wyolum/ClockIOT/Wiki/Images/ClockIOT_Flash_03.png

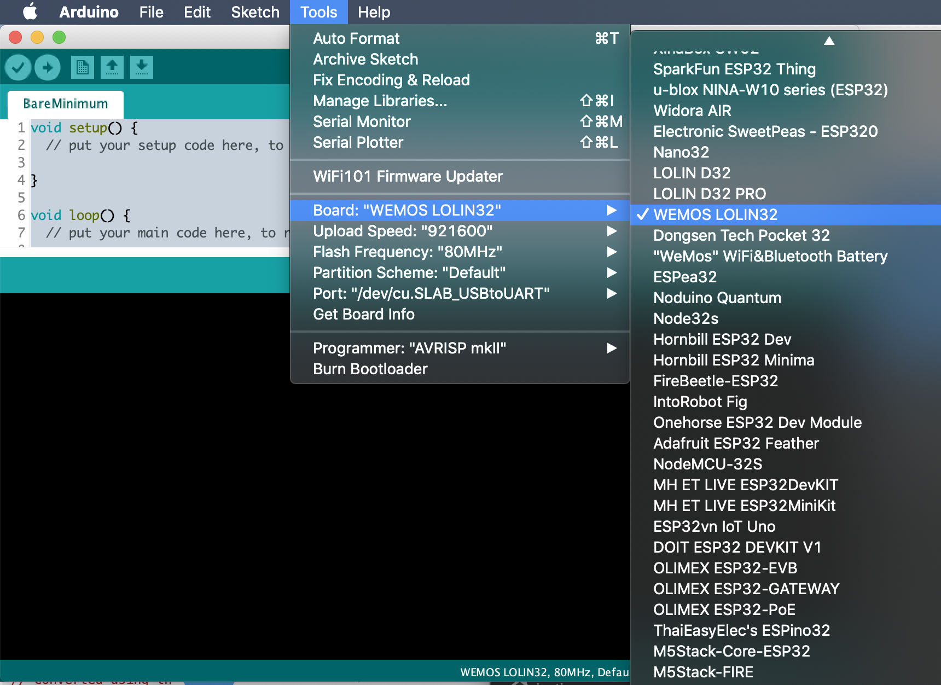
Wiki/Images/ClockIOT_Flash_03.png
