wyolum/ClockIOT/README.md

# ClockIOT
Word Clock

/kicad will be the latest HW version.
Earlier versions get sequentially numbered _v0, _v1 etc.
