wyolum/ClockIOT/arduino/ClockIOT/README.txt

To compile with Arduino:

Select WEMOS LOLIN32 from Tools->Board menu
