wyolum/ClockIOT/kicad/seeed_production_files/ClockIOT_PCB/ClockIOT_PCB_specification.xlsx

Sheet: Template
PCB Name 名称 | ClockIOT rev 5
Board Size 尺寸 | Length*width (Unit:inch) | 6.4 | * | 7.65
Material 板材 | (Rigid) FR－4 | Special Requirement:
Layers 层数 | 2 | Special Requirement:
Thickness 厚度 | 1.6 mm | Special Requirement:
Copper Weight 铜厚 | 1 oz. | Special Requirement:
Soldermask Color 阻焊颜色 | BLACK | Special Requirement:
Silkscreen Color 丝印颜色 | WHITE | Special Requirement:
Surface Finishing 焊盘喷镀 | HASL Lead Free | Special Requirement:
Via soldermask 阻焊覆盖 | Soldermask Cover | Special Requirement:
Mini trace/spacing 最小线宽 | 0.20 mm | Special Requirement:
Mini hole size 最小孔径 | 0.40 mm | Special Requirement:
Special requirements 特殊工艺
 | Other Special requirements：

Sheet: Parameter
PCB Material | Layers | Thickness | Copper Weight | Soldermask Color | Silkscreen Color | Surface Finishing | Via soldermask | Mini trace/spacing | Mini hole size
FR-4 | 1 Layer | 0.6mm | 0.5 oz | Green | White | HASL Lead Free(RoHS) | Soldermask Cover | 4 mil or 0.10 mm | 6 mil or 0.15 mm
Flexible Printed Circuit | 2 Layer | 0.8mm | 1 oz | Red | Black | ENIG | Soldermask Opening | 5 mil or0.13 mm | 8 mil or 0.2 mm
Rogers 4003 | 4 Layer | 1.0mm | 2 oz | Blue | Yellow | OSP |  | 6 mil or 0.15 mm | 10 mil or 0.25 mm
Rogers 4350 | 6 Layer | 1.2mm | 3 oz | Black | Red | Immersion Tin |  | 8 mil or 0.20 mm | 12 mil or 0.30 mm
Taconic Series | 8 Layer | 1.3mm | Other | White | Other | Immersion Sliver
Aluminum-based material | 10 Layer | 1.6mm |  | Green Matte |  | Hard Gold
RF-35 | 12 Layer | 2.0mm |  | Blue Matte |  | Other
Arlon | 14 Layer | 2.5mm |  | Black Matte
Other | 16 Layer | 3.0mm |  | Other
 | Other | Other
