wyolum/ClockIOT/collateral/ClockIoT_QR_code_neg.jpg.pdf

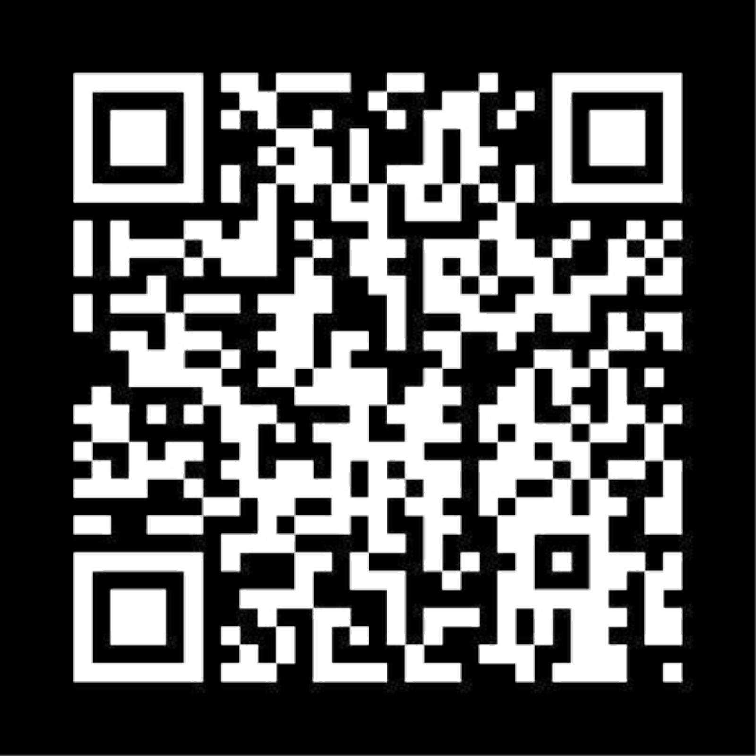
[picture p3: page 1]
