wyolum/ClockIOT/arduino/hardware/espressif/esp32/tools/partitions/default.csv

# Name | Type | SubType | Offset | Size | Flags
nvs | data | nvs | 0x9000 | 0x5000
otadata | data | ota | 0xe000 | 0x2000
app0 | app | ota_0 | 0x10000 | 0x140000
app1 | app | ota_1 | 0x150000 | 0x140000
eeprom | data | 0x99 | 0x290000 | 0x1000
spiffs | data | spiffs | 0x291000 | 0x16F000
