wyolum/ClockIOT/ClockIOT_data/USB-C_breakout/0J9079.1200.jpg

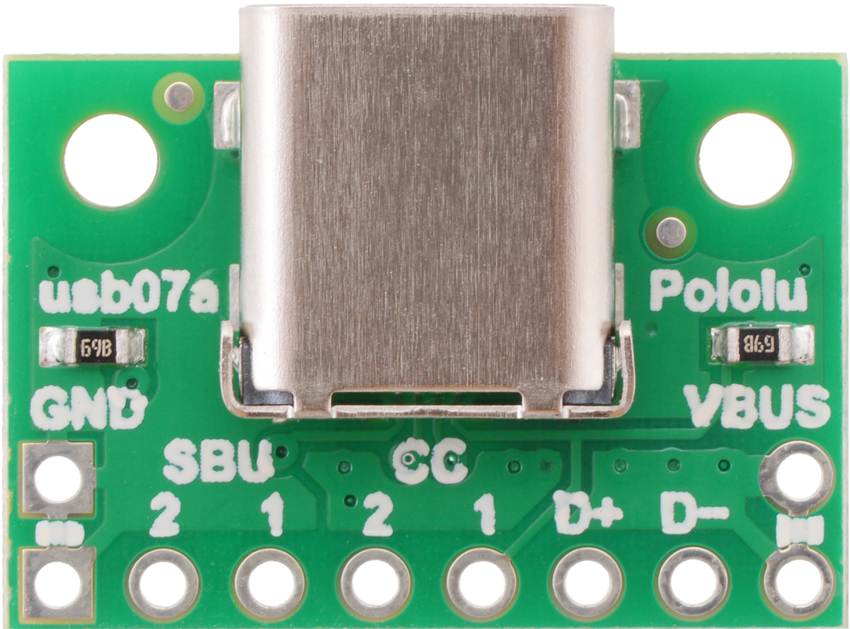
ClockIOT_data/USB-C_breakout/0J9079.1200.jpg
