wyolum/ClockIOT/ClockIOT_data/USB-C_breakout/0J9080.600x480.jpg

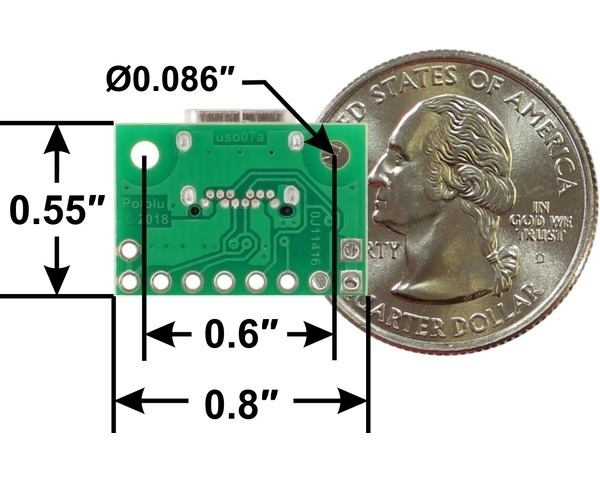
ClockIOT_data/USB-C_breakout/0J9080.600x480.jpg
