wyolum/ClockIOT/kicad/3d_render/ClockIOT01.png

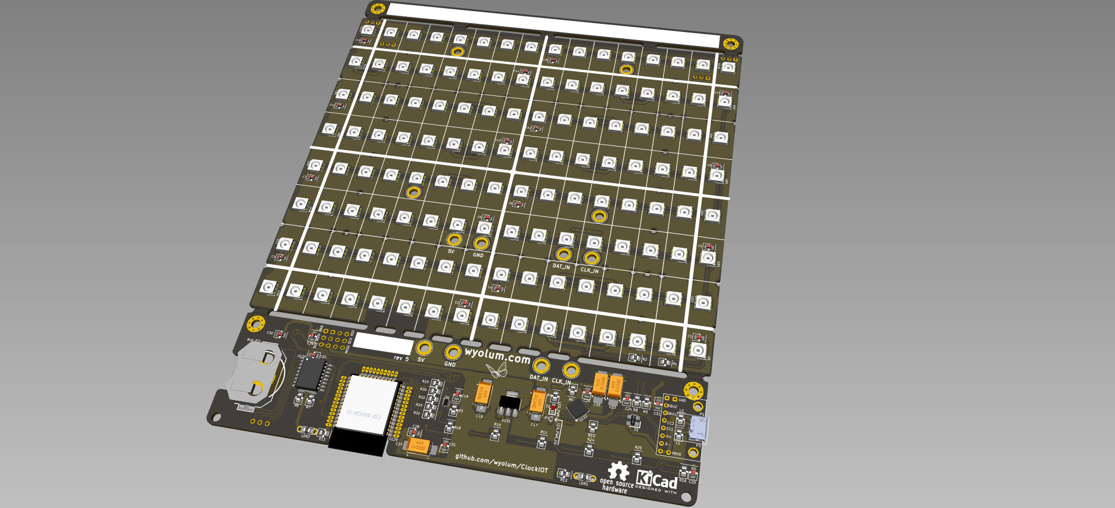
kicad/3d_render/ClockIOT01.png
