wyolum/ClockIOT/kicad/3d_render/ClockIOT02.png

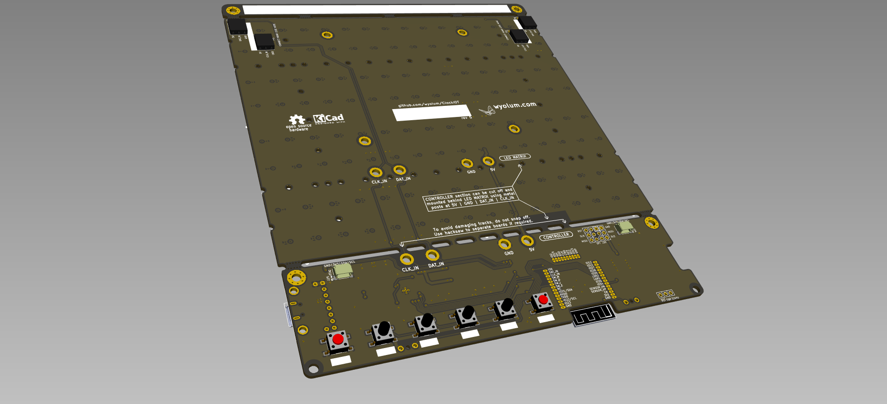
kicad/3d_render/ClockIOT02.png
