wyolum/ClockIOT/kicad/3d_render/ClockIOT03.png

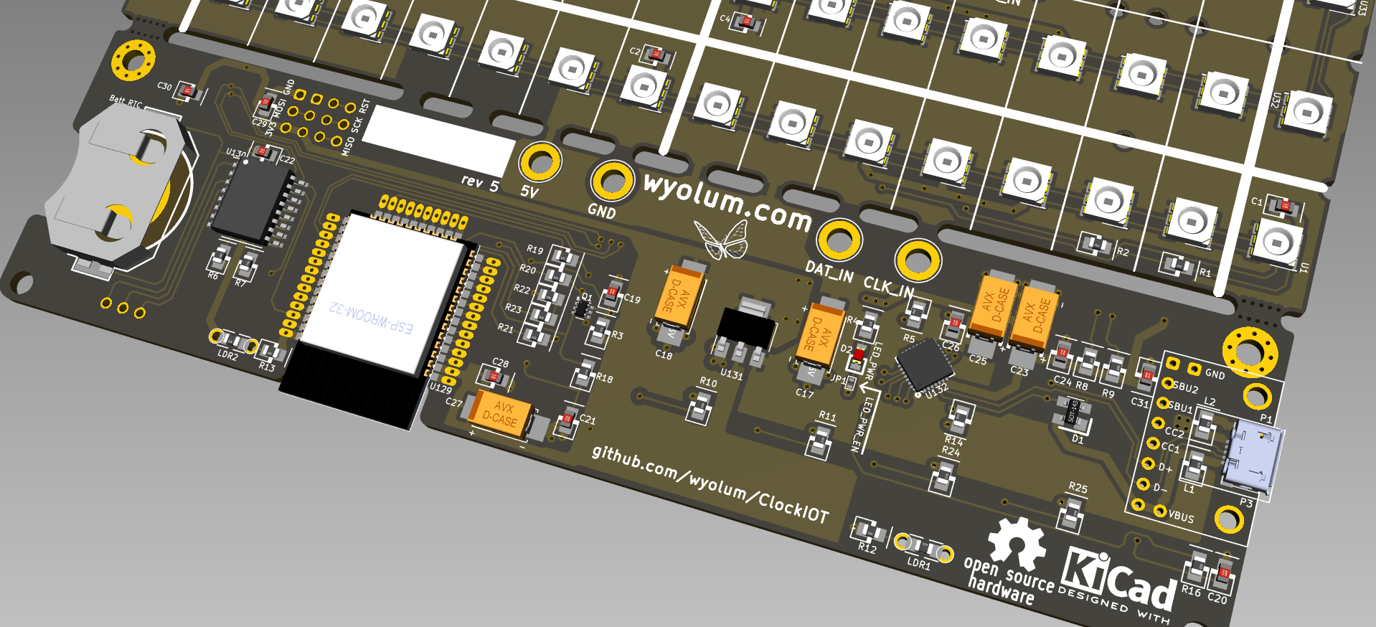
kicad/3d_render/ClockIOT03.png
