wyolum/ClockIOT/kicad/3d_render/ClockIOT04.png

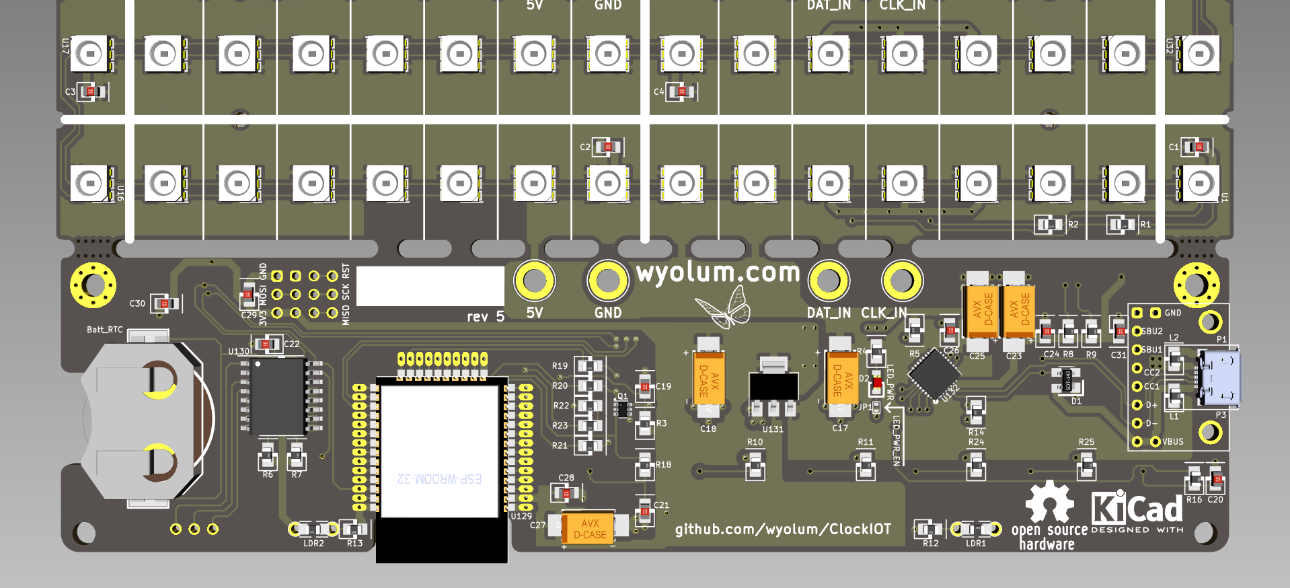
kicad/3d_render/ClockIOT04.png
