wyolum/ClockIOT/kicad/3d_render/ClockIOT05.png

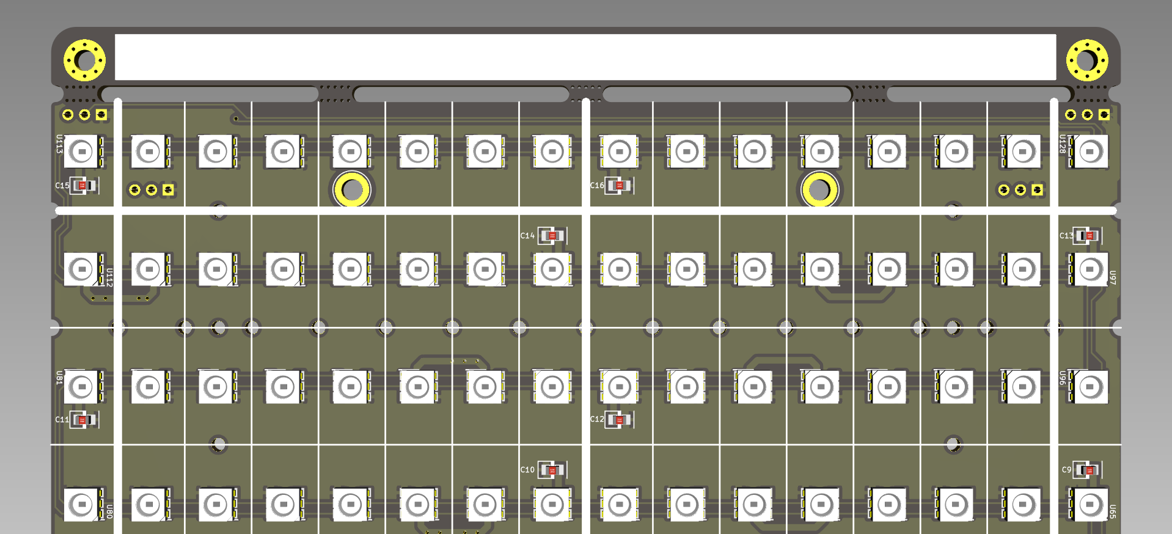
kicad/3d_render/ClockIOT05.png
