wyolum/ClockIOT/kicad/3d_render/ClockIOT06.png

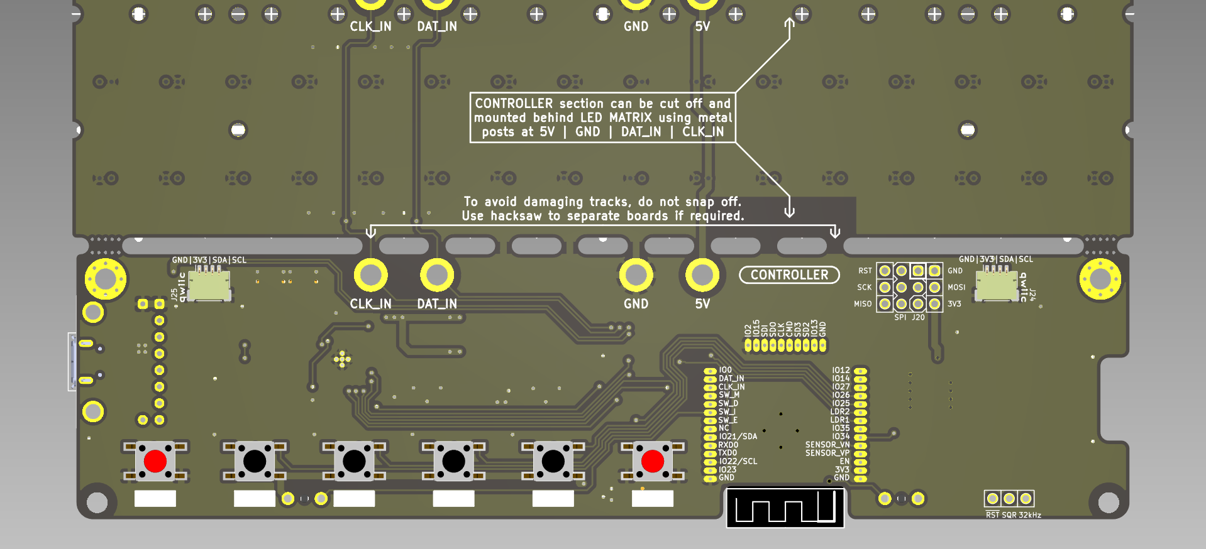
kicad/3d_render/ClockIOT06.png
