wyolum/ClockIOT/kicad/3d_render/ClockIOT07.png

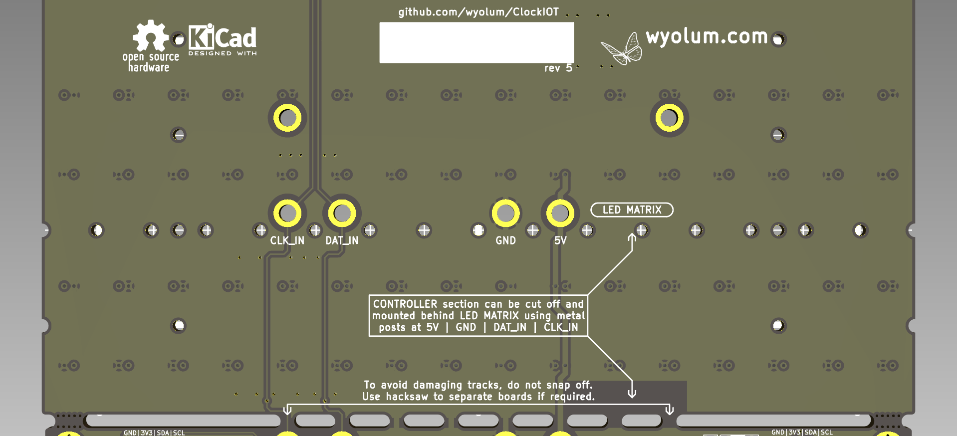
kicad/3d_render/ClockIOT07.png
