wyolum/ClockIOT/kicad/3d_render/ClockIOT08.png

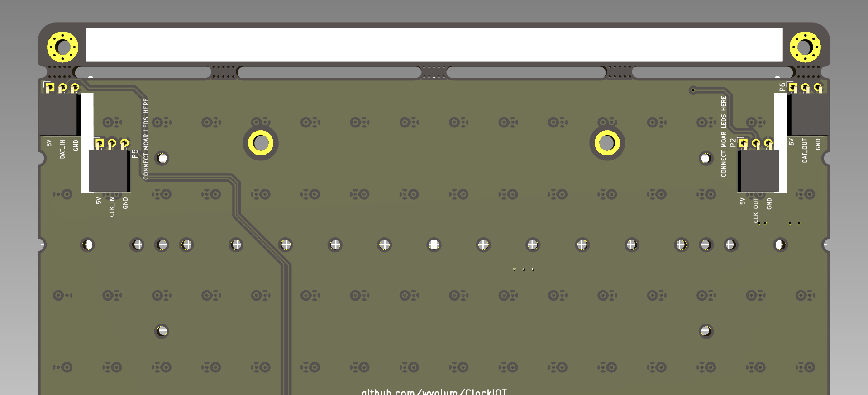
kicad/3d_render/ClockIOT08.png
