wyolum/ClockIOT/kicad/3d_render/ClockIOT09.png

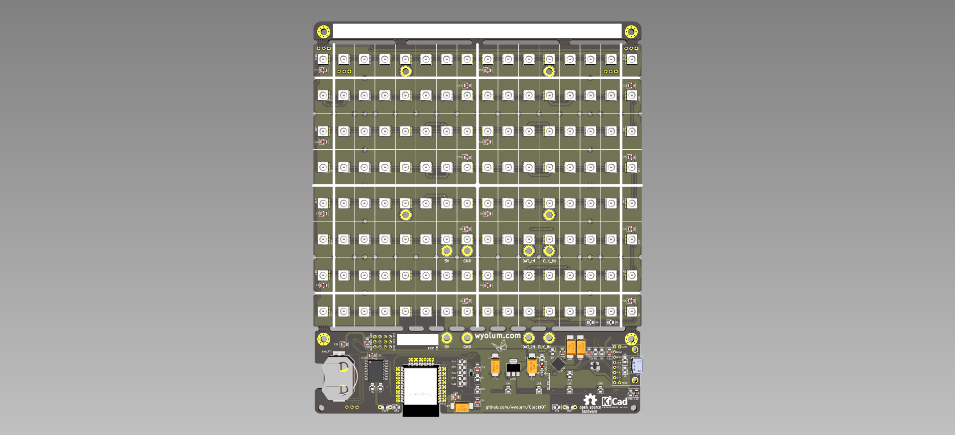
kicad/3d_render/ClockIOT09.png
