wyolum/ClockIOT/kicad/3d_render/ClockIOT10.png

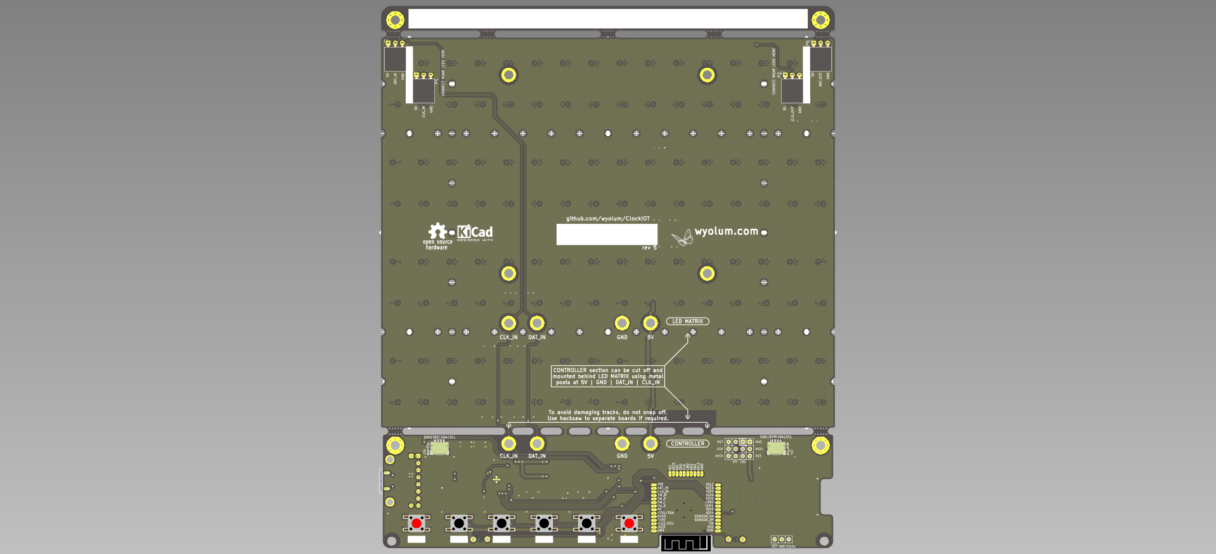
kicad/3d_render/ClockIOT10.png
