wyolum/ClockIOT/kicad/3d_render/ClockIOT11.png

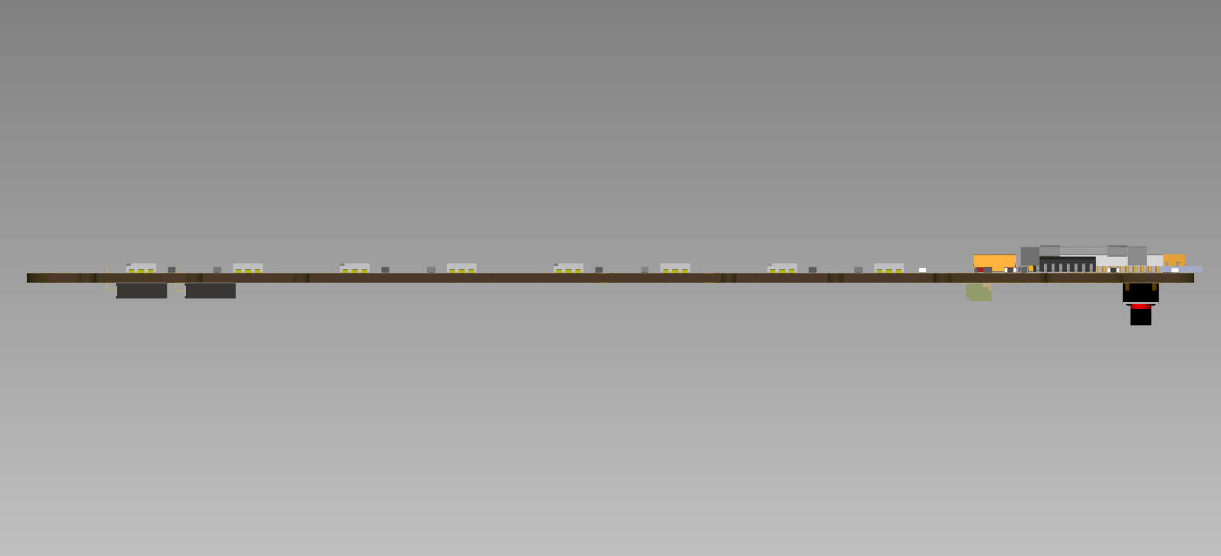
kicad/3d_render/ClockIOT11.png
