wyolum/ClockIOT/kicad/3d_render/ClockIOT12.png

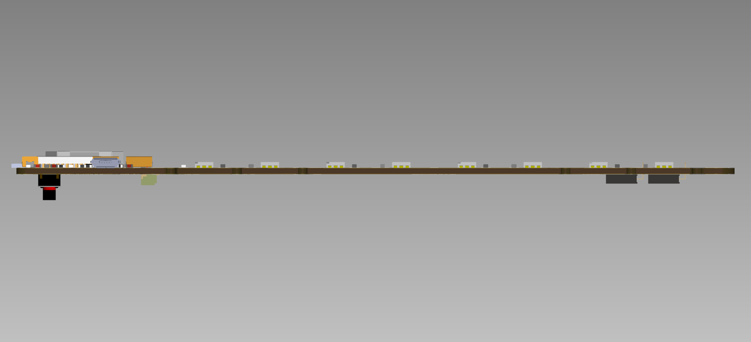
kicad/3d_render/ClockIOT12.png
