wyolum/ClockIOT/kicad/3d_render/ClockIOT13.png

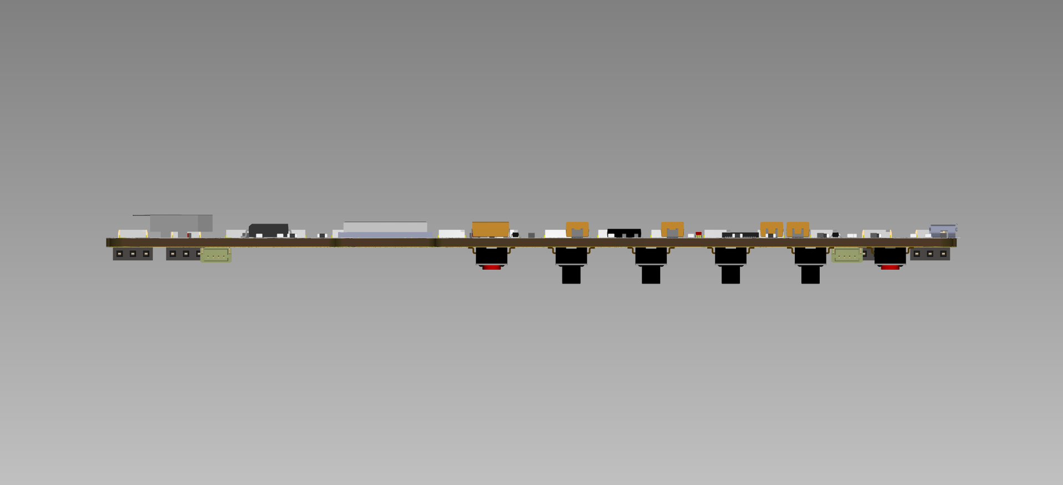
kicad/3d_render/ClockIOT13.png
