wyolum/ClockIOT/kicad/3d_render/ClockIOT15.png

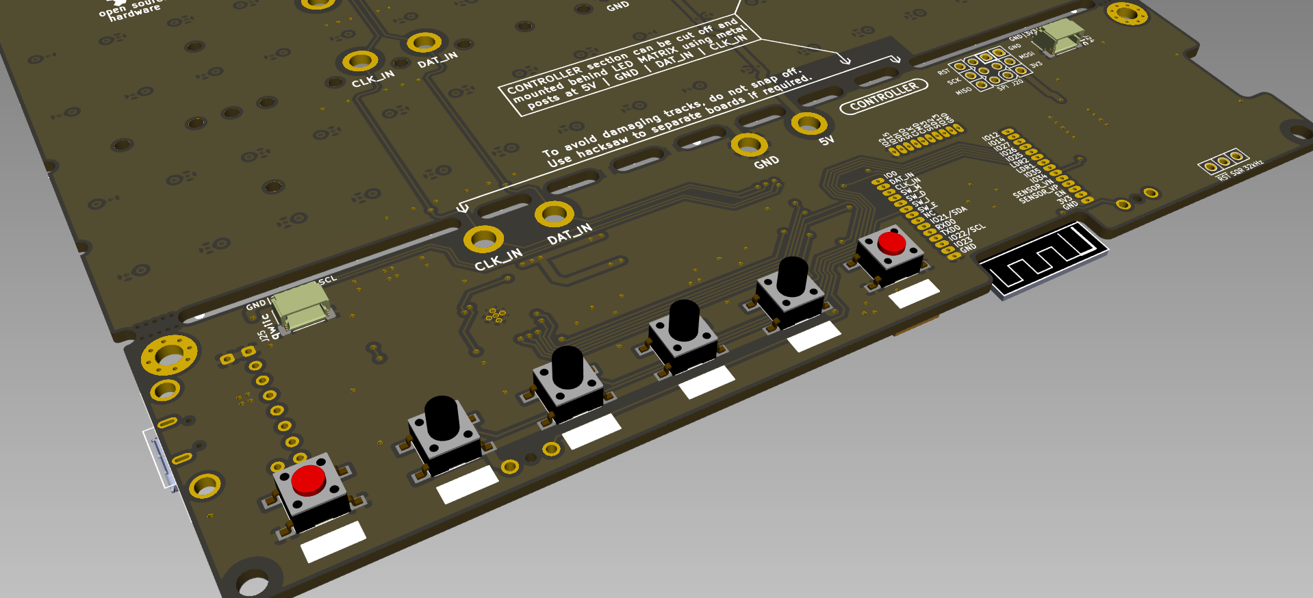
kicad/3d_render/ClockIOT15.png
