wyolum/ClockIOT/kicad/3d_render_with_USB-C/ClockIOT03.png

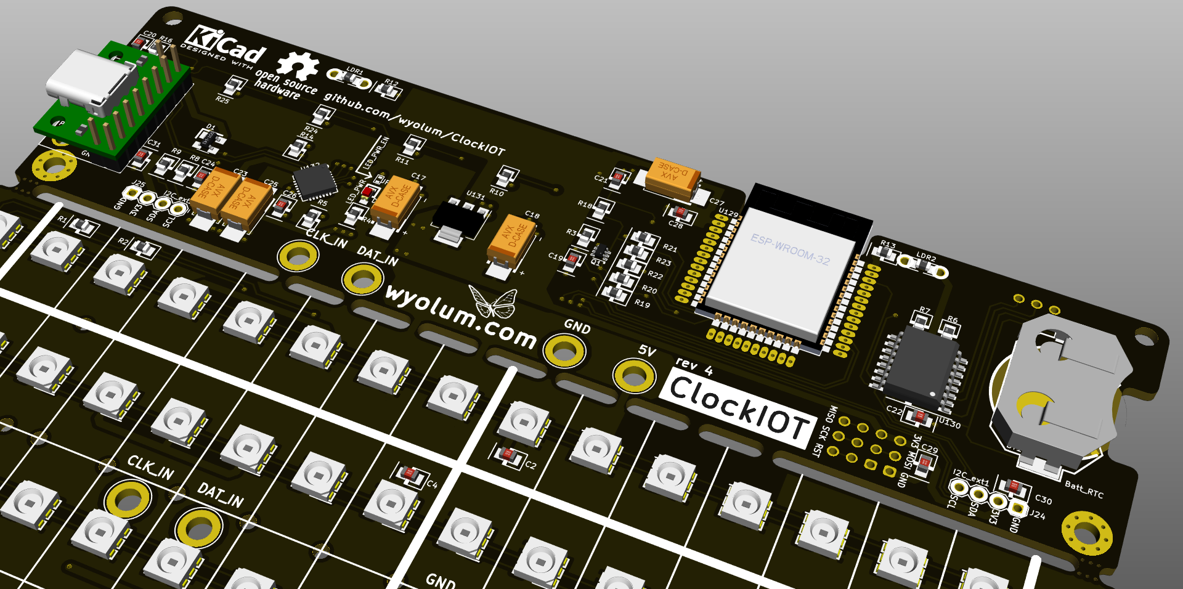
kicad/3d_render_with_USB-C/ClockIOT03.png
