wyolum/ClockIOT/kicad/3d_render_with_USB-C/ClockIOT05.png

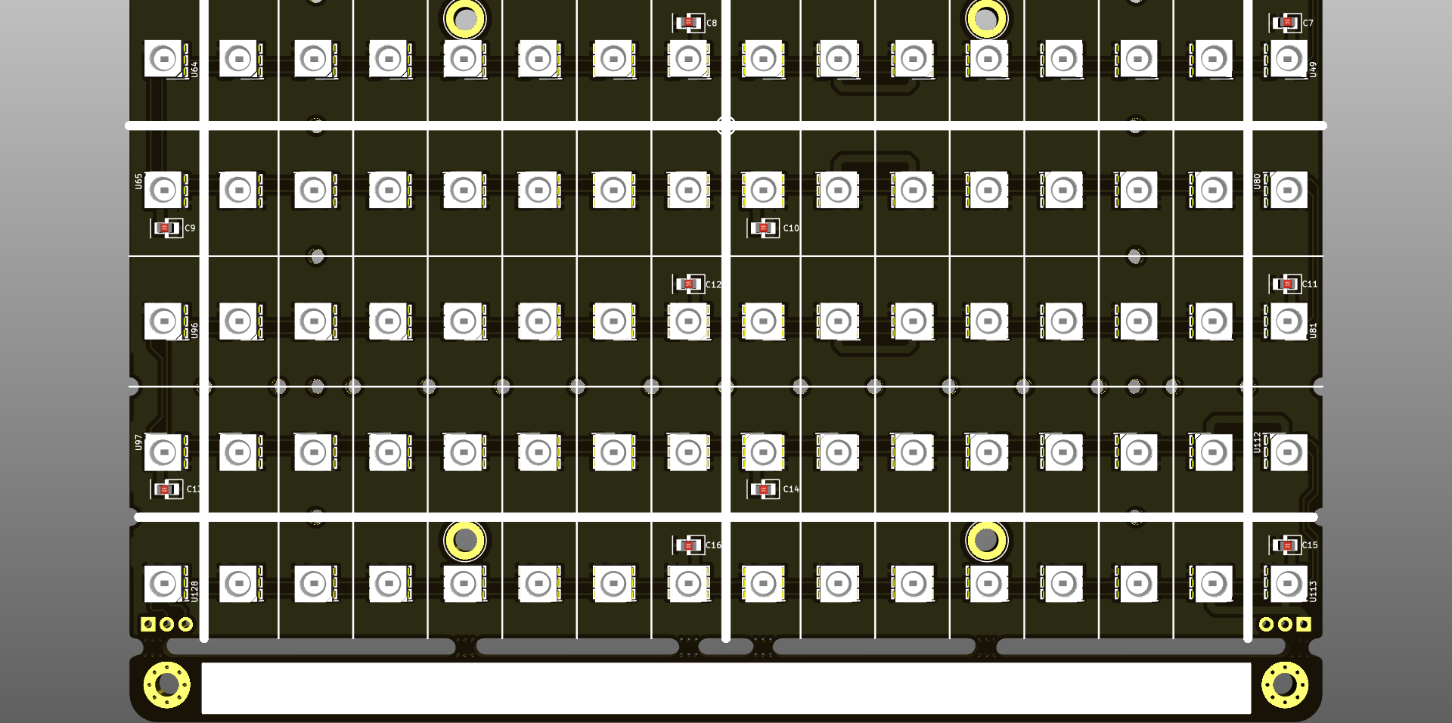
kicad/3d_render_with_USB-C/ClockIOT05.png
