wyolum/ClockIOT/kicad/3d_render_with_USB-C/ClockIOT06.png

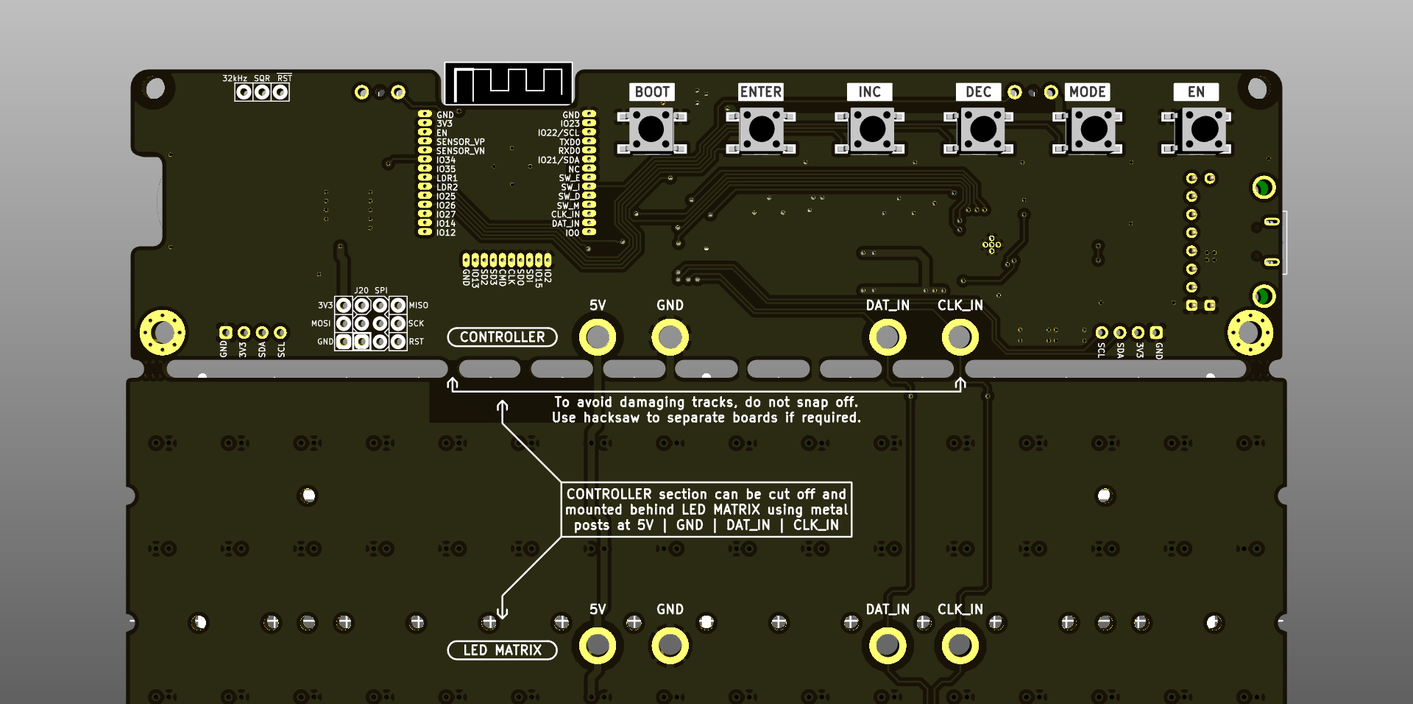
kicad/3d_render_with_USB-C/ClockIOT06.png
