wyolum/ClockIOT/kicad/3d_render_with_USB-C/ClockIOT09.png

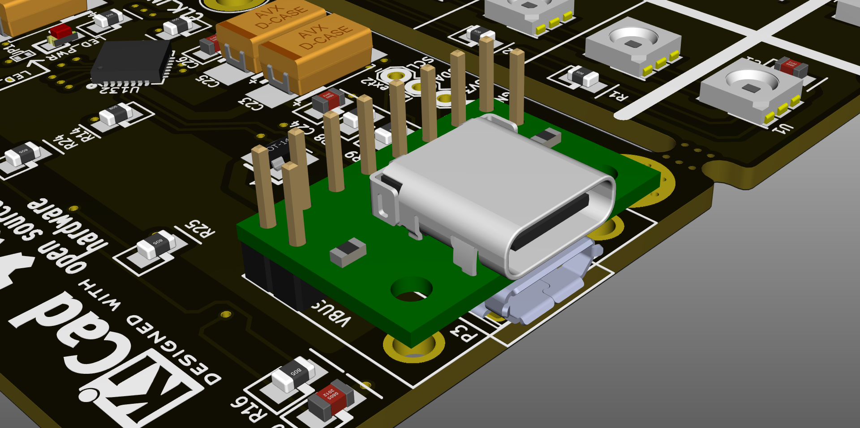
kicad/3d_render_with_USB-C/ClockIOT09.png
