wyolum/ClockIOT/kicad/seeed_production_files/collateral/ClockIOT_sticker.png

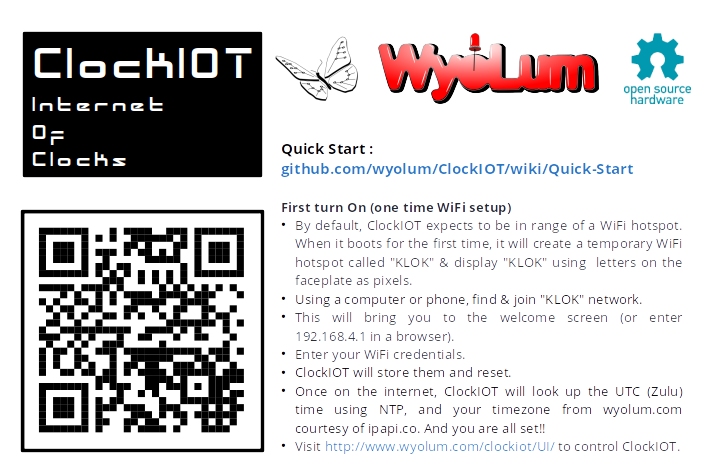
kicad/seeed_production_files/collateral/ClockIOT_sticker.png
