wyolum/ClockIOT/kicad/seeed_production_files/Power_Supply/power supply 1.jpg

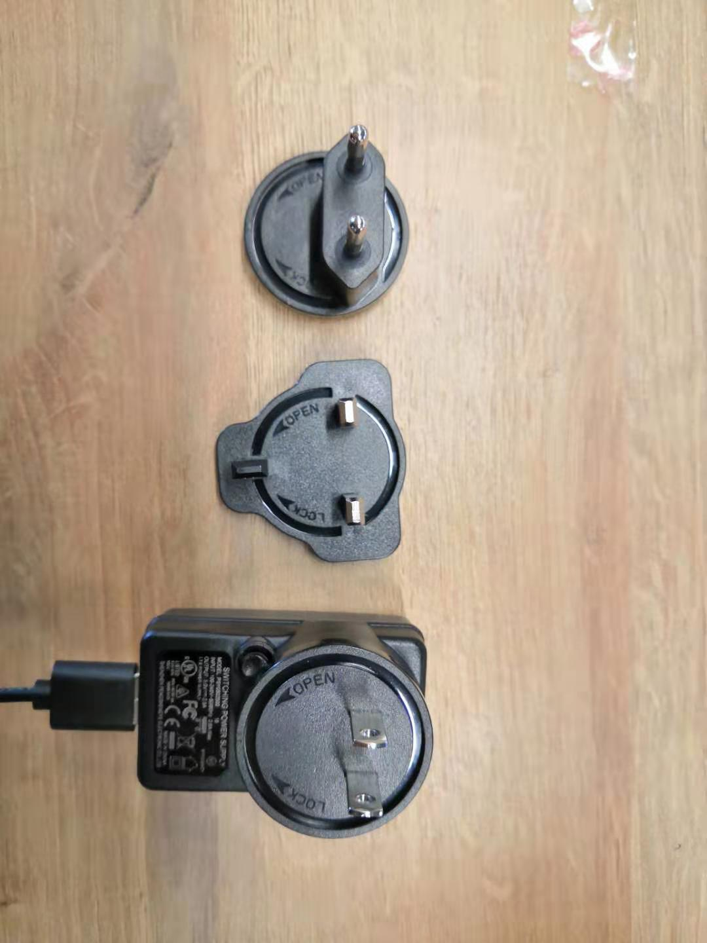
kicad/seeed_production_files/Power_Supply/power supply 1.jpg
