wyolum/ClockIOT/kicad/seeed_production_files/Power_Supply/power supply 2.jpg

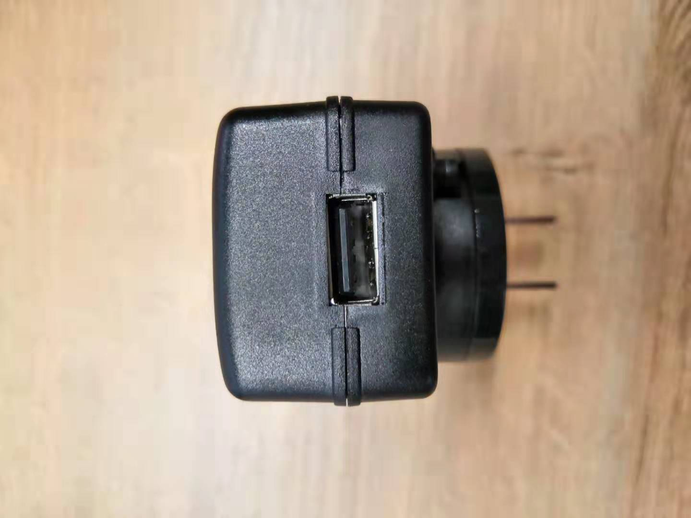
kicad/seeed_production_files/Power_Supply/power supply 2.jpg
