wyolum/ClockIOT/webui/timezonepicker/images/gray-450.png

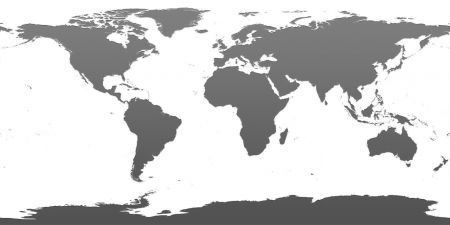
webui/timezonepicker/images/gray-450.png
