wyolum/ClockIOT/Wiki/Images/ClockIOT_Flash_04.1.png

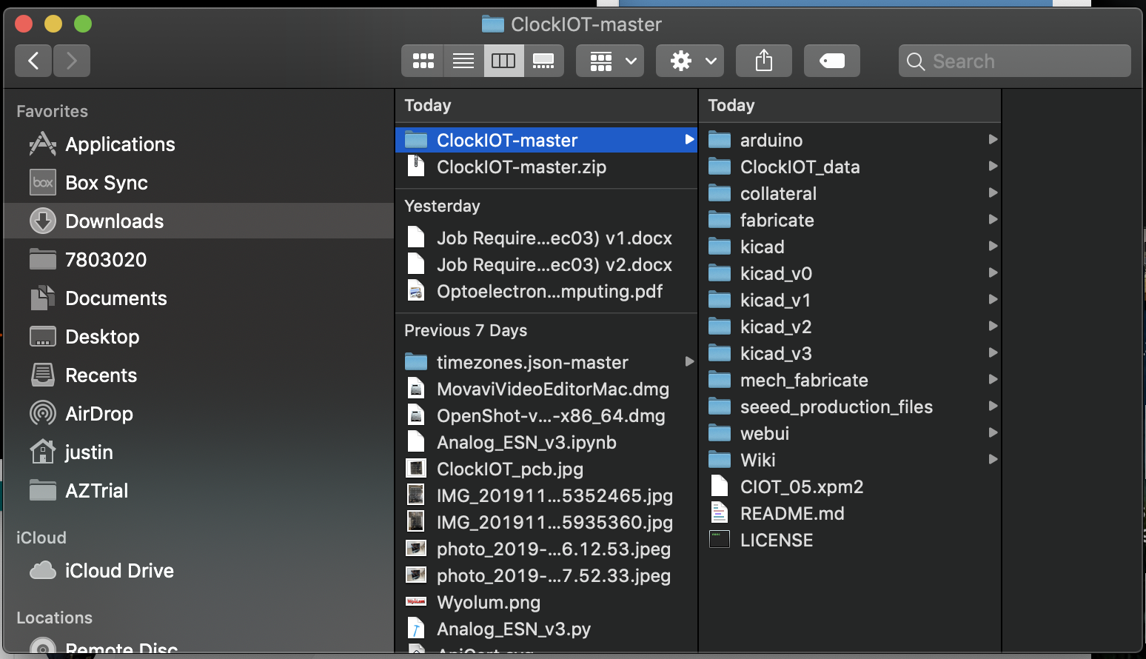
Wiki/Images/ClockIOT_Flash_04.1.png
