wyolum/ClockIOT/Wiki/Images/ClockIOT_Flash_04.png

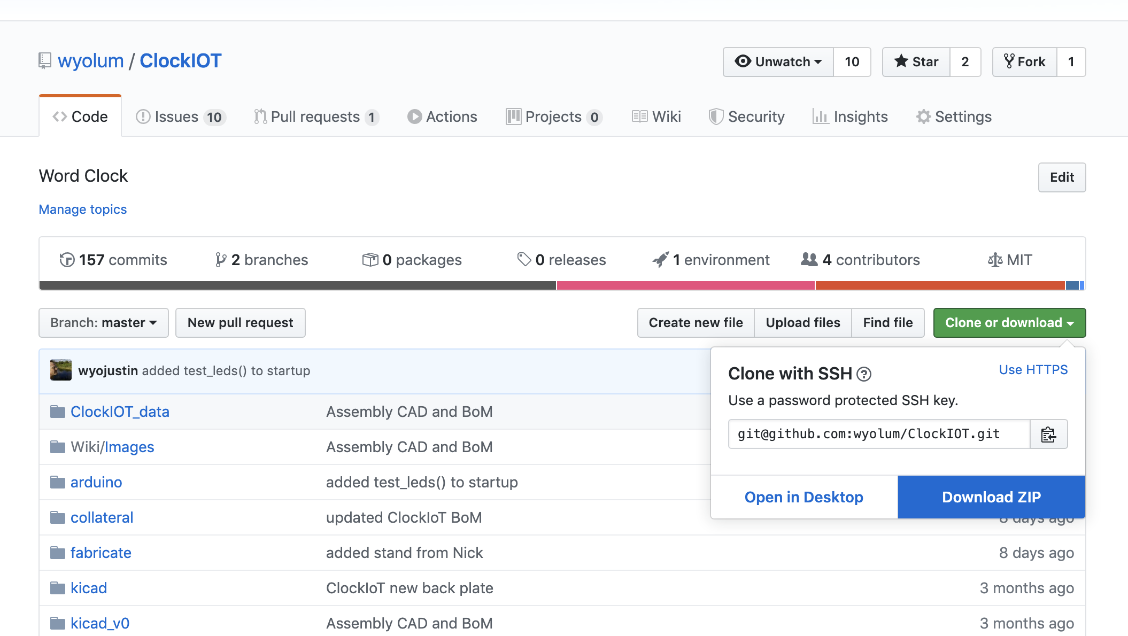
Wiki/Images/ClockIOT_Flash_04.png
