wyolum/ClockIOT/Wiki/Images/ClockIOT_Flash_05.png

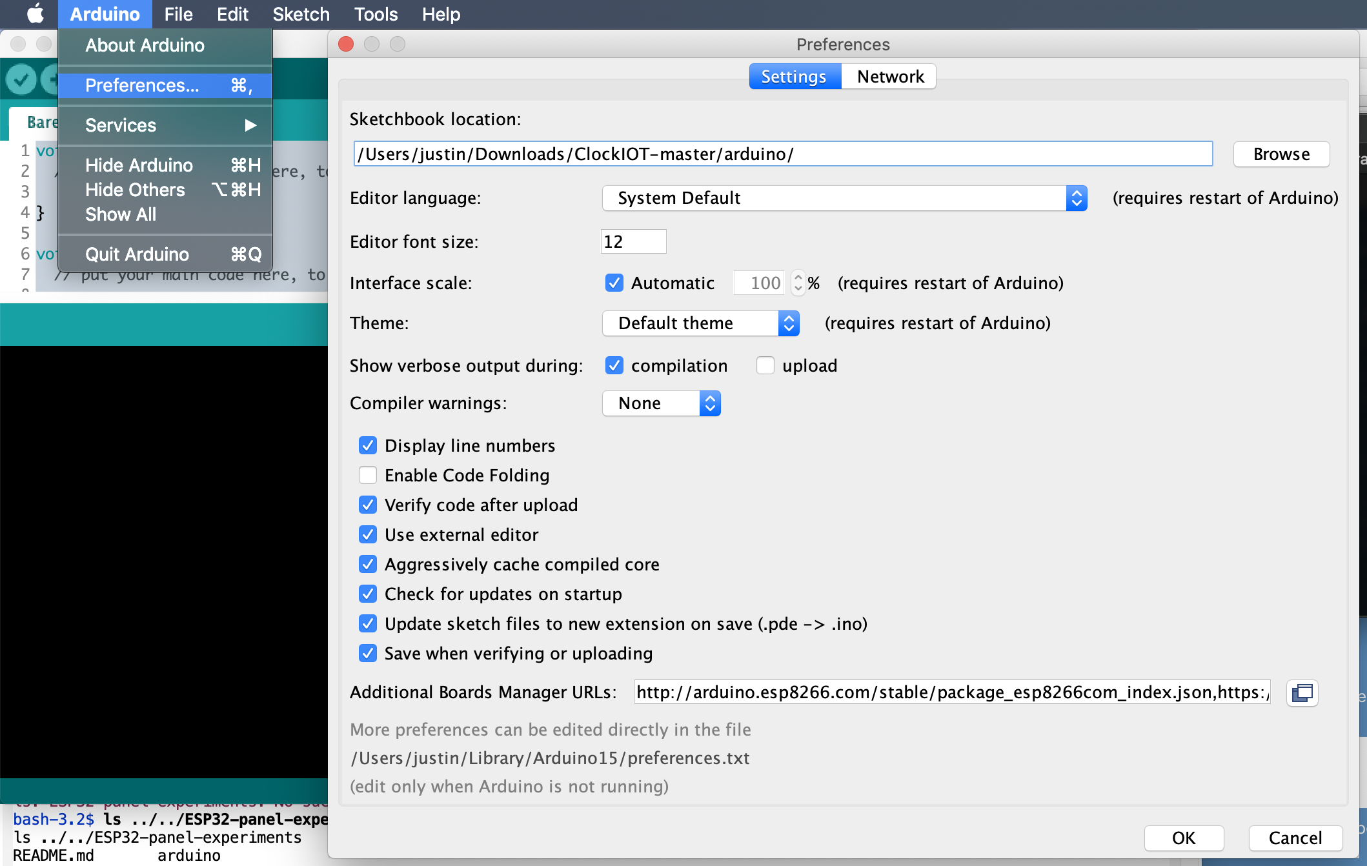
Wiki/Images/ClockIOT_Flash_05.png
