wyolum/ClockIOT/Wiki/Images/ClockIOT_Flash_06.png

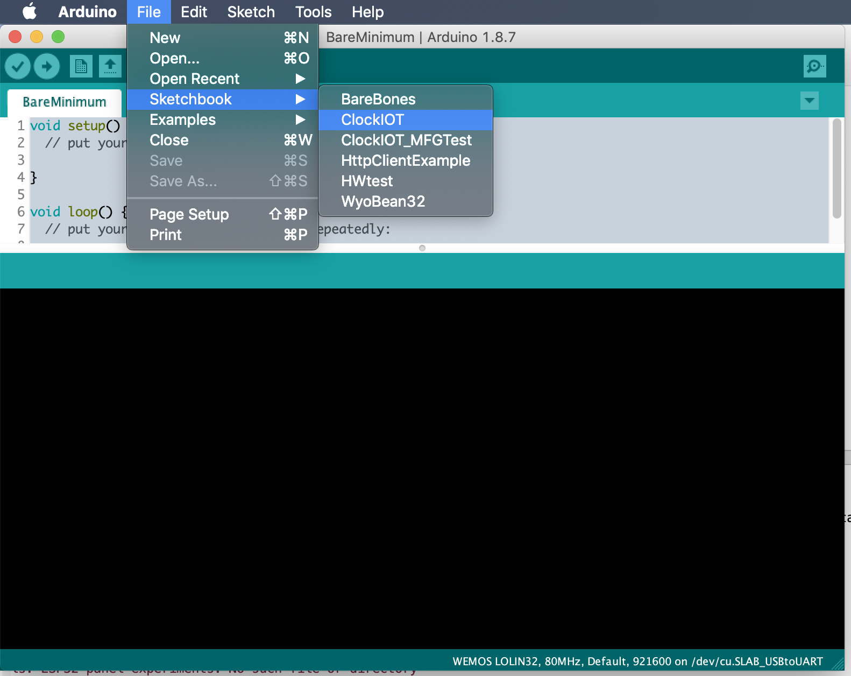
Wiki/Images/ClockIOT_Flash_06.png
