wyolum/ClockIOT/Wiki/Images/ClockIOT_Flash_07.1.png

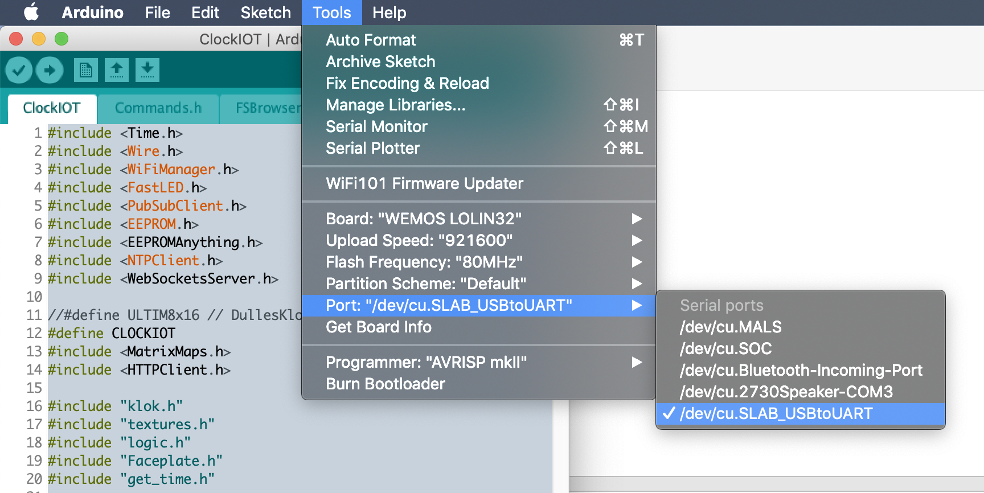
Wiki/Images/ClockIOT_Flash_07.1.png
