wyolum/ClockIOT/Wiki/Images/ClockIOT_Flash_07.png

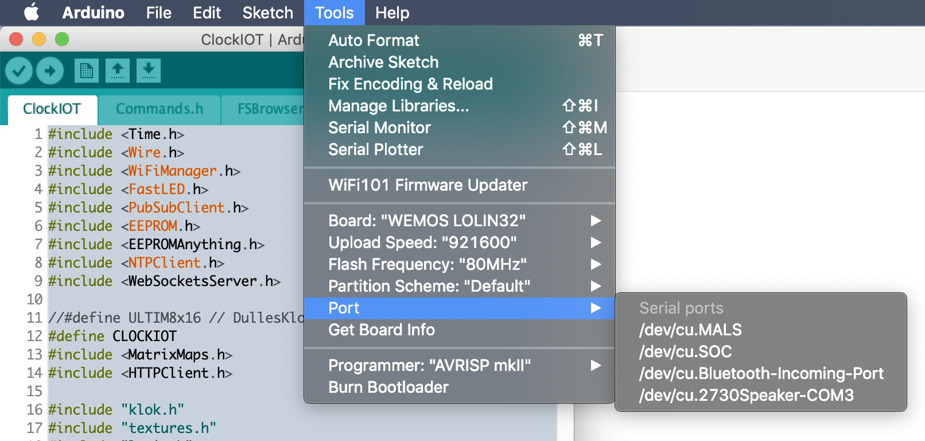
Wiki/Images/ClockIOT_Flash_07.png
