wyolum/ClockIOT/Wiki/Images/ClockIOT_Flash_08.1.png

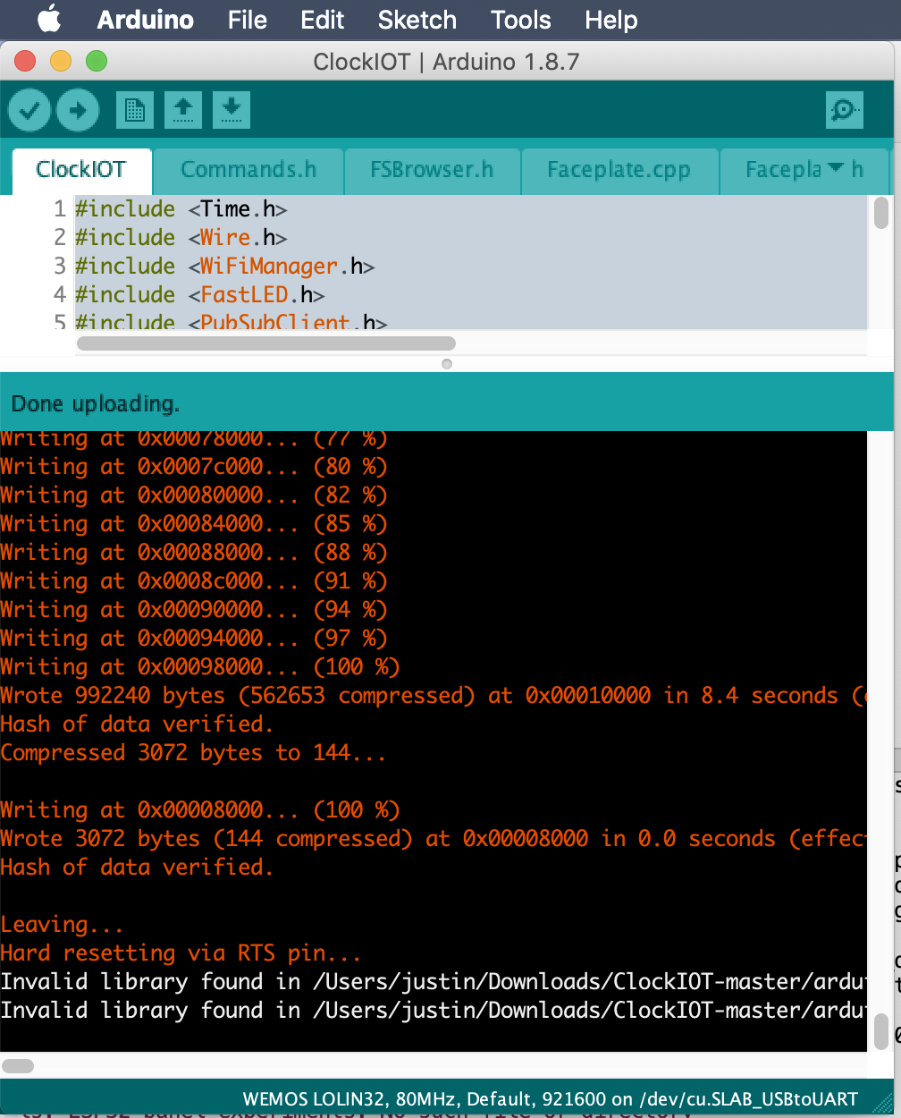
Wiki/Images/ClockIOT_Flash_08.1.png
