wyolum/ClockIOT/Wiki/Images/ClockIOT_Flash_08.png

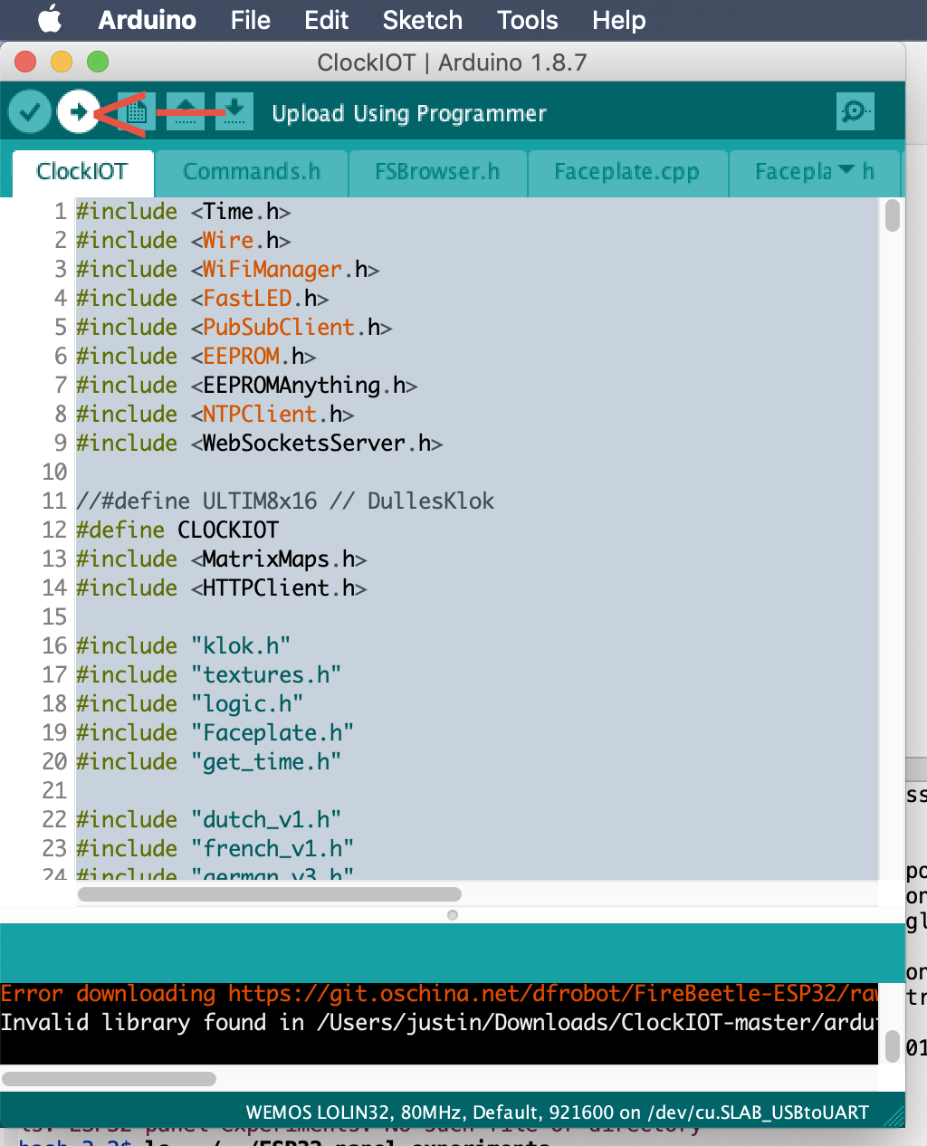
Wiki/Images/ClockIOT_Flash_08.png
