wyolum/ClockIOT/Wiki/Images/klok.png

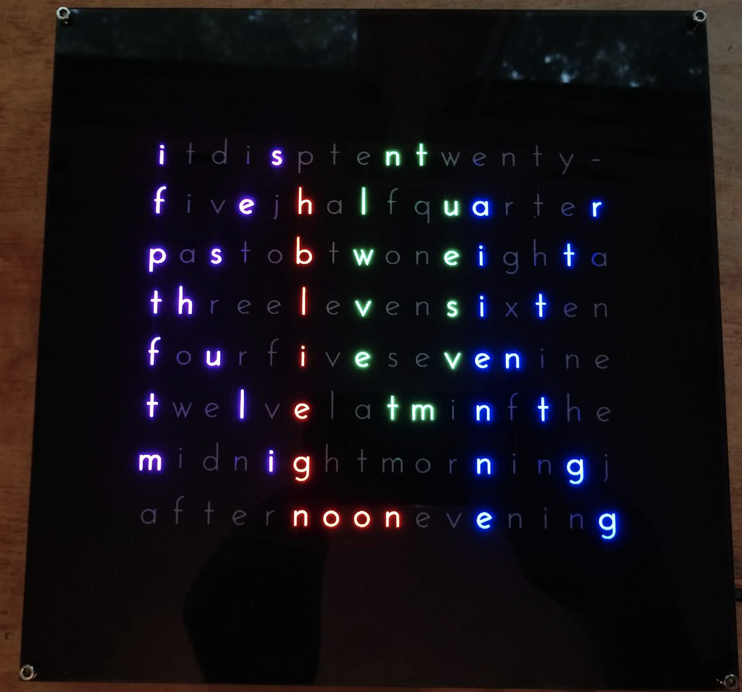
Wiki/Images/klok.png
