wyolum/ClockIOT/Wiki/Images/not_secure.png

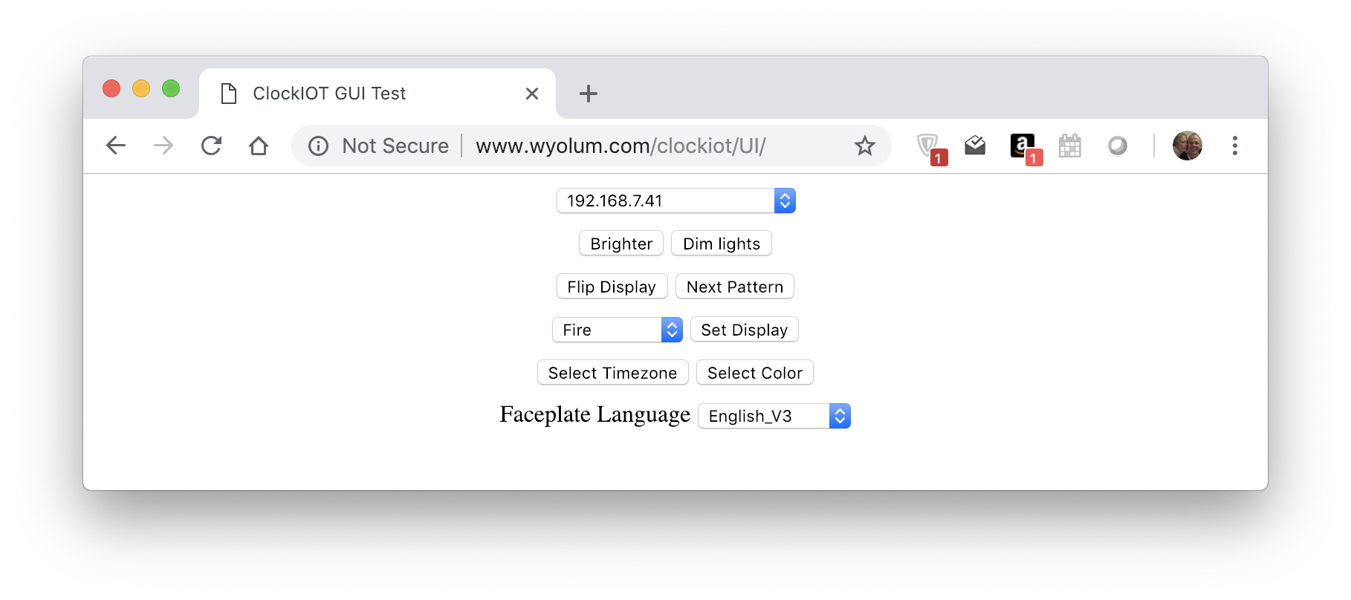
Wiki/Images/not_secure.png
