wyolum/ClockIOT/Wiki/Images/path8313.png

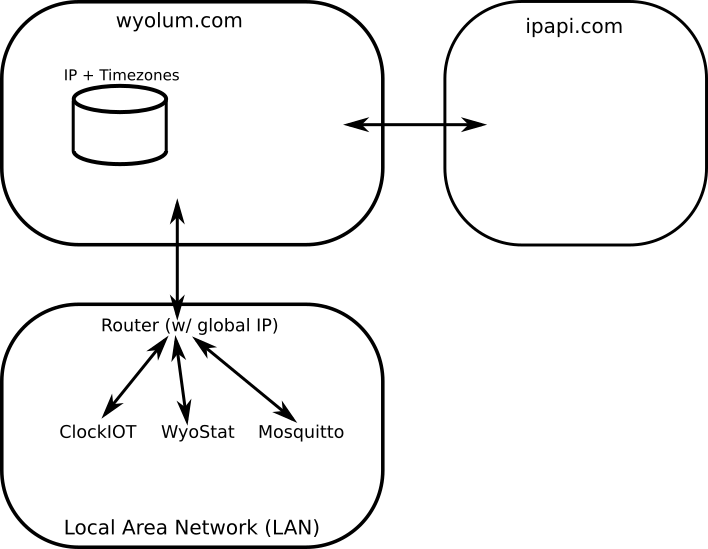
Wiki/Images/path8313.png
