wyolum/ClockIOT/Wiki/Images/saved.png

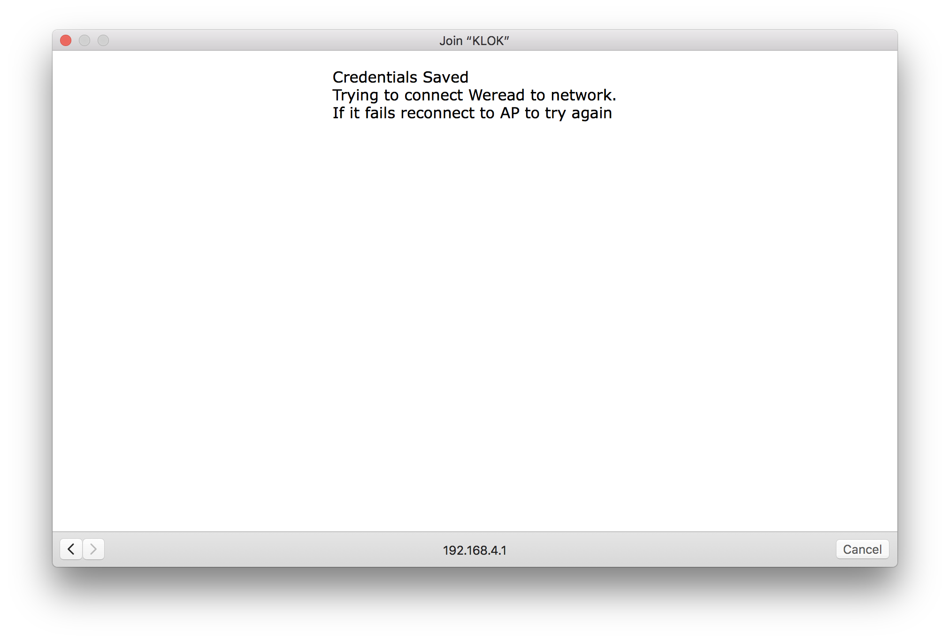
Wiki/Images/saved.png
