wyolum/ClockIOT/Wiki/Images/signin.png

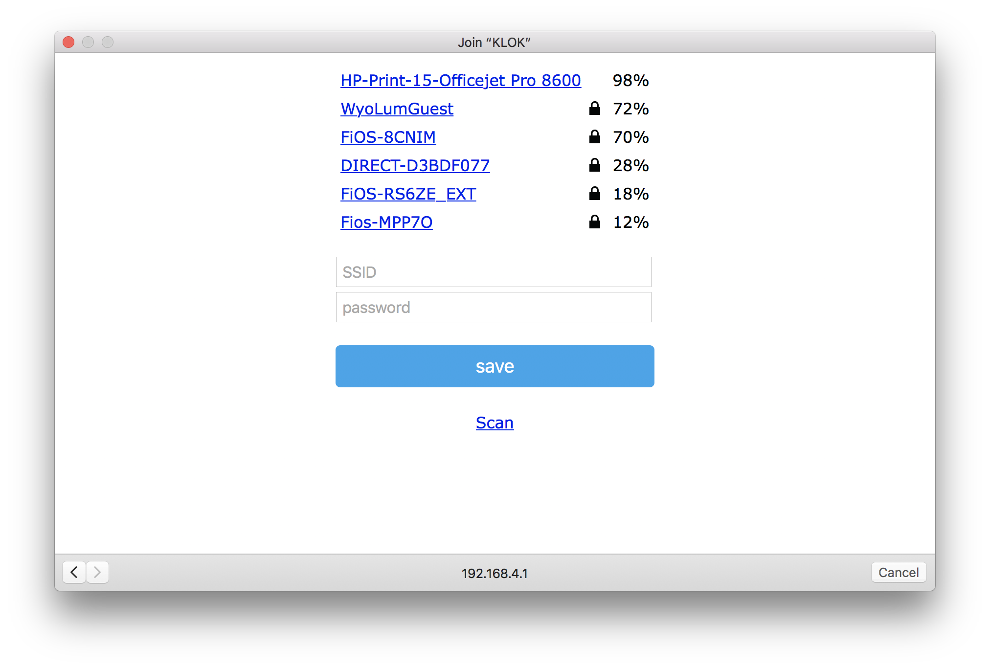
Wiki/Images/signin.png
