wyolum/ClockIOT/Wiki/Images/startup.png

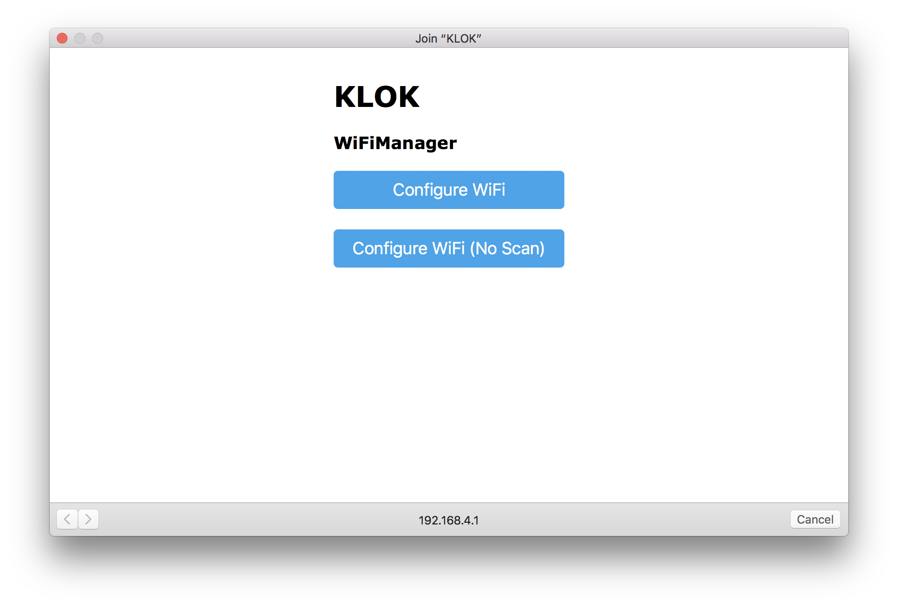
Wiki/Images/startup.png
