wyolum/ClockIOT/kicad/ClockIOT_bom_rev 5.xlsx

Sr No | Quantity Per PCB | References | Value | Footprint | Description | Part | Datasheet | manf# | Digikey | Field10 | Field8 | Field9 | Field4 | Field7 | Field6 | Field5 | Field11
1 | 1 | BT1 | Batt_RTC | CR2032_SMD_SKST-2007D |  | Batt_RTC |  |  | BU2032SM-HD-GCT-ND
2 | 22 | C1,C2,C3,C4,C5,C6,C7,C8,C9,C10,C11,C12,C13,C14,C15,C16,C22,C24,C26,C29,C30,C31 | 100nF | c_0805 |  | C_NP |  | Value
3 | 3 | C17,C23,C25 | 10uF/25V | c_2917 |  | C_POL
4 | 1 | C18 | 22uF/25V | c_2917 |  | C_POL
5 | 3 | C19,C20,C21 | 1nF | c_0805 |  | C_NP |  | Value
6 | 1 | C27 | 100uF/6V3 | c_2917 |  | C_POL
7 | 1 | C28 | 1uF/10V | c_0805 |  | C_NP
8 | 1 | D1 | PRTR5V0U2X | SOT-143 |  | Diode_TVS
9 | 1 | D2 | LED_PWR | LED-0805 |  | LED |  |  |  | 754-1264-ND | WP7113ID | Digikey | LED SS 5MM 625NM RED DIFF | Kingbright Corp | Round with Domed Top, 5mm, T-1 3/4 | 2V, 10mA | http://www.digikey.com/product-detail/en/WP7113ID/754-1264-ND/1747663
10 | 2 | J24,J25 | qwiic | JST_SH_SM04B-SRSS-TB_1x04-1MP_P1.00mm_Horizontal | Generic connectable mounting pin connector, single row, 01x04, script generated (kicad-library-utils/schlib/autogen/connector/) | Conn_01x04_MountingPin | ~
11 | 2 | L1,L2 | 330E | r_0805 |  | IND_FERRITE_BEAD
12 | 2 | LDR1,LDR2 | LDR | r_0805_ldr_2 |  | LDR03
13 | 1 | P1 | USB_micro | USB_Micro-B_seeed-320010561 |  | USB_micro
14 | 4 | P2,P4,P5,P6 | OUT_CLK, IN_DAT, IN_CLK, OUT_DAT | PinSocket_1x03_P2.54mm_Horizontal | Generic connector, single row, 01x03, script generated (kicad-library-utils/schlib/autogen/connector/) | Conn_01x03 | ~
15 | 1 | Q1 | DDC114TU | SOT-363_SC-70-6 | Pre-Biased Bipolar Transistor (BJT) 2 NPN - Pre-Biased (Dual) 50V 100mA 250MHz 200mW Surface Mount SOT-363 | DDC114TU | https://www.diodes.com/assets/Datasheets/ds30345.pdf
16 | 5 | R1,R2,R16,R18,R22 | 470R | r_0805 |  | R |  | Value
17 | 10 | R3,R6,R7,R10,R11,R12,R13,R14,R24,R25 | 10k | r_0805 |  | R |  | Value
18 | 2 | R4,R5 | 1k | r_0805 |  | R |  | Value
19 | 2 | R8,R9 | 4K7 | r_0805 |  | R | ~
20 | 2 | R19,R20 | 0R NC | r_0805 |  | R |  | Value
21 | 2 | R21,R23 | 0R | r_0805 |  | R |  | Value
22 | 1 | S1 | SW-ENTER | SW_SMD_311020004 |  | SW-SPST-M
23 | 1 | S2 | SW-INC | SW_SMD_311020004 |  | SW-SPST-M
24 | 1 | S3 | SW-EN | SW_SMD_311020004 |  | SW-SPST-M |  | Value
25 | 1 | S4 | SW-BOOT | SW_SMD_311020004 |  | SW-SPST-M |  | Value
26 | 1 | S5 | SW-DEC | SW_SMD_311020004 |  | SW-SPST-M
27 | 1 | S6 | SW-MODE | SW_SMD_311020004 |  | SW-SPST-M
28 | 128 | U1,U2,U3,U4,U5,U6,U7,U8,U9,U10,U11,U12,U13,U14,U15,U16,U17,U18,U19,U20,U21,U22,U23,U24,U25,U26,U27,U28,U29,U30,U31,U32,U33,U34,U35,U36,U37,U38,U39,U40,U41,U42,U43,U44,U45,U46,U47,U48,U49,U50,U51,U52,U53,U54,U55,U56,U57,U58,U59,U60,U61,U62,U63,U64,U65,U66,U67,U68,U69,U70,U71,U72,U73,U74,U75,U76,U77,U78,U79,U80,U81,U82,U83,U84,U85,U86,U87,U88,U89,U90,U91,U92,U93,U94,U95,U96,U97,U98,U99,U100,U101,U102,U103,U104,U105,U106,U107,U108,U109,U110,U111,U112,U113,U114,U115,U116,U117,U118,U119,U120,U121,U122,U123,U124,U125,U126,U127,U128 | APA102 | APA102 |  | APA102 |  | mfr_pn
29 | 1 | U129 | ESP-wroom-32 | esp_wroom_32 |  | ESP-wroom-32 |  | mfr_pn
30 | 1 | U130 | DS3231N | DS3231 |  | DS3231N | ~
31 | 1 | U131 | 1117-33 | SOT-223-3_TabPin2 | 1A Low Dropout regulator, positive, 1.5V fixed output, SOT-223 | AP1117-15 | http://www.diodes.com/datasheets/AP1117.pdf | mfr_pn
32 | 1 | U132 | CP2102N-A01-GQFN28 | QFN-28-1EP_5x5mm_Pitch0.5mm |  | CP2102N-A01-GQFN28 | http://www.silabs.com/support%20documents/technicaldocs/cp2102n-datasheet.pdf | Value
DNP
33 | 7 | BITE1 BITE2 BITE3 BITE4 BITE5 BITE6 BITE7 | Mouse_Bite | mouse-bite-0.3in-slot_OSH |  | Mouse_Bite |  | mfr_pn
34 | 2 | G1 G7 | LOGO_WL | Logo-WL3 |  | LOGO_WL |  | Value mfr_pn
35 | 2 | G2 G8 | KiCad | KiCad-Logo2_6mm_SilkScreen |  | KiCad |  | Value mfr_pn
36 | 2 | G3 G9 | OSHW | OSHW_6mm |  | OSHW |  | Value mfr_pn
37 | 44 | HB1 HB2 HB3 HB4 HB5 HB6 HB7 HB8 HB9 HB10 HB11 HB12 HB13 HB14 HB15 HB16 HB17 HB18 HB19 HB20 HB21 HB22 HB23 HB24 HB25 HB26 HB27 HB28 HB29 HB30 HB31 HB32 HB33 HB34 HB35 HB36 HB37 HB38 HB39 HB40 HB41 HB42 HB43 HB44 | hole_baffle | hole_baffle_2mm |  | SCREW |  | Value
38 | 4 | HB51 HB52 HB53 HB54 | mtg_hole_3mm | 1pin |  | SCREW |  | Value
39 | 2 | J1 J9 | CLK_IN | 1pin | Generic connector, single row, 01x01 | Conn_01x01 | ~
40 | 2 | J2 J10 | DAT_IN | 1pin | Generic connector, single row, 01x01 | Conn_01x01 | ~
41 | 2 | J7 J15 | 5V | 1pin | Generic connector, single row, 01x01 | Conn_01x01 | ~
42 | 2 | J8 J16 | GND | 1pin | Generic connector, single row, 01x01 | Conn_01x01 | ~
43 | 1 | J17 | MISO | BreakOutPad | Generic connector, single row, 01x01 | Conn_01x01 | ~
44 | 1 | J18 | 3V3 | BreakOutPad | Generic connector, single row, 01x01 | Conn_01x01 | ~ | mfr_pn
45 | 1 | J19 | SCK | BreakOutPad | Generic connector, single row, 01x01 | Conn_01x01 | ~ | mfr_pn
46 | 1 | J20 | SPI | Header_ISP | Generic connector, double row, 02x03, odd/even pin numbering scheme (row 1 odd numbers, row 2 even numbers), script generated (kicad-library-utils/schlib/autogen/connector/) | Conn_02x03_Odd_Even | ~
47 | 1 | J21 | MOSI | BreakOutPad | Generic connector, single row, 01x01 | Conn_01x01 | ~ | mfr_pn
48 | 1 | J22 | RST | BreakOutPad | Generic connector, single row, 01x01 | Conn_01x01 | ~ | mfr_pn
49 | 1 | J23 | GND | BreakOutPad | Generic connector, single row, 01x01 | Conn_01x01 | ~ | mfr_pn
50 | 1 | JP1 | LED_PWR_EN | R_0402 |  | Jumper_NC_Small
51 | 1 | P3 | USB-C_breakout | USB-C_bout |  | USB-C_breakout
 | Component Groups: | 54
 | Component Count: | 285
 | Fitted Components: | 285
 | Number of PCBs: | 1
 | Total components: | 285
 | Schematic Version: | rev 5
 | Schematic Date: | 2020-01-27
 | BoM Date: | Mon Jan 27 14:50:42 2020
 | Schematic Source: | /home/anool/projects-git/ClockIOT/kicad/ClockIOT.sch
 | KiCad Version: | Eeschema 5.1.5-52549c5~84~ubuntu18.04.1
