wyolum/ClockIOT/kicad/seeed_production_files/ClockIOT_ASSEMBLY/ClockIOT_BoM_seeed_RetailClock_v5.xls

Electronic Engineering BOM List
Product Name： ClockIoT – Retail , complete assembled unit
Version：V5.0
Issue Date：27/JAN/2020
Item No. (序号) | Reference Des (上件位置) | Qty (用量) | Catalog (分类） | Part_Description (规格描述) | Part_Value （元件值） | Part_Package （元件封装） | Manufacturers Name (使用厂牌名称) | Manufacturers Part No. (使用厂牌型号) | Distributors Name （供应商名称） | Distributors Part No. (供貨商型号) | Unit Price （单价） | Price Break To Use （价格分段的购买量） | Notes/Remark （备注）
Example（填写范例）
1 |  | 1 | OTHER | ClockIOT kit from Seeed BOM |  |  | Seeed Studio Parts kit and PCB from supplied BOM
2 |  | 18 | OTHER | Vertical Baffle (0.06" Acrylic Black) |  | 0.06” Thick Acrylic, Black | Laser Cut | ciot_baffle_V_01.pdf
3 |  | 10 | OTHER | Horizontal Baffle (0.06" Acrylic Black) |  | 0.06” Thick Acrylic, Black | Laser Cut | ciot_baffle_H_01.pdf
4 |  | 1 | OTHER | Back Plate (.25" Lightly Smoked Acrylic) |  | 0.25” Thick, Acrylic, Black | Laser Cut + Engrave | ciot_backplate_01.pdf
5 |  | 1 | OTHER | Front Plate (0.25" Acrylic) |  | 0.25” Thick, Acrylic, Mirrored | Laser Cut + Engrave
6 |  | 4 | OTHER | M3 Stand Offs 20mm, - Part No : 94868A176 (we prefer ROUND, not HEX) |  | Standoff, M3x20mm, Round, SS | McMaster | 94868A176 |  |  |  |  | http://www.mcmaster.com/#standard-threaded-standoffs/=jrofov
7 |  | 4 | OTHER | M3 16mm low head hex screws - Part No : 92855A316 |  | Screw, M3x16mm, Low Head Socket, SS | McMaster | 92855A316 |  |  |  |  | http://www.mcmaster.com/#metric-socket-head-cap-screws/=jroaog
8 |  | 8 | OTHER | M3 12mm low head hex screws - Part No : 92855A313 |  | Screw, M3x12mm, Low Head Socket, SS | McMaster | 92855A313 |  |  |  |  | http://www.mcmaster.com/#metric-socket-head-cap-screws/=jroaog
9 |  | 8 | OTHER | M3 hex nut - Part No : 91828A211 |  | Nut, M3, Hex, SS | McMaster | 91828A211 |  |  |  |  | http://www.mcmaster.com/#metric-hex-nuts/=jroctc
10 |  | 1 | OTHER | Power Supply (usb adapter) | 5V / 2.5A | Wall Wart with International plug pins | SHENZHEN PENGSHENGYE ELECTRONIC CO.,LTD | PSY0502500 | Seeed Studio (please TEST)
11 |  | 1 | OTHER | USB Cable, Type B to Micro (Black 6') |  |  |  |  | Seeed Studio
12 |  | 1 | OTHER | Velum Paper, A5 Landscape |  | A5 Landscape
1. Recommended Distributor: Digi-Key, Mouser, Avnet Express, Farnell.
2. Catalog: Capacitor,Resister,Diode,Connector,Transistor,IC,PROTECTOR CATEGORY,OTHER
3. Required Fields: Item No, Reference Des, Qty, Catalog, Part_Value, Part Package
Optional Fields: Part_Description, Manufacturers Name, Manufacturers Part No, Distributors Name, Distributors Part No, Unit Cost, Price break to use, Notes/Remark
