wyolum/ClockIOT/kicad/ClockIOT_BoM.ods

Sheet: ClockIOT_pcb_BoM
No | Designator | Package | Quantity | Designation | Digi PN | Mfr. | Mfg PN | Decription | Link
1 | BT1 | CR2032_SMD | 1 | Batt_RTC | SKST-2007D | Soin Ltd. | KST-2007D | HOLDER COIN CELL 20MM SMD | SEEED : https://soinltd.1688.com
2 | BATT1 | CR2032 | 1 | Battery Coin 2032 | P189-ND | Panasonic – BSG | CR2032 | BATTERY LITHIUM 3V COIN 20MM | https://www.digikey.com/product-detail/en/panasonic-bsg/CR2032/P189-ND/31939
3 | C31,C22,C26,C24,C29,C30,C9,C6,C1,C2,C3,C4,C5,C7,C8,C10,C11,C12,C13,C14,C15,C16 | c_0805 | 22 | 100nF | 399-1169-1-ND | KEMET | C0805C104M5RACTU | CAP CER 0.1UF 50V X7R 0805 | https://www.digikey.com/product-detail/en/kemet/C0805C104M5RACTU/399-1169-1-ND/411444
4 | C17,C23,C25 | c_2917 | 3 | 10uF/25V | P16804-1-ND | Panasonic Electronic Components | EEF-CS1E100R | CAP ALUM POLY 10UF 20% 25V SMD | https://www.digikey.com/product-detail/en/panasonic-electronic-components/EEF-CS1E100R/P16804-1-ND/4755574
5 | C18 | c_2917 | 1 | 22uF/25V | EEF-HX1E220R-ND | Panasonic Electronic Components | EEF-HX1E220R | CAP ALUM POLY 22UF 20% 25V SMD | https://www.digikey.com/product-detail/en/panasonic-electronic-components/EEF-HX1E220R/EEF-HX1E220R-ND/5684241
6 | C19,C20,C21 | c_0805 | 3 | 1nF | 478-1215-1-ND | AVX Corporation | 06035C102KAT2A | CAP CER 1000PF 50V X7R 0603 | https://www.digikey.com/product-detail/en/avx-corporation/06035C102KAT2A/478-1215-1-ND/564247
7 | C27 | c_2917 | 1 | 100uF/6V3 | PCE4278CT-ND | Panasonic Electronic Components | EEF-CX0J101R | CAP ALUM POLY 100UF 20% 6.3V SMD | https://www.digikey.com/product-detail/en/panasonic-electronic-components/EEF-CX0J101R/PCE4278CT-ND/816448
8 | C28 | c_0805 | 1 | 1uF/25V | 1276-6469-1-ND | Samsung Electro-Mechanics | CL21B105KAFNNNG | CAP CER 1UF 25V X7R 0805 | https://www.digikey.com/product-detail/en/samsung-electro-mechanics/CL21B105KAFNNNG/1276-6469-1-ND/5958097
9 | D1 | SOT-143 | 1 | PRTR5V0U2X | 1727-3884-1-ND | Nexperia USA Inc. | PRTR5V0U2X,215 | Ultra low capacitance double rail-to-rail ESD protection diode | https://www.digikey.com/short/jf405p
10 | D2 | LED-0805 | 1 | LED_PWR | 732-4983-1-ND | Wurth Electronics Inc. | 150080GS75000 | LED GREEN CLEAR 0805 SMD | https://www.digikey.com/product-detail/en/wurth-electronics-inc/150080GS75000/732-4983-1-ND/4489913
11 | J24,J25 | JST_SH_SM04B-SRSS-TB_1x04-1MP_P1.00mm_Horizontal | 2 | qwiic | 455-1804-1-ND | JST Sales America Inc. | SM04B-SRSS-TB(LF)(SN) | Connector Header Surface Mount, Right Angle 4 position 0.039" (1.00mm) | https://www.digikey.com/short/ztwjpd
12 | L1,L2 | r_0805 | 2 | 330E | 445-1569-1-ND | TDK Corporation | MPZ2012S331AT000 | FERRITE BEAD 330 OHM 0805 1LN | https://www.digikey.com/product-detail/en/tdk-corporation/MPZ2012S331AT000/445-1569-1-ND/571899
13 | LDR1,LDR2 | r_0805_ldr | 2 | LDR | PDV-P8103-ND | Luna Optoelectronics | PDV-P8103 | PHOTOCELL 16-33KOHM | https://www.digikey.com/product-detail/en/luna-optoelectronics/PDV-P8103/PDV-P8103-ND/480610
14 | P1 | USB_Micro-B_Molex-105017-0001 | 1 | USB_micro | 320010561 | D G Yuliang | YL-001 | CONN RCPT MICRO USB R/A SMD | SEEED
15 | P2,P4,P5,P6 | PinSocket_1x03_P2.54mm_Horizontal | 4 | OUT_CLK, IN_DAT, IN_CLK, OUT_DAT | S5478-ND | Sullins Connector Solutions | PPPC031LGBN-RC | 3 Position Header Connector Through Hole, Right Angle | https://www.digikey.com/short/ztw428
16 | Q1 | SOT-363_SC-70-6 | 1 | DDC114TU | DDC114TU-FDICT-ND | Diodes Incorporated | DDC114TU-7-F | TRANS 2NPN PREBIAS 0.2W SOT363 | https://www.digikey.com/product-detail/en/diodes-incorporated/DDC114TU-7-F/DDC114TU-FDICT-ND/815483
17 | R1,R2,R16,R18,R22 | r_0805 | 5 | 470R | RMCF0805JT470RCT-ND | Stackpole Electronics Inc. | RMCF0805JT470R | RES SMD 470 OHM 5% 1/8W 0805 | https://www.digikey.com/product-detail/en/stackpole-electronics-inc/RMCF0805JT470R/RMCF0805JT470RCT-ND/1942551
18 | R25,R24,R11,R10,R3,R7,R6,R12,R13,R14 | r_0805 | 10 | 10k | RMCF0805FT10K0CT-ND | Stackpole Electronics Inc. | RMCF0805FT10K0 | RES SMD 10K OHM 1% 1/8W 0805 | https://www.digikey.com/product-detail/en/stackpole-electronics-inc/RMCF0805FT10K0/RMCF0805FT10K0CT-ND/1942435
19 | R4,R5 | r_0805 | 2 | 1k | RMCF0805FT1K00CT-ND | Stackpole Electronics Inc. | RMCF0805FT1K00 | RES SMD 1K OHM 1% 1/8W 0805 | https://www.digikey.com/product-detail/en/stackpole-electronics-inc/RMCF0805FT1K00/RMCF0805FT1K00CT-ND/1942370
20 | R8,R9 | r_0805 | 2 | 4K7 | RMCF0805FT4K70CT-ND | Stackpole Electronics Inc. | RMCF0805FT4K70 | RES SMD 4.7K OHM 1% 1/8W 0805 | https://www.digikey.com/product-detail/en/stackpole-electronics-inc/RMCF0805FT4K70/RMCF0805FT4K70CT-ND/1942412
21 | R21,R23 | r_0805 | 2 | 0R | RMCF0805ZT0R00CT-ND | Stackpole Electronics Inc. | RMCF0805ZT0R00 | RES SMD 0 OHM JUMPER 1/8W 0805 | https://www.digikey.com/product-detail/en/stackpole-electronics-inc/RMCF0805ZT0R00/RMCF0805ZT0R00CT-ND/1942606
22 | S1 | SW_SMD BLACK | 1 | SW-ENTER | 679-2384-1-ND | APEM Inc. | ADTSM63NVTR | Tactile Switch SPST-NO Top Actuated Surface Mount, BLACK | https://www.digikey.com/short/ztwz3d
23 | S2 | SW_SMD BLACK | 1 | SW-INC | 679-2384-1-ND | APEM Inc. | ADTSM63NVTR | Tactile Switch SPST-NO Top Actuated Surface Mount, BLACK | https://www.digikey.com/short/ztwz3d
24 | S3 | SW_SMD RED | 1 | EN | 679-2381-1-ND | APEM Inc. | ADTSM61RVTR | Tactile Switch SPST-NO Top Actuated Surface Mount, RED | https://www.digikey.com/short/ztwz8q
25 | S4 | SW_SMD RED | 1 | BOOT | 679-2381-1-ND | APEM Inc. | ADTSM61RVTR | Tactile Switch SPST-NO Top Actuated Surface Mount, RED | https://www.digikey.com/short/ztwz8q
26 | S5 | SW_SMD BLACK | 1 | SW-DEC | 679-2384-1-ND | APEM Inc. | ADTSM63NVTR | Tactile Switch SPST-NO Top Actuated Surface Mount, BLACK | https://www.digikey.com/short/ztwz3d
27 | S6 | SW_SMD BLACK | 1 | SW-MODE | 679-2384-1-ND | APEM Inc. | ADTSM63NVTR | Tactile Switch SPST-NO Top Actuated Surface Mount, BLACK | https://www.digikey.com/short/ztwz3d
28 | U1,U2,U3,U4,U5,U6,U7,U8,U9,U10,U11,U12,U13,U14,U15,U16, U17,U18,U19,U20,U21,U22,U23,U24,U25,U26,U27,U28,U29,U30,U31,U32, U33,U34,U35,U36,U37,U38,U39,U40,U41,U42,U43,U44,U45,U46,U47,U48, U49,U50,U51,U52,U53,U54,U55,U56,U57,U58,U59,U60,U61,U62,U63,U64, U65,U66,U67,U68,U69,U70,U71,U72,U73,U74,U75,U76,U77,U78,U79,U80, U81,U82,U83,U84,U85,U86,U87,U88,U89,U90,U91,U92,U93,U94,U95,U96, U97,U98,U99,U100,U101,U102,U103,U104,U105,U106,U107,U108,U109,U110,U111,U112, U113,U114,U115,U116,U117,U118,U119,U120,U121,U122,U123,U124,U125,U126,U127,U128 | 5050 | 128 | APA102 | Aliexpress | Shiji Lighting | APA102C | 5050 SMD RGB LED with built-in controller | SEEED
29 | U129 | esp_wroom_32 | 1 | ESP-wroom-32 | 1904-1010-1-ND | Espressif Systems | ESP-WROOM-32 | SMD MODULE, ESP32-D0WDQ6, 32MBIT | https://www.digikey.com/product-detail/en/espressif-systems/ESP-WROOM-32/1904-1010-1-ND/8544305
30 | U130 | DS3231 | 1 | DS3231N | DS3231M+-ND | Maxim Integrated | DS3231M+ | IC RTC CLK/CALENDAR I2C 16-SOIC | https://www.digikey.com/product-detail/en/maxim-integrated/DS3231M/DS3231M-ND/2402420
31 | U131 | SOT-223-3_TabPin2 | 1 | AP1117-33 | 296-21112-1-ND | Texas Instruments | TLV1117-33CDCYR | IC REG LIN 3.3V 800MA SOT223-4 | https://www.digikey.com/product-detail/en/texas-instruments/TLV1117-33CDCYR/296-21112-1-ND/1217055
32 | U132 | QFN-28-1EP_5x5mm_Pitch0.5mm | 1 | CP2102N-A01-GQFN28 | 336-3694-ND | Silicon Labs | CP2102N-A01-GQFN28 | IC BRIDGE USB TO UART 28QFN | https://www.digikey.com/product-detail/en/silicon-labs/CP2102N-A01-GQFN28/336-3694-ND/6012519
 | DNP
33 | R19,R20 | r_0805 | 2 | 0R NC
34 | J20 | Header_3x2 | 1 | Header_ISP
35 | JP1 | R_0402 | 1 | LED_PWR_EN

Sheet: BoM_PCB
Id | Designator | Package | Quantity | Designation | Supplier and ref
1 | BT1 | CR2032_SMD_SKST-2007D | 1 | Batt_RTC
2 | C1,C2,C3,C4,C5,C6,C7,C8,C9,C10,C11,C12,C13,C14,C15,C16,C22,C24,C26,C29,C30,C31 | c_0805 | 22 | 100nF
3 | C17,C23,C25 | c_2917 | 3 | 10uF/25V
4 | C18 | c_2917 | 1 | 22uF/25V
5 | C19,C20,C21 | c_0805 | 3 | 1nF
6 | C27 | c_2917 | 1 | 100uF/6V3
7 | C28 | c_0805 | 1 | 1uF/10V
8 | D1 | SOT-143 | 1 | RClamp0854P.TCT
9 | D2 | LED-0805 | 1 | LED_PWR
10 | J24,J25 | JST_SH_SM04B-SRSS-TB_1x04-1MP_P1.00mm_Horizontal | 2 | qwiic
11 | L1,L2 | r_0805 | 2 | 330E
12 | LDR1,LDR2 | r_0805_ldr_2 | 2 | LDR
13 | P1 | USB_Micro-B_seeed-320010561 | 1 | USB_micro
14 | P2,P4,P5,P6 | PinSocket_1x03_P2.54mm_Horizontal | 4 | OUT_CLK, IN_DAT, IN_CLK, OUT_DAT
15 | Q1 | SOT-363_SC-70-6 | 1 | DDC114TU
16 | R1,R2,R16,R18,R22 | r_0805 | 5 | 470R
17 | R3,R6,R7,R10,R11,R12,R13,R14,R24,R25 | r_0805 | 10 | 10k
18 | R4,R5 | r_0805 | 2 | 1k
19 | R8,R9 | r_0805 | 2 | 4K7
20 | R19,R20 | r_0805 | 2 | 0R NC
21 | R21,R23 | r_0805 | 2 | 0R
22 | S1 | SW_SMD_311020004 | 1 | SW-ENTER
23 | S2 | SW_SMD_311020004 | 1 | SW-INC
24 | S3 | SW_SMD_311020004 | 1 | SW-EN
25 | S4 | SW_SMD_311020004 | 1 | SW-BOOT
26 | S5 | SW_SMD_311020004 | 1 | SW-DEC
27 | S6 | SW_SMD_311020004 | 1 | SW-MODE
28 | U1,U2,U3,U4,U5,U6,U7,U8,U9,U10,U11,U12,U13,U14,U15,U16,U17,U18,U19,U20,U21,U22,U23,U24,U25,U26,U27,U28,U29,U30,U31,U32,U33,U34,U35,U36,U37,U38,U39,U40,U41,U42,U43,U44,U45,U46,U47,U48,U49,U50,U51,U52,U53,U54,U55,U56,U57,U58,U59,U60,U61,U62,U63,U64,U65,U66,U67,U68,U69,U70,U71,U72,U73,U74,U75,U76,U77,U78,U79,U80,U81,U82,U83,U84,U85,U86,U87,U88,U89,U90,U91,U92,U93,U94,U95,U96,U97,U98,U99,U100,U101,U102,U103,U104,U105,U106,U107,U108,U109,U110,U111,U112,U113,U114,U115,U116,U117,U118,U119,U120,U121,U122,U123,U124,U125,U126,U127,U128, | APA102 | 128 | APA102
29 | U129 | esp_wroom_32 | 1 | ESP-wroom-32
30 | U130 | DS3231 | 1 | DS3231N
31 | U131 | SOT-223-3_TabPin2 | 1 | 1117-33
32 | U132 | QFN-28-1EP_5x5mm_Pitch0.5mm | 1 | CP2102N-A01-GQFN28
33 | BITE1,BITE2,BITE3,BITE4,BITE5,BITE6,BITE7 | mouse-bite-2.54mm-slot_OSH | 8 | Mouse_Bite
34 | G1,G7 | Logo-WL3 | 2 | LOGO_WL
35 | G2,G8 | KiCad-Logo2_6mm_SilkScreen | 2 | KiCad
36 | G3,G9 | OSHW_6mm | 2 | OSHW
37 | HB44,HB43,HB42,HB41,HB40,HB39,HB38,HB37,HB36,HB35,HB34,HB33,HB32,HB31,HB30,HB29,HB28,HB27,HB26,HB25,HB24,HB23,HB22,HB21,HB20,HB19,HB18,HB17,HB16,HB15,HB14,HB13,HB12,HB11,HB10,HB9,HB8,HB7,HB6,HB5,HB4,HB3,HB2,HB1 | hole_baffle_2mm | 44 | hole_baffle
38 | HB45,HB46 | MountingHole_3.2mm_M3 | 2 | mtg_hole_3mm_small
39 | HB47,HB48,HB49,HB50 | MountingHole_3.2mm_M3_Pad_Via | 4 | mtg_hole_3mm
40 | HB54,HB53,HB52,HB51 | 1pin | 4 | mtg_hole_3mm
41 | J1,J9 | 1pin | 2 | CLK_IN
42 | J2,J10 | 1pin | 2 | DAT_IN
43 | J7,J15 | 1pin | 2 | 5V
44 | J8,J16 | 1pin | 2 | GND
45 | J17 | BreakOutPad | 1 | MISO
46 | J18 | BreakOutPad | 1 | 3V3
47 | J19 | BreakOutPad | 1 | SCK
48 | J20 | Header_ISP | 1 | SPI
49 | J21 | BreakOutPad | 1 | MOSI
50 | J22 | BreakOutPad | 1 | RST
51 | J23 | BreakOutPad | 1 | GND
52 | JP1 | R_0402 | 1 | LED_PWR_EN
53 | P2 | Pin_Header_Straight_1x02 | 1 | OUT_CLK_DAT
54 | P3 | USB-C_bout | 1 | USB-C_breakout
55 | TP1 | BreakOutPad | 1 | ~RST
56 | TP2 | BreakOutPad | 1 | SQR
57 | TP3 | BreakOutPad | 1 | 32kHz

Sheet: BoM_SCH
Sr No | Quantity | Reference | Value | Footprint
1 | 1 | BT1, | Batt_RTC | ClockIOT_libs:CR2032_SMD_SKST-2007D
2 | 22 | C1,C2,C3,C4,C5,C6,C7,C8,C9,C10,C11,C12,C13,C14,C15,C16,C22,C24,C26,C29,C30,C31, | 100nF | ClockIOT_libs:c_0805
3 | 3 | C17,C23,C25, | 10uF/25V | ClockIOT_libs:c_2917
4 | 1 | C18, | 22uF/25V | ClockIOT_libs:c_2917
5 | 3 | C19,C20,C21, | 1nF | ClockIOT_libs:c_0805
6 | 1 | C27, | 100uF/6V3 | ClockIOT_libs:c_2917
7 | 1 | C28, | 1uF/10V | ClockIOT_libs:c_0805
8 | 1 | D1, | RClamp0854P.TCT | ClockIOT_libs:SOT-143
9 | 1 | D2, | LED_PWR | ClockIOT_libs:LED-0805
10 | 2 | J24,J25 | qwiic | JST_SH_SM04B-SRSS-TB_1x04-1MP_P1.00mm_Horizontal
11 | 2 | L1,L2, | 330E | ClockIOT_libs:r_0805
12 | 2 | LDR1,LDR2, | LDR | ClockIOT_libs:r_0805_ldr_2
13 | 1 | P1, | USB_micro | ClockIOT_libs:USB_Micro-B_seeed-320010561
14 | 4 | P2,P4,P5,P6 | OUT_CLK, IN_DAT, IN_CLK, OUT_DAT | PinSocket_1x03_P2.54mm_Horizontal
15 | 1 | Q1, | DDC114TU | ClockIOT_libs:SOT-363_SC-70-6
16 | 5 | R1,R2,R16,R18,R22, | 470R | ClockIOT_libs:r_0805
17 | 10 | R3,R6,R7,R10,R11,R12,R13,R14,R24,R25, | 10k | ClockIOT_libs:r_0805
18 | 2 | R4,R5 | 1k | ClockIOT_libs:r_0805
19 | 2 | R8,R9, | 4K7 | ClockIOT_libs:r_0805
20 | 2 | R19,R20, | 0R NC | ClockIOT_libs:r_0805
21 | 2 | R21,R23, | 0R | ClockIOT_libs:r_0805
22 | 1 | S1, | SW-ENTER | ClockIOT_libs:SW_SMD_311020004
23 | 1 | S2, | SW-INC | ClockIOT_libs:SW_SMD_311020004
24 | 1 | S3, | SW-EN | ClockIOT_libs:SW_SMD_311020004
25 | 1 | S4, | SW-BOOT | ClockIOT_libs:SW_SMD_311020004
26 | 1 | S5, | SW-DEC | ClockIOT_libs:SW_SMD_311020004
27 | 1 | S6, | SW-MODE | ClockIOT_libs:SW_SMD_311020004
28 | 128 | U1,U2,U3,U4,U5,U6,U7,U8,U9,U10,U11,U12,U13,U14,U15,U16,U17,U18,U19,U20,U21,U22,U23,U24,U25,U26,U27,U28,U29,U30,U31,U32,U33,U34,U35,U36,U37,U38,U39,U40,U41,U42,U43,U44,U45,U46,U47,U48,U49,U50,U51,U52,U53,U54,U55,U56,U57,U58,U59,U60,U61,U62,U63,U64,U65,U66,U67,U68,U69,U70,U71,U72,U73,U74,U75,U76,U77,U78,U79,U80,U81,U82,U83,U84,U85,U86,U87,U88,U89,U90,U91,U92,U93,U94,U95,U96,U97,U98,U99,U100,U101,U102,U103,U104,U105,U106,U107,U108,U109,U110,U111,U112,U113,U114,U115,U116,U117,U118,U119,U120,U121,U122,U123,U124,U125,U126,U127,U128, | APA102 | ClockIOT_libs:APA102
29 | 1 | U129, | ESP-wroom-32 | ClockIOT_libs:esp_wroom_32
30 | 1 | U130, | DS3231N | ClockIOT_libs:DS3231
31 | 1 | U131, | 1117-33 | ClockIOT_libs:SOT-223-3_TabPin2
32 | 1 | U132, | CP2102N-A01-GQFN28 | ClockIOT_libs:QFN-28-1EP_5x5mm_Pitch0.5mm
DNP
33 | 7 | BITE1,BITE2,BITE3,BITE4,BITE5,BITE6,BITE7 | Mouse_Bite | ClockIOT_libs:mouse-bite-2.54mm-slot_OSH
34 | 2 | G1,G7, | LOGO_WL | ClockIOT_libs:Logo-WL3
35 | 2 | G2,G8, | KiCad | ClockIOT_libs:KiCad-Logo2_6mm_SilkScreen
36 | 2 | G3,G9, | OSHW | ClockIOT_libs:OSHW_6mm
37 | 44 | HB1,HB2,HB3,HB4,HB5,HB6,HB7,HB8,HB9,HB10,HB11,HB12,HB13,HB14,HB15,HB16,HB17,HB18,HB19,HB20,HB21,HB22,HB23,HB24,HB25,HB26,HB27,HB28,HB29,HB30,HB31,HB32,HB33,HB34,HB35,HB36,HB37,HB38,HB39,HB40,HB41,HB42,HB43,HB44, | hole_baffle | ClockIOT_libs:hole_baffle_2mm
38 | 2 | HB45,HB46, | mtg_hole_3mm_small | ClockIOT_libs:MountingHole_3.2mm_M3
39 | 4 | HB47,HB48,HB49,HB50 | mtg_hole_3mm | ClockIOT_libs:MountingHole_3.2mm_M3_Pad_Via
40 | 4 | HB54,HB53,HB52,HB51 | mtg_hole_3mm | ClockIOT_libs:1pin
41 | 2 | J1,J9, | CLK_IN | ClockIOT_libs:1pin
42 | 2 | J2,J10, | DAT_IN | ClockIOT_libs:1pin
43 | 2 | J7,J15, | 5V | ClockIOT_libs:1pin
44 | 3 | J8,J16,J23, | GND | ClockIOT_libs:BreakOutPad
45 | 1 | J17, | MISO | ClockIOT_libs:BreakOutPad
46 | 1 | J18, | 3V3 | ClockIOT_libs:BreakOutPad
47 | 1 | J19, | SCK | ClockIOT_libs:BreakOutPad
48 | 1 | J20, | SPI | ClockIOT_libs:Header_ISP
49 | 1 | J21, | MOSI | ClockIOT_libs:BreakOutPad
50 | 1 | J22, | RST | ClockIOT_libs:BreakOutPad
51 | 1 | J23, | GND | ClockIOT_libs:BreakOutPad
52 | 1 | JP1, | LED_PWR_EN | ClockIOT_libs:R_0402
53 | 1 | TP1, | ~RST | ClockIOT_libs:BreakOutPad
54 | 1 | TP2, | SQR | ClockIOT_libs:BreakOutPad
55 | 1 | TP3, | 32kHz | ClockIOT_libs:BreakOutPad
