wyolum/ClockIOT/kicad/ClockIOT_BoM_seeed.xls

Electronic Engineering BOM List
Product Name： ClockIOT
Version：rev 5
Issue Date：27/Jan/2020
Item No. (序号) | Reference Des (上件位置) | Qty (用量) | Catalog (分类） | Part_Description (规格描述) | Part_Value （元件值） | Part_Package （元件封装） | Manufacturers Name (使用厂牌名称) | Manufacturers Part No. (使用厂牌型号) | Distributors Name （供应商名称） | Distributors Part No. (供貨商型号) | Unit Price （单价） | Price Break To Use （价格分段的购买量） | Notes/Remark （备注）
Example（填写范例）
1 | BT1 | 1 | OTHER | HOLDER COIN CELL 20MM SMD | Batt_RTC | CR2032_SMD | Soin Ltd. | KST-2007D | Seeed | SKST-2007D |  |  | SEEED : https://soinltd.1688.com
2 | BATT1 | 1 | OTHER | BATTERY LITHIUM 3V COIN 20MM | Battery Coin 2032 | CR2032 | Panasonic – BSG | CR2032 | Digikey | P189-ND |  |  | https://www.digikey.com/product-detail/en/panasonic-bsg/CR2032/P189-ND/31939
3 | C1,C2,C3,C4,C5,C6,C7,C8,C9,C10,C11,C12,C13,C14,C15,C16,C22,C24,C26,C29,C30,C31 | 22 | Capacitor | CAP CER 0.1UF 50V X7R 0805 | 100nF | c_0805 | KEMET | C0805C104M5RACTU | Digikey | 399-1169-1-ND |  |  | https://www.digikey.com/product-detail/en/kemet/C0805C104M5RACTU/399-1169-1-ND/411444
4 | C17,C23,C25 | 3 | Capacitor | CAP ALUM POLY 10UF 20% 25V SMD | 10uF/25V | c_2917 | Panasonic Electronic Components | EEF-CS1E100R | Digikey | P16804-1-ND |  |  | https://www.digikey.com/product-detail/en/panasonic-electronic-components/EEF-CS1E100R/P16804-1-ND/4755574
5 | C18 | 1 | Capacitor | CAP ALUM POLY 22UF 20% 25V SMD | 22uF/25V | c_2917 | Panasonic Electronic Components | EEF-HX1E220R | Digikey | EEF-HX1E220R-ND |  |  | https://www.digikey.com/product-detail/en/panasonic-electronic-components/EEF-HX1E220R/EEF-HX1E220R-ND/5684241
6 | C19,C20,C21 | 3 | Capacitor | CAP CER 1000PF 50V X7R 0603 | 1nF | c_0805 | AVX Corporation | 06035C102KAT2A | Digikey | 478-1215-1-ND |  |  | https://www.digikey.com/product-detail/en/avx-corporation/06035C102KAT2A/478-1215-1-ND/564247
7 | C27 | 1 | Capacitor | CAP ALUM POLY 100UF 20% 6.3V SMD | 100uF/6V3 | c_2917 | Panasonic Electronic Components | EEF-CX0J101R | Digikey | PCE4278CT-ND |  |  | https://www.digikey.com/product-detail/en/panasonic-electronic-components/EEF-CX0J101R/PCE4278CT-ND/816448
8 | C28 | 1 | Capacitor | CAP CER 1UF 25V X7R 0805 | 1uF/25V | c_0805 | Samsung Electro-Mechanics | CL21B105KAFNNNG | Digikey | 1276-6469-1-ND |  |  | https://www.digikey.com/product-detail/en/samsung-electro-mechanics/CL21B105KAFNNNG/1276-6469-1-ND/5958097
9 | D1 | 1 | Diode | Ultra low capacitance double rail-to-rail ESD protection diode | PRTR5V0U2X | SOT-143 | Nexperia USA Inc. | PRTR5V0U2X,215 | Digikey | 1727-3884-1-ND |  |  | https://www.digikey.com/short/jf405p
10 | D2 | 1 | Diode | LED GREEN CLEAR 0805 SMD | LED_PWR | LED-0805 | Wurth Electronics Inc. | 150080GS75000 | Digikey | 732-4983-1-ND |  |  | https://www.digikey.com/product-detail/en/wurth-electronics-inc/150080GS75000/732-4983-1-ND/4489913
11 | J24,J25 | 2 | Connector | Connector Header Surface Mount, Right Angle 4 position 0.039" (1.00mm) | qwiic | SH_SM04B-SRSS, 1x04, P1.00mm | JST Sales America Inc. | SM04B-SRSS-TB(LF)(SN) | Digikey | 455-1804-1-ND |  |  | https://www.digikey.com/short/ztwjpd
12 | L1,L2 | 2 | PROTECTOR CATEGORY | FERRITE BEAD 330 OHM 0805 1LN | 330E | r_0805 | TDK Corporation | MPZ2012S331AT000 | Digikey | 445-1569-1-ND |  |  | https://www.digikey.com/product-detail/en/tdk-corporation/MPZ2012S331AT000/445-1569-1-ND/571899
13 | P1 | 1 | Connector | CONN RCPT MICRO USB R/A SMD | USB_micro | USB_Micro-B_seeed-320010561 | D G Yuliang | YL-001 | Seeed | 320010561 |  |  | SEEED
14 | P2,P4,P5,P6 | 4 | Connector | 3 Position Header Connector Through Hole, Right Angle | OUT_CLK, IN_DAT, IN_CLK, OUT_DAT | PinSocket_1x03_P2.54mm_Horizontal | Sullins Connector Solutions | PPPC031LGBN-RC | Digikey | S5478-ND |  |  | https://www.digikey.com/short/ztw428
15 | Q1 | 1 | Transistor | TRANS 2NPN PREBIAS 0.2W SOT363 | DDC114TU | SOT-363_SC-70-6 | Diodes Incorporated | DDC114TU-7-F | Digikey | DDC114TU-FDICT-ND |  |  | https://www.digikey.com/product-detail/en/diodes-incorporated/DDC114TU-7-F/DDC114TU-FDICT-ND/815483
16 | R1,R2,R16,R18,R22 | 5 | Resister | RES SMD 470 OHM 5% 1/8W 0805 | 470R | r_0805 | Stackpole Electronics Inc. | RMCF0805JT470R | Digikey | RMCF0805JT470RCT-ND |  |  | https://www.digikey.com/product-detail/en/stackpole-electronics-inc/RMCF0805JT470R/RMCF0805JT470RCT-ND/1942551
17 | R3,R6,R7,R10,R11,R12,R13,R14,R24,R25 | 10 | Resister | RES SMD 10K OHM 1% 1/8W 0805 | 10k | r_0805 | Stackpole Electronics Inc. | RMCF0805FT10K0 | Digikey | RMCF0805FT10K0CT-ND |  |  | https://www.digikey.com/product-detail/en/stackpole-electronics-inc/RMCF0805FT10K0/RMCF0805FT10K0CT-ND/1942435
18 | R4,R5 | 2 | Resister | RES SMD 1K OHM 1% 1/8W 0805 | 1k | r_0805 | Stackpole Electronics Inc. | RMCF0805FT1K00 | Digikey | RMCF0805FT1K00CT-ND |  |  | https://www.digikey.com/product-detail/en/stackpole-electronics-inc/RMCF0805FT1K00/RMCF0805FT1K00CT-ND/1942370
19 | R8,R9 | 2 | Resister | RES SMD 4.7K OHM 1% 1/8W 0805 | 4K7 | r_0805 | Stackpole Electronics Inc. | RMCF0805FT4K70 | Digikey | RMCF0805FT4K70CT-ND |  |  | https://www.digikey.com/product-detail/en/stackpole-electronics-inc/RMCF0805FT4K70/RMCF0805FT4K70CT-ND/1942412
20 | R21,R23 | 2 | Resister | RES SMD 0 OHM JUMPER 1/8W 0805 | 0R | r_0805 | Stackpole Electronics Inc. | RMCF0805ZT0R00 | Digikey | RMCF0805ZT0R00CT-ND |  |  | https://www.digikey.com/product-detail/en/stackpole-electronics-inc/RMCF0805ZT0R00/RMCF0805ZT0R00CT-ND/1942606
21 | S1 | 1 | OTHER | Tactile Switch SPST-NO Top Actuated Surface Mount, BLACK | SW-ENTER | SW_SMD BLACK | APEM Inc. | ADTSM63NVTR BLACK | Digikey | 679-2384-1-ND |  |  | https://www.digikey.com/short/ztwz3d
22 | S2 | 1 | OTHER | Tactile Switch SPST-NO Top Actuated Surface Mount, BLACK | SW-INC | SW_SMD BLACK | APEM Inc. | ADTSM63NVTR BLACK | Digikey | 679-2384-1-ND |  |  | https://www.digikey.com/short/ztwz3d
23 | S3 | 1 | OTHER | Tactile Switch SPST-NO Top Actuated Surface Mount, RED | EN | SW_SMD RED | APEM Inc. | ADTSM61RVTR RED | Digikey | 679-2381-1-ND |  |  | https://www.digikey.com/short/ztwz8q
24 | S4 | 1 | OTHER | Tactile Switch SPST-NO Top Actuated Surface Mount, RED | BOOT | SW_SMD RED | APEM Inc. | ADTSM61RVTR RED | Digikey | 679-2381-1-ND |  |  | https://www.digikey.com/short/ztwz8q
25 | S5 | 1 | OTHER | Tactile Switch SPST-NO Top Actuated Surface Mount, BLACK | SW-DEC | SW_SMD BLACK | APEM Inc. | ADTSM63NVTR BLACK | Digikey | 679-2384-1-ND |  |  | https://www.digikey.com/short/ztwz3d
26 | S6 | 1 | OTHER | Tactile Switch SPST-NO Top Actuated Surface Mount, BLACK | SW-MODE | SW_SMD BLACK | APEM Inc. | ADTSM63NVTR BLACK | Digikey | 679-2384-1-ND |  |  | https://www.digikey.com/short/ztwz3d
27 | U129 | 1 | IC | SMD MODULE, ESP32-D0WDQ6, 32MBIT | ESP-wroom-32 | esp_wroom_32 | Espressif Systems | ESP-WROOM-32 | Digikey | 1904-1010-1-ND |  |  | https://www.digikey.com/product-detail/en/espressif-systems/ESP-WROOM-32/1904-1010-1-ND/8544305
28 | U130 | 1 | IC | IC RTC CLK/CALENDAR I2C 16-SOIC | DS3231N | DS3231 | Maxim Integrated | DS3231M+ | Digikey | DS3231M+-ND |  |  | https://www.digikey.com/product-detail/en/maxim-integrated/DS3231M/DS3231M-ND/2402420
29 | U131 | 1 | IC | IC REG LIN 3.3V 800MA SOT223-4 | AP1117-33 | SOT-223-3_TabPin2 | Texas Instruments | TLV1117-33CDCYR | Digikey | 296-21112-1-ND |  |  | https://www.digikey.com/product-detail/en/texas-instruments/TLV1117-33CDCYR/296-21112-1-ND/1217055
30 | U132 | 1 | IC | IC BRIDGE USB TO UART 28QFN | CP2102N-A01-GQFN28 | QFN-28-1EP_5x5mm_Pitch0.5mm | Silicon Labs | CP2102N-A01-GQFN28 | Digikey | 336-3694-ND |  |  | https://www.digikey.com/product-detail/en/silicon-labs/CP2102N-A01-GQFN28/336-3694-ND/6012519
31 | U1,U2,U3,U4,U5,U6,U7,U8,U9,U10,U11,U12,U13,U14,U15,U16, U17,U18,U19,U20,U21,U22,U23,U24,U25,U26,U27,U28,U29,U30,U31,U32, U33,U34,U35,U36,U37,U38,U39,U40,U41,U42,U43,U44,U45,U46,U47,U48, U49,U50,U51,U52,U53,U54,U55,U56,U57,U58,U59,U60,U61,U62,U63,U64, U65,U66,U67,U68,U69,U70,U71,U72,U73,U74,U75,U76,U77,U78,U79,U80, U81,U82,U83,U84,U85,U86,U87,U88,U89,U90,U91,U92,U93,U94,U95,U96, U97,U98,U99,U100,U101,U102,U103,U104,U105,U106,U107,U108,U109,U110,U111,U112, U113,U114,U115,U116,U117,U118,U119,U120,U121,U122,U123,U124,U125,U126,U127,U128 | 128 | IC | 5050 SMD RGB LED with built-in controller | APA102 | 5050 | Shiji Lighting | APA102C |  | Aliexpress
PARTS KIT (DO NOT POPULATE)
32 | LDR1,LDR2 | 2 | Resister | PHOTOCELL 16-33KOHM | LDR | r_0805_ldr | Luna Optoelectronics | PDV-P8103 | Digikey | PDV-P8103-ND |  |  | https://www.digikey.com/product-detail/en/luna-optoelectronics/PDV-P8103/PDV-P8103-ND/480610
1. Recommended Distributor: Digi-Key, Mouser, Avnet Express, Farnell.
2. Catalog: Capacitor,Resister,Diode,Connector,Transistor,IC,PROTECTOR CATEGORY,OTHER
3. Required Fields: Item No, Reference Des, Qty, Catalog, Part_Value, Part Package
Optional Fields: Part_Description, Manufacturers Name, Manufacturers Part No, Distributors Name, Distributors Part No, Unit Cost, Price break to use, Notes/Remark
