wyolum/ClockIOT/arduino/WyoBean32/calendar_baffles_8x24.stl

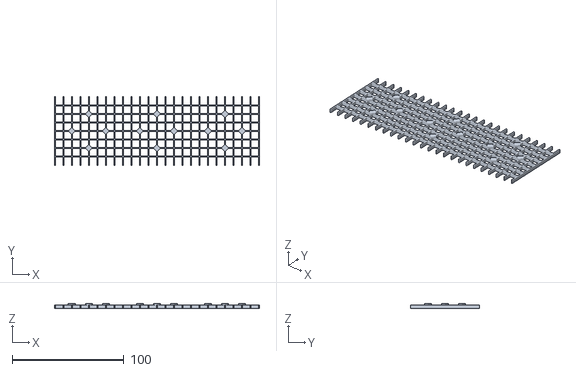
[picture p59: CAD file, 2019-08-28]
arduino/WyoBean32/calendar_baffles_8x24.stl
183.7 x 61.8 x 4.40
