wyolum/ClockIOT/ClockIOT_data/USB-C_breakout/USB-C_pololu/3d_modules/USB-C-1054500101.step

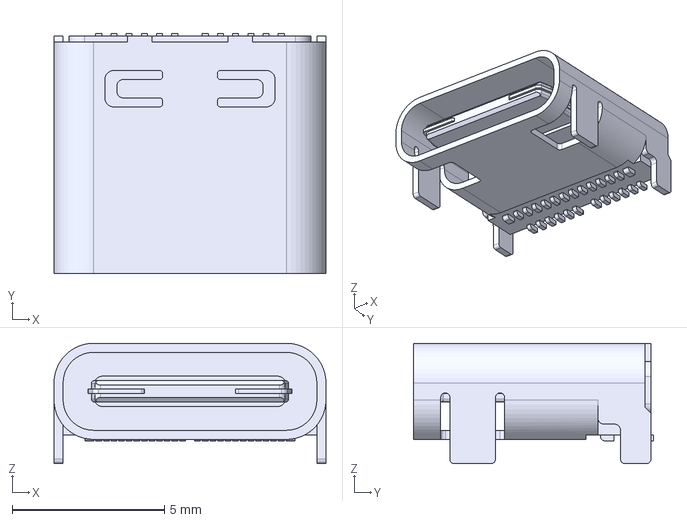
[picture p60: CAD file, 2018-10-19]
ClockIOT_data/USB-C_breakout/USB-C_pololu/3d_modules/USB-C-1054500101.step
8.94 x 7.90 x 3.96 mm
