wyolum/ClockIOT/ClockIOT_data/USB-C_breakout/USB-C_pololu/USB-C_pololu.step

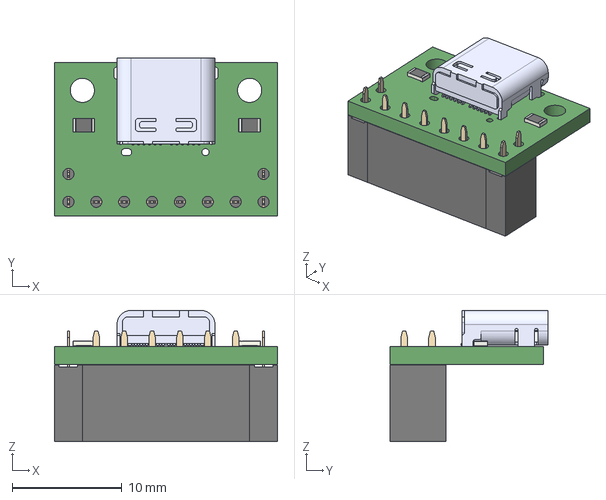
[picture p61: CAD file, 2018-10-19]
ClockIOT_data/USB-C_breakout/USB-C_pololu/USB-C_pololu.step
20.3 x 14.4 x 12.0 mm
