wyolum/ClockIOT/fabricate/Chomogram/Chromogramv1_stand.stl

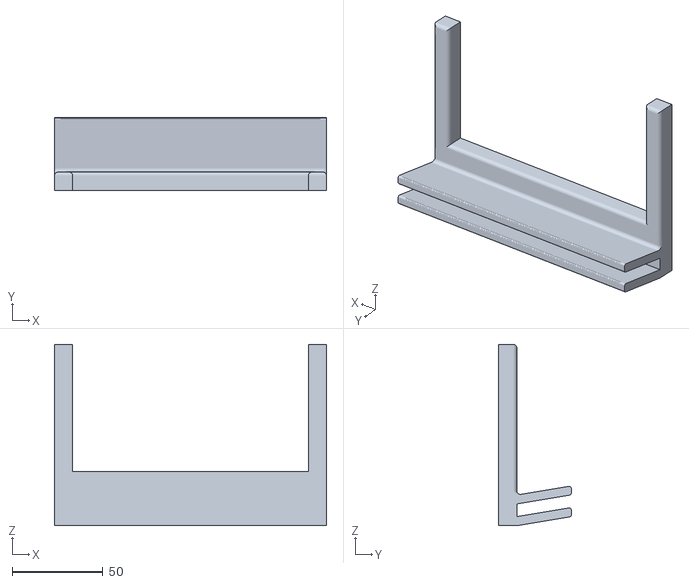
[picture p62: CAD file, 2020-01-02]
fabricate/Chomogram/Chromogramv1_stand.stl
150.0 x 40.0 x 100.0
