wyolum/ClockIOT/fabricate/ClockIOT.stl

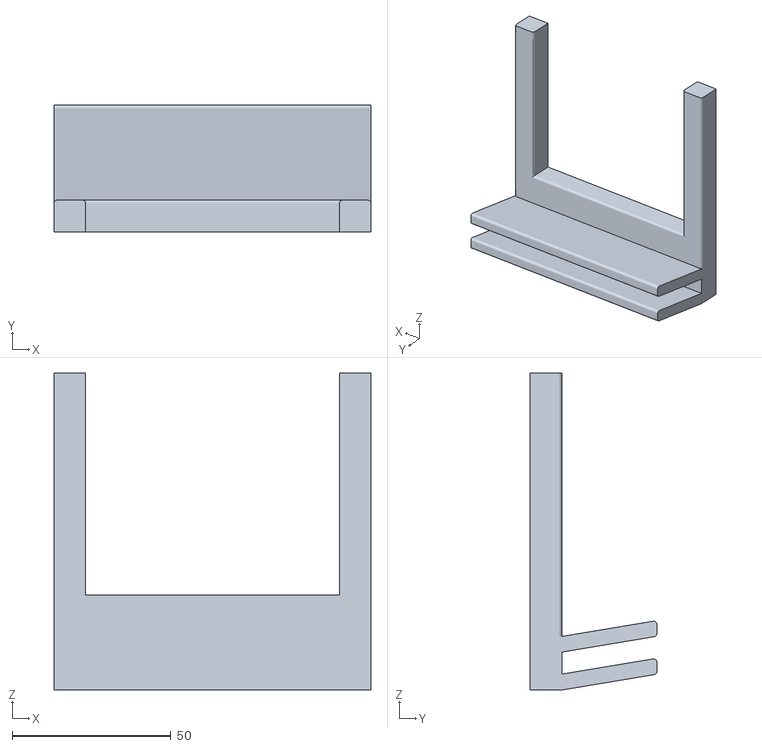
[picture p63: CAD file, 2019-12-16]
fabricate/ClockIOT.stl
100.0 x 40.0 x 100.0
