wyolum/ClockIOT/kicad/3d_modules/JST_GH_SM04B_SRSS_TB_LF_SN.step

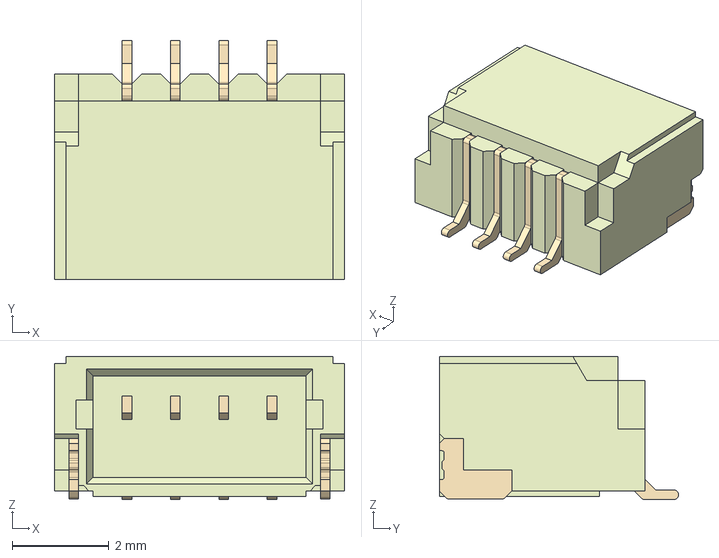
[picture p64: CAD file, 2020-02-01]
kicad/3d_modules/JST_GH_SM04B_SRSS_TB_LF_SN.step
6.00 x 4.95 x 2.96 mm
