wyolum/ClockIOT/kicad/3d_modules/PTS645SL43SMTR92-LFS/PTS645SL43SMTR92-LFS.step

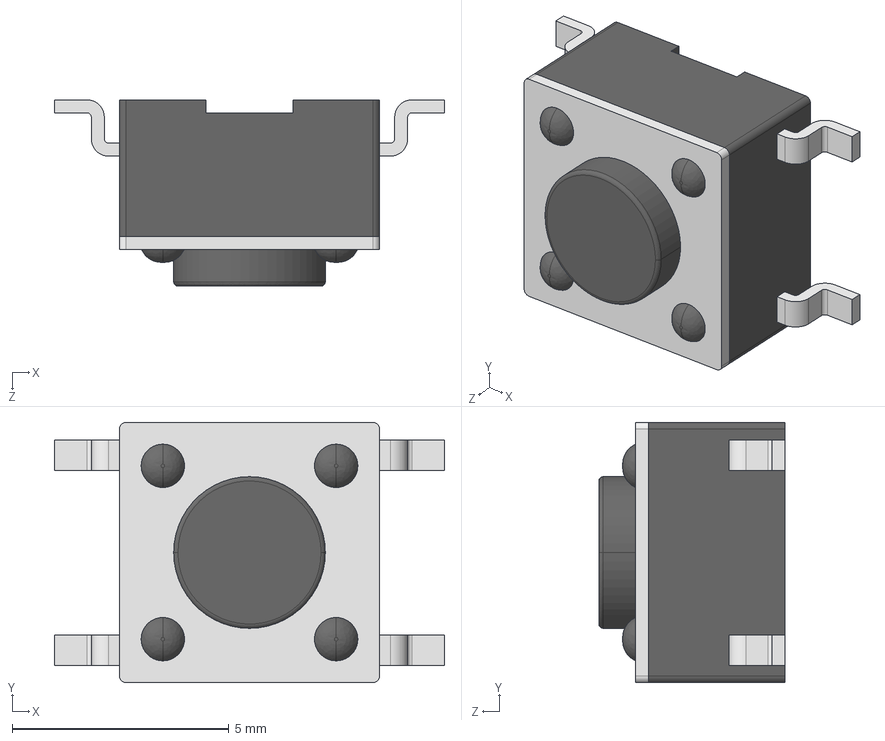
[picture p65: CAD file, 2020-02-01]
kicad/3d_modules/PTS645SL43SMTR92-LFS/PTS645SL43SMTR92-LFS.step
9.00 x 6.00 x 4.30 mm
