wyolum/ClockIOT/kicad/ClockIOT_data/USB-C_breakout/USB-C_pololu/3d_modules/PinSocket_1x06_P254mm_Vertical.step

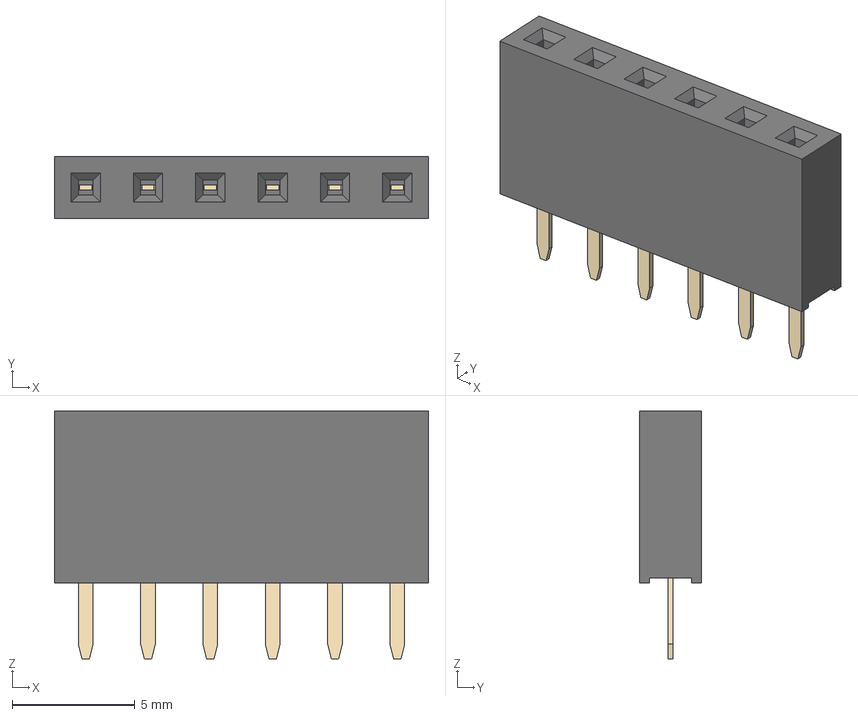
[picture p67: CAD file, 2018-10-19]
kicad/ClockIOT_data/USB-C_breakout/USB-C_pololu/3d_modules/PinSocket_1x06_P254mm_Vertical.step
15.2 x 2.54 x 10.1 mm
