wyolum/ClockIOT/ClockIOT_data/USB-C_breakout/USB-C_pololu/3d_modules/usb-2_0-type-c-connector-breakout-board.step

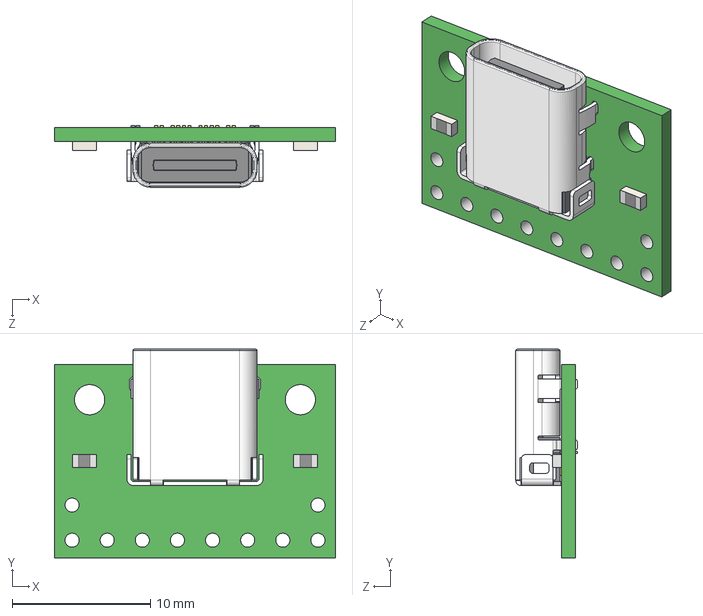
[picture p68: CAD file, 2018-10-19]
ClockIOT_data/USB-C_breakout/USB-C_pololu/3d_modules/usb-2_0-type-c-connector-breakout-board.step
20.3 x 15.1 x 4.45 mm
