wyolum/ClockIOT/fabricate/C3Jr Stand - V4.stl

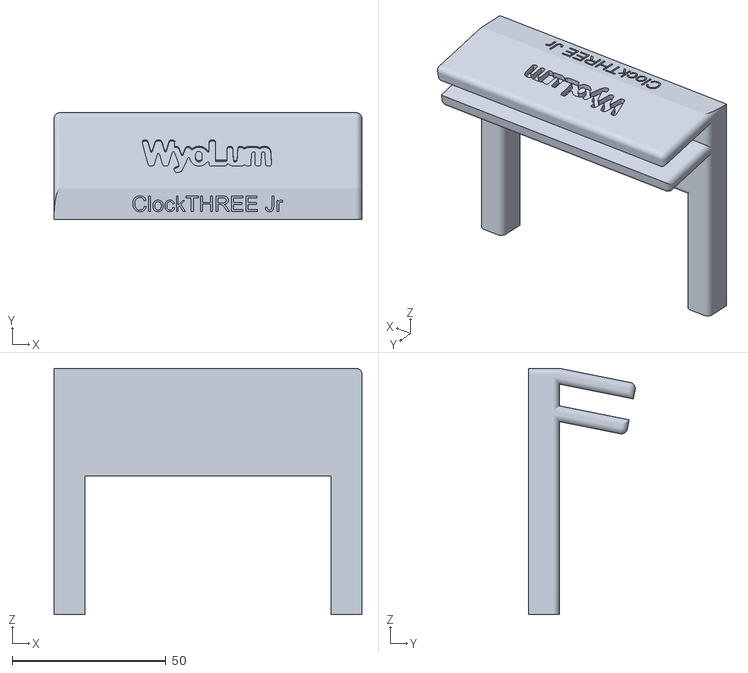
[picture p69: CAD file, 2019-11-30]
fabricate/C3Jr Stand - V4.stl
100.0 x 34.6 x 80.0
