wyolum/ClockIOT/arduino/WyoBean32/calendar_baffles.stl

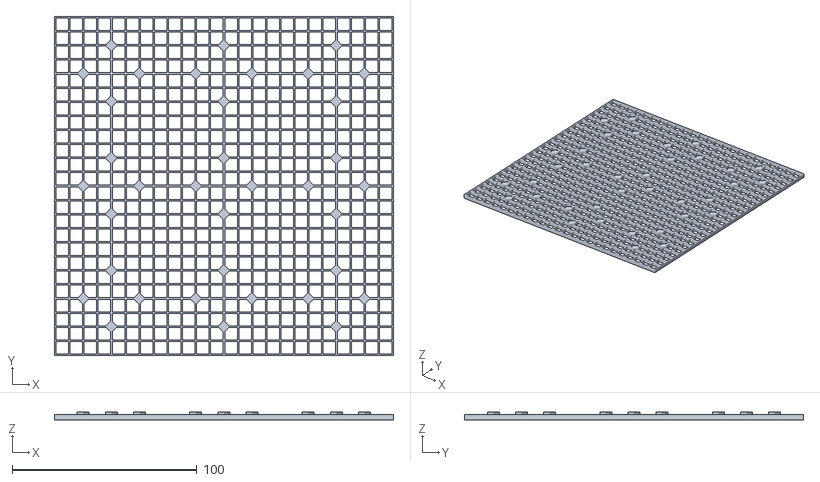
[picture p70: CAD file, 2019-08-28]
arduino/WyoBean32/calendar_baffles.stl
183.7 x 183.7 x 4.40
