wyolum/ClockIOT/ClockIOT_data/USB-C_breakout/USB-C_pololu/3d_modules/PinSocket_1x02_P254mm_Vertical.step

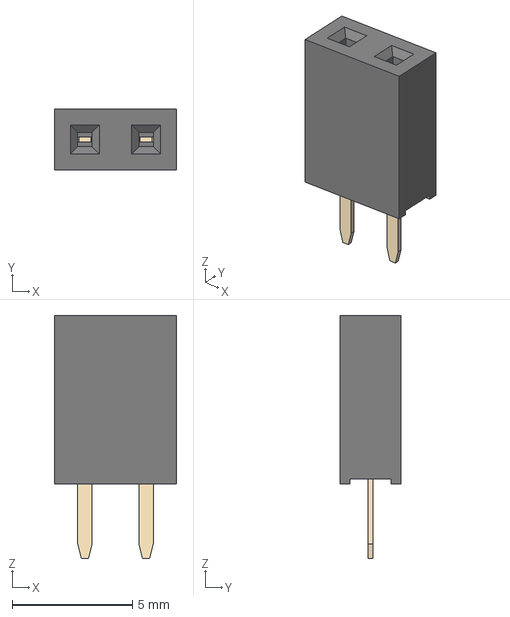
[picture p71: CAD file, 2018-10-19]
ClockIOT_data/USB-C_breakout/USB-C_pololu/3d_modules/PinSocket_1x02_P254mm_Vertical.step
5.08 x 2.54 x 10.1 mm
