wyolum/ClockIOT/kicad/ClockIOT_data/USB-C_breakout/USB-C_pololu/3d_modules/R_0805_2012Metric.step

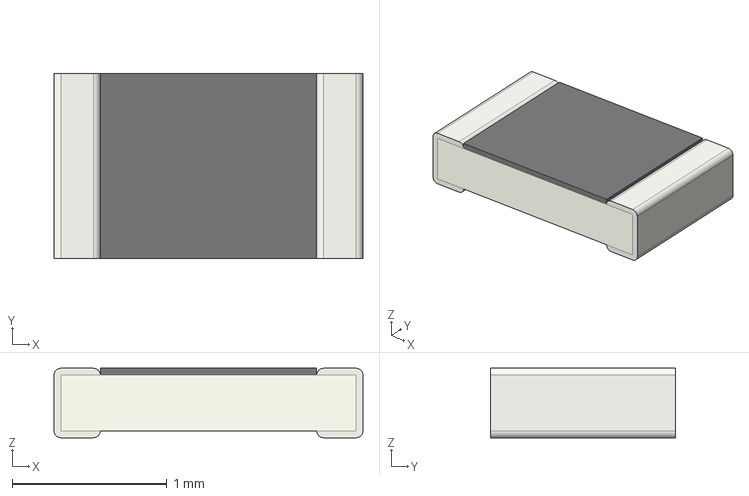
[picture p72: CAD file, 2018-10-19]
kicad/ClockIOT_data/USB-C_breakout/USB-C_pololu/3d_modules/R_0805_2012Metric.step
2.00 x 1.20 x 0.45 mm
