wyolum/ClockIOT/kicad/3d_modules/PinSocket_1x03_P254mm_Horizontal.step

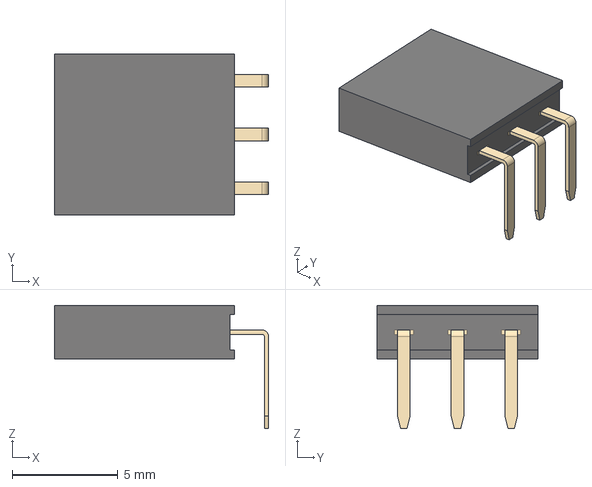
[picture p73: CAD file, 2020-01-26]
kicad/3d_modules/PinSocket_1x03_P254mm_Horizontal.step
10.1 x 7.62 x 5.84 mm
