wyolum/ClockIOT/kicad/3d_modules/SM04B-SRSS-TB.step

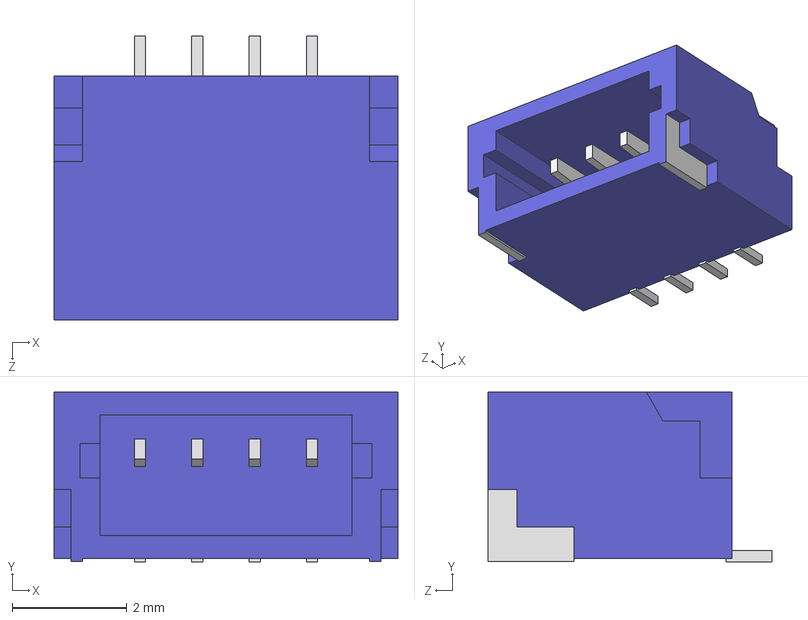
[picture p74: CAD file, 2020-01-26]
kicad/3d_modules/SM04B-SRSS-TB.step
6.00 x 2.96 x 4.95 mm
