wyolum/ClockIOT/kicad/3d_modules/PinHeader_1x03_P2_54mm_Horizontal.step

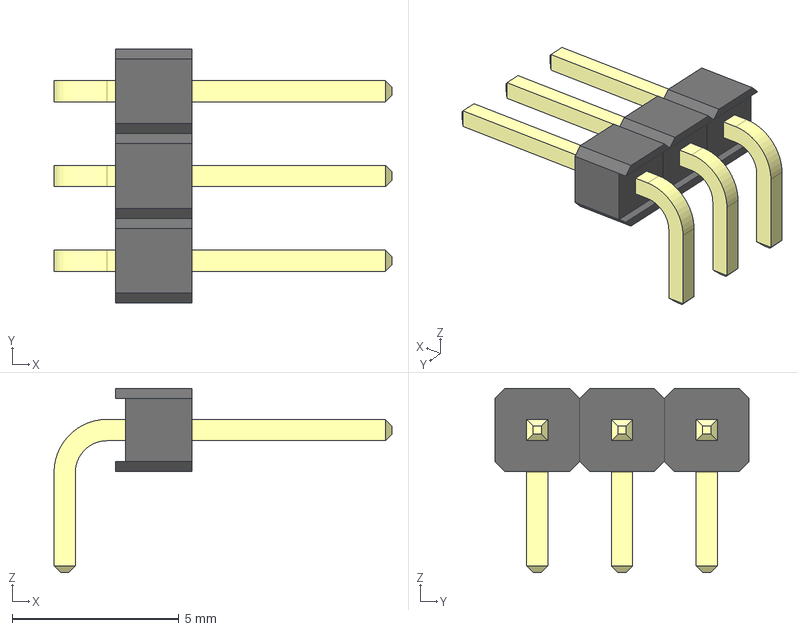
[picture p75: CAD file, 2020-01-26]
kicad/3d_modules/PinHeader_1x03_P2_54mm_Horizontal.step
10.1 x 7.62 x 5.52 mm
