wyolum/ClockIOT/kicad/3d_modules/PinHeader_1x02_P2.54mm_Vertical.step

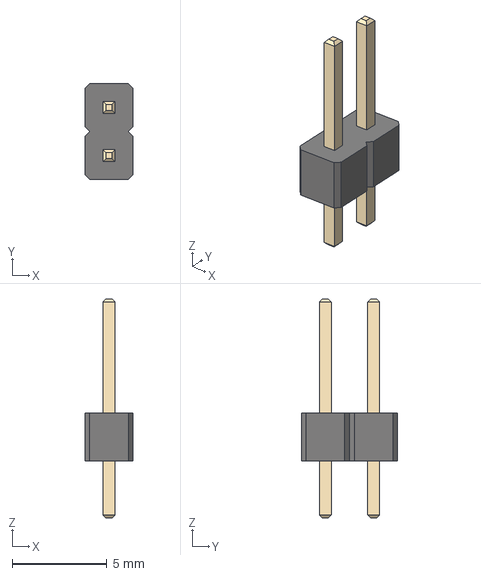
[picture p76: CAD file, 2018-10-19]
kicad/3d_modules/PinHeader_1x02_P2.54mm_Vertical.step
2.54 x 5.08 x 11.5 mm
