wyolum/ClockIOT/kicad/3d_modules/MicroUSB-B_seeed.step

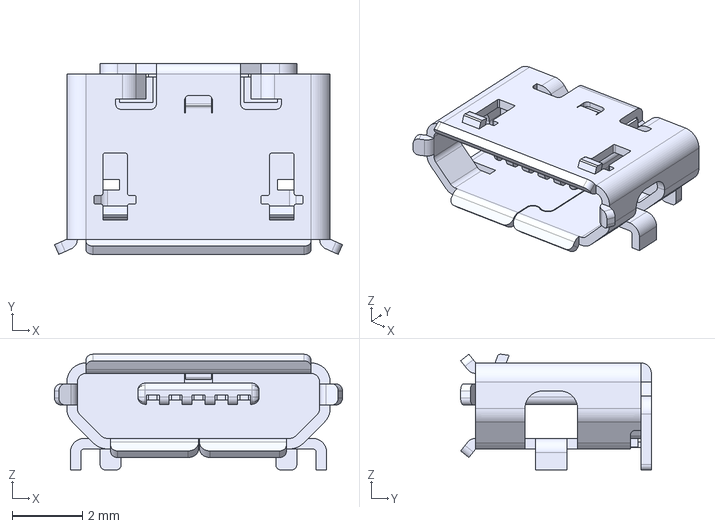
[picture p78: CAD file, 2018-08-18]
kicad/3d_modules/MicroUSB-B_seeed.step
8.20 x 5.43 x 3.30 mm
