wyolum/ClockIOT/(list of files, cad)

Other CAD files:
kicad/3d_modules/SW_SMD_70_BLK.step
kicad/3d_modules/SW_SMD_43_RED.step
kicad/ClockIOT_data/USB-C_breakout/USB-C_pololu/3d_modules/User Library-1054500101.step
ClockIOT_data/USB-C_breakout/USB-C_pololu/3d_modules/User Library-1054500101.step
kicad/3d_modules/JST_SM04B-SRSS.step
kicad/3d_modules/header_Male_RA_Low_3Pin.step
kicad/3d_modules/USB-C_bout.step
kicad/3d_modules/usb-c-breakout.step
kicad/kicad_old_versions/kicad_v4/3d_modules/D_1006-LLP1006-2L.step
kicad/kicad_old_versions/kicad_v4/3d_modules/D_LLP1006-2L.step
kicad/kicad_old_versions/kicad_v4/3d_modules/D_SOD_123.step
kicad/kicad_old_versions/kicad_v4/3d_modules/LED_SMD_APA102.step
kicad/kicad_old_versions/kicad_v4/3d_modules/LED_SMD_APA102_01.step
kicad/kicad_old_versions/kicad_v4/3d_modules/LED_SMD_APA102_02.step
kicad/kicad_old_versions/kicad_v4/3d_modules/MappyDot.step
kicad/kicad_old_versions/kicad_v4/3d_modules/MicroUSB-B_Molex_105017-0001.step
kicad/kicad_old_versions/kicad_v4/3d_modules/QFN-28.step
kicad/kicad_old_versions/kicad_v4/3d_modules/QFN28-0_5.step
kicad/kicad_old_versions/kicad_v4/3d_modules/QFN_28_1EP_5x5mm.step
kicad/kicad_old_versions/kicad_v4/3d_modules/SOD-123.step
kicad/kicad_old_versions/kicad_v4/3d_modules/SOIC16_Wide.step
kicad/kicad_old_versions/kicad_v4/3d_modules/SOT-143.step
kicad/kicad_old_versions/kicad_v4/3d_modules/SOT-223.step
kicad/kicad_old_versions/kicad_v4/3d_modules/SOT-363.step
kicad/kicad_old_versions/kicad_v4/3d_modules/SOT_223_3.step
kicad/kicad_old_versions/kicad_v4/3d_modules/SOT_363.step
kicad/kicad_old_versions/kicad_v4/3d_modules/USB-C_bout.step
kicad/kicad_old_versions/kicad_v4/3d_modules/bat_2032_2.step
kicad/kicad_old_versions/kicad_v4/3d_modules/bat_2032_BK-912_V1I3.step
kicad/kicad_old_versions/kicad_v4/3d_modules/bat_cr2032.step
kicad/kicad_old_versions/kicad_v4/3d_modules/cap_0805_2012M.step
kicad/kicad_old_versions/kicad_v4/3d_modules/cap_1210_3225M.step
kicad/kicad_old_versions/kicad_v4/3d_modules/cap_2917_7343M.step
kicad/kicad_old_versions/kicad_v4/3d_modules/do214aa.step
kicad/kicad_old_versions/kicad_v4/3d_modules/esp-wroom-32.step
kicad/kicad_old_versions/kicad_v4/3d_modules/fuse_1812_4532M.step
kicad/kicad_old_versions/kicad_v4/3d_modules/header_1x3_TH_2_54mm.step
kicad/kicad_old_versions/kicad_v4/3d_modules/header_Male_RA_Low_3Pin.step
kicad/kicad_old_versions/kicad_v4/3d_modules/led_0805.step
kicad/kicad_old_versions/kicad_v4/3d_modules/mappydot1.step
kicad/kicad_old_versions/kicad_v4/3d_modules/r_0805.step
kicad/kicad_old_versions/kicad_v4/3d_modules/socket_ra_2pin.step
kicad/kicad_old_versions/kicad_v4/3d_modules/socket_ra_4pin.step
kicad/kicad_old_versions/kicad_v4/3d_modules/sw_pb_smd.step
kicad/kicad_old_versions/kicad_v4/3d_modules/usb-c-breakout.step
kicad/kicad_old_versions/kicad_v4/ClockIOT_data/USB-C_breakout/USB-C_pololu/3d_modules/User Library-1054500101.step
kicad_v0/3d_modules/D_1006-LLP1006-2L.step
kicad_v0/3d_modules/D_LLP1006-2L.step
kicad_v0/3d_modules/D_SOD_123.step
kicad_v0/3d_modules/LED_SMD_APA102.step
kicad_v0/3d_modules/LED_SMD_APA102_01.step
kicad_v0/3d_modules/LED_SMD_APA102_02.step
kicad_v0/3d_modules/MappyDot.step
kicad_v0/3d_modules/MicroUSB-B_Molex_105017-0001.step
kicad_v0/3d_modules/QFN-28.step
kicad_v0/3d_modules/QFN28-0_5.step
kicad_v0/3d_modules/QFN_28_1EP_5x5mm.step
kicad_v0/3d_modules/SOD-123.step
kicad_v0/3d_modules/SOIC16_Wide.step
kicad_v0/3d_modules/SOT-143.step
kicad_v0/3d_modules/SOT-223.step
kicad_v0/3d_modules/SOT-363.step
kicad_v0/3d_modules/SOT_223_3.step
kicad_v0/3d_modules/SOT_363.step
kicad_v0/3d_modules/bat_2032_2.step
kicad_v0/3d_modules/bat_2032_BK-912_V1I3.step
kicad_v0/3d_modules/bat_cr2032.step
kicad_v0/3d_modules/cap_0805_2012M.step
kicad_v0/3d_modules/cap_1210_3225M.step
kicad_v0/3d_modules/cap_2917_7343M.step
kicad_v0/3d_modules/do214aa.step
kicad_v0/3d_modules/esp-wroom-32.step
kicad_v0/3d_modules/fuse_1812_4532M.step
kicad_v0/3d_modules/header_1x3_TH_2_54mm.step
kicad_v0/3d_modules/header_Male_RA_Low_3Pin.step
kicad_v0/3d_modules/led_0805.step
kicad_v0/3d_modules/mappydot1.step
kicad_v0/3d_modules/r_0805.step
kicad_v0/3d_modules/socket_ra_2pin.step
kicad_v0/3d_modules/socket_ra_4pin.step
kicad_v0/3d_modules/sw_pb_smd.step
kicad_v1/3d_modules/D_1006-LLP1006-2L.step
kicad_v1/3d_modules/D_LLP1006-2L.step
kicad_v1/3d_modules/D_SOD_123.step
kicad_v1/3d_modules/LED_SMD_APA102.step
kicad_v1/3d_modules/LED_SMD_APA102_01.step
kicad_v1/3d_modules/LED_SMD_APA102_02.step
kicad_v1/3d_modules/MappyDot.step
kicad_v1/3d_modules/MicroUSB-B_Molex_105017-0001.step
kicad_v1/3d_modules/QFN-28.step
kicad_v1/3d_modules/QFN28-0_5.step
kicad_v1/3d_modules/QFN_28_1EP_5x5mm.step
kicad_v1/3d_modules/SOD-123.step
kicad_v1/3d_modules/SOIC16_Wide.step
kicad_v1/3d_modules/SOT-143.step
kicad_v1/3d_modules/SOT-223.step
kicad_v1/3d_modules/SOT-363.step
kicad_v1/3d_modules/SOT_223_3.step
kicad_v1/3d_modules/SOT_363.step
kicad_v1/3d_modules/bat_2032_2.step
kicad_v1/3d_modules/bat_2032_BK-912_V1I3.step
kicad_v1/3d_modules/bat_cr2032.step
kicad_v1/3d_modules/cap_0805_2012M.step
kicad_v1/3d_modules/cap_1210_3225M.step
kicad_v1/3d_modules/cap_2917_7343M.step
kicad_v1/3d_modules/do214aa.step
kicad_v1/3d_modules/esp-wroom-32.step
kicad_v1/3d_modules/fuse_1812_4532M.step
kicad_v1/3d_modules/header_1x3_TH_2_54mm.step
kicad_v1/3d_modules/header_Male_RA_Low_3Pin.step
kicad_v1/3d_modules/led_0805.step
kicad_v1/3d_modules/mappydot1.step
kicad_v1/3d_modules/r_0805.step
kicad_v1/3d_modules/socket_ra_2pin.step
kicad_v1/3d_modules/socket_ra_4pin.step
kicad_v1/3d_modules/sw_pb_smd.step
kicad_v3/3d_modules/D_1006-LLP1006-2L.step
kicad_v3/3d_modules/D_LLP1006-2L.step
kicad_v3/3d_modules/D_SOD_123.step
kicad_v3/3d_modules/LED_SMD_APA102.step
kicad_v3/3d_modules/LED_SMD_APA102_01.step
kicad_v3/3d_modules/LED_SMD_APA102_02.step
kicad_v3/3d_modules/MappyDot.step
kicad_v3/3d_modules/MicroUSB-B_Molex_105017-0001.step
kicad_v3/3d_modules/QFN-28.step
kicad_v3/3d_modules/QFN28-0_5.step
kicad_v3/3d_modules/QFN_28_1EP_5x5mm.step
kicad_v3/3d_modules/SOD-123.step
kicad_v3/3d_modules/SOIC16_Wide.step
kicad_v3/3d_modules/SOT-143.step
kicad_v3/3d_modules/SOT-223.step
kicad_v3/3d_modules/SOT-363.step
kicad_v3/3d_modules/SOT_223_3.step
kicad_v3/3d_modules/SOT_363.step
kicad_v3/3d_modules/USB-C_bout.step
kicad_v3/3d_modules/bat_2032_2.step
kicad_v3/3d_modules/bat_2032_BK-912_V1I3.step
kicad_v3/3d_modules/bat_cr2032.step
kicad_v3/3d_modules/cap_0805_2012M.step
kicad_v3/3d_modules/cap_1210_3225M.step
kicad_v3/3d_modules/cap_2917_7343M.step
kicad_v3/3d_modules/do214aa.step
kicad_v3/3d_modules/esp-wroom-32.step
kicad_v3/3d_modules/fuse_1812_4532M.step
kicad_v3/3d_modules/header_1x3_TH_2_54mm.step
kicad_v3/3d_modules/header_Male_RA_Low_3Pin.step
kicad_v3/3d_modules/led_0805.step
kicad_v3/3d_modules/mappydot1.step
kicad_v3/3d_modules/r_0805.step
kicad_v3/3d_modules/socket_ra_2pin.step
kicad_v3/3d_modules/socket_ra_4pin.step
kicad_v3/3d_modules/sw_pb_smd.step
kicad_v3/3d_modules/usb-c-breakout.step
