wyolum/ClockIOT/arduino/hardware/espressif/esp32/docs/make.md

To use make
============

 [makeEspArduino](https://github.com/plerup/makeEspArduino) is a generic makefile for any ESP8266/ESP32 Arduino project.Using make instead of the Arduino IDE makes it easier to do automated and production builds.
