wyolum/ClockIOT/kicad/seeed_production_files/ClockIOT_ASSEMBLY/ciot_baffle_H_01.pdf

Horizontal Baffle : 10 per clock Thickness : 0.06"
Material : Acrylic, Black

6.8inch
