wyolum/ClockIOT/kicad/seeed_production_files/ClockIOT_ASSEMBLY/ciot_baffle_V_01.pdf

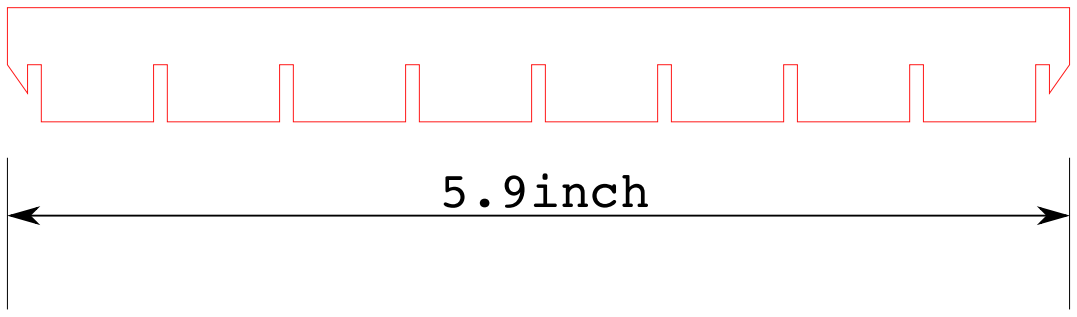
[picture p79: figure]
5.9inch

Vertical Baffle : 18 per clock Thickness : 0.06"
Material : Acrylic, Black
