wyolum/ClockIOT/fabricate/Chomogram/chromogram_baffle_H_01.pdf

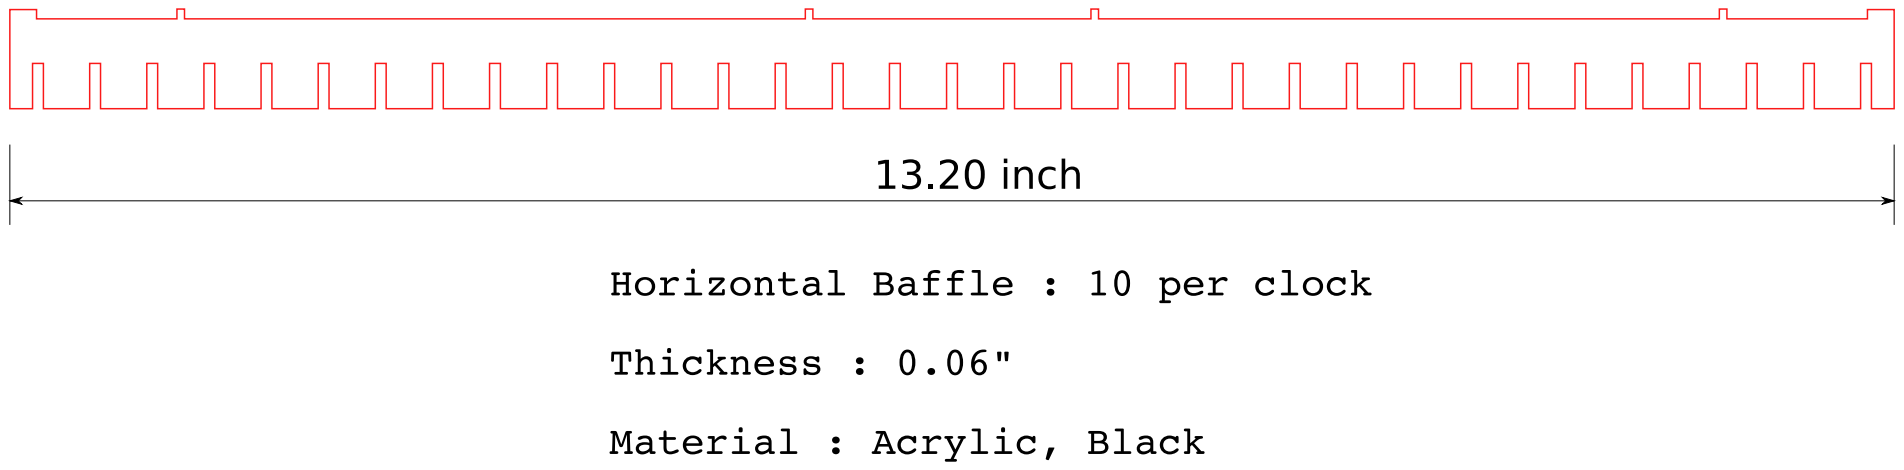
[picture p80: page 1]
