wyolum/ClockIOT/fabricate/Faceplates/english_v3_StardosStencil-Regular_lower_v2jr_std1.0.pdf

english_v3_StardosStencil-Regular_lower_v2 std1.0

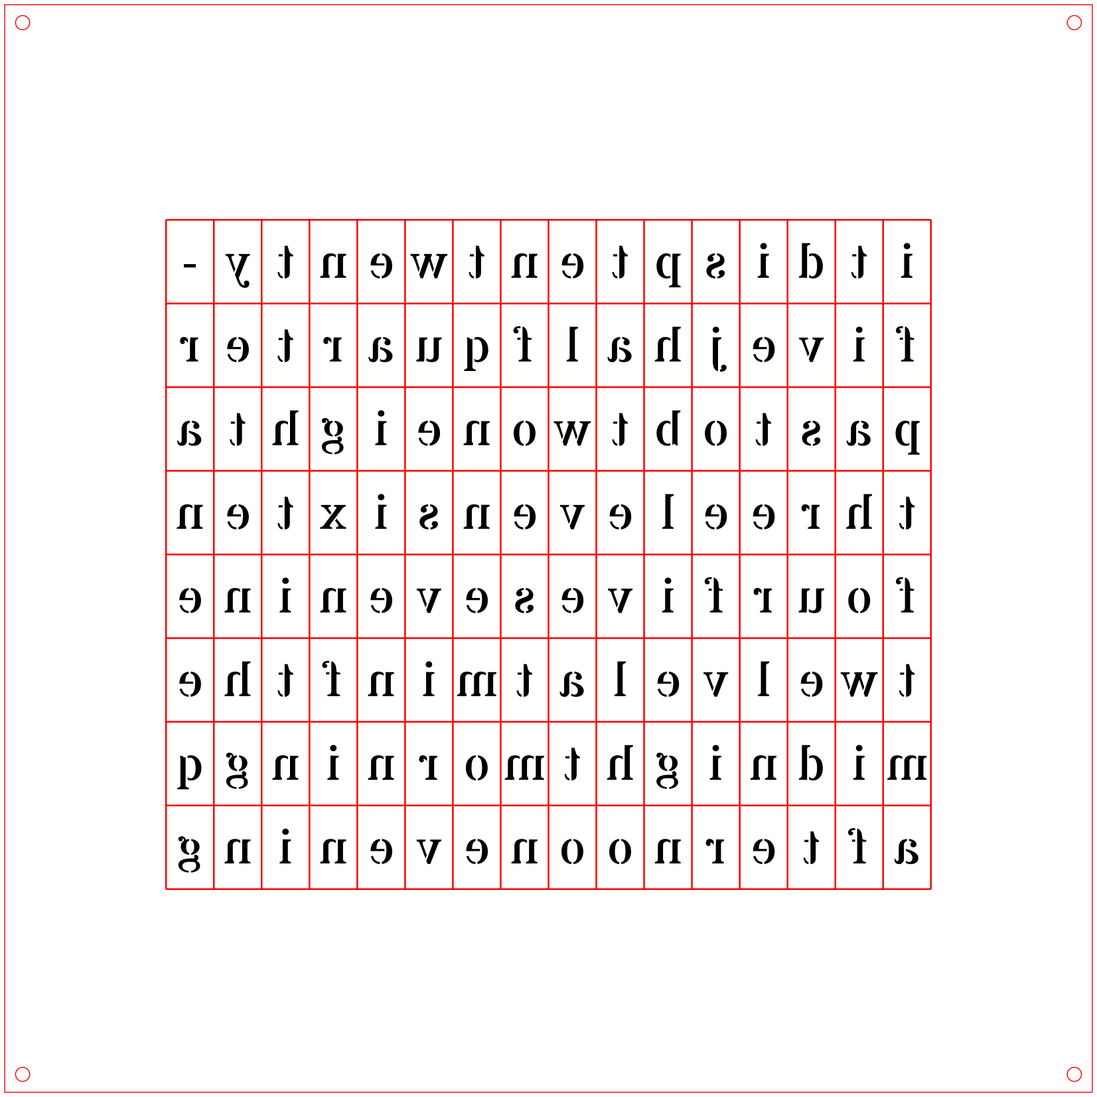
[picture p81: figure]
