wyolum/ClockIOT/fabricate/Faceplates/itialian_v1_StardosStencil-Regular_lower_v2jr_std1.0.pdf

itialian_v1_StardosStencil-Regular_lower_v2 std1.0

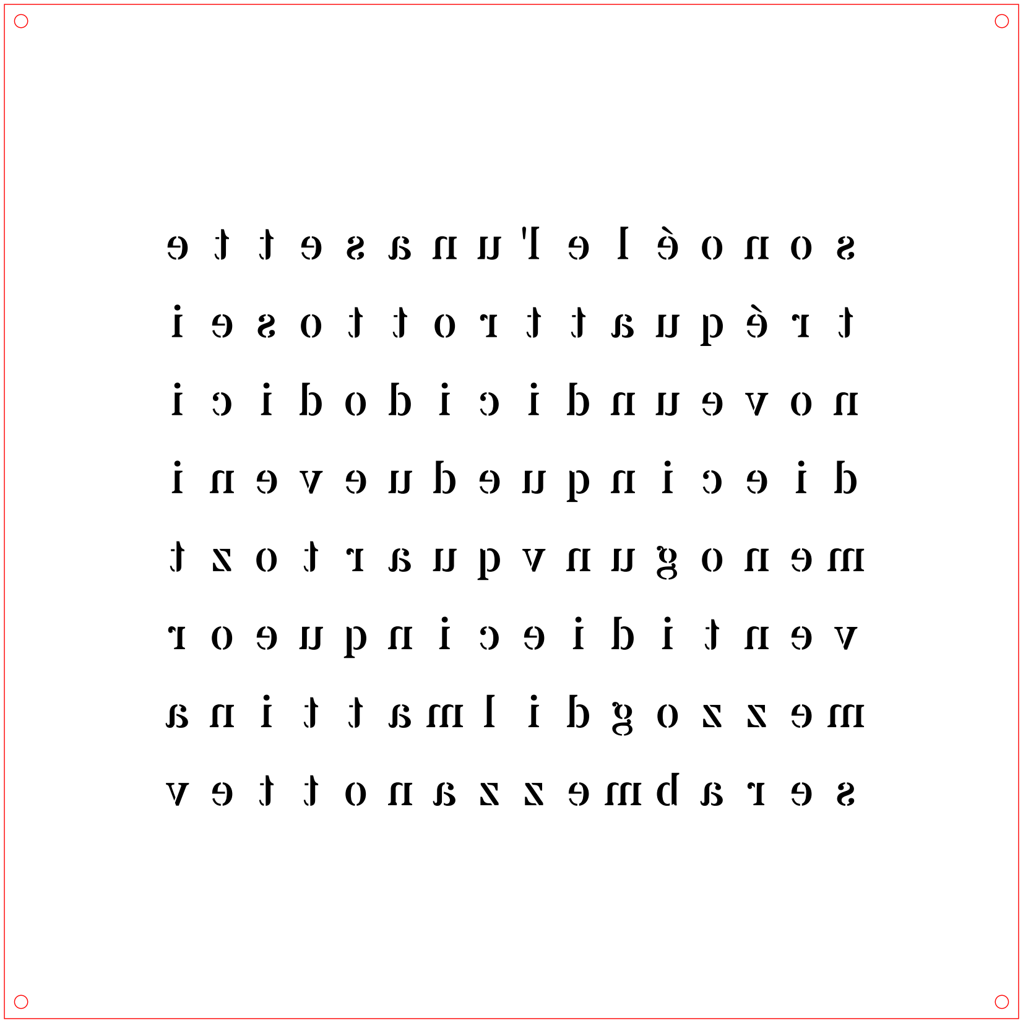
[picture p84: figure]
