wyolum/ClockIOT/fabricate/Faceplates/spanish_v1_DroidSans_lower_v2jr_std1.0.pdf

spanish_v1_DroidSans_lower_v2 std1.0

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
