wyolum/ClockIOT/kicad/kicad_old_versions/kicad_v4/seeed_production_files/ClockIOT_ASSEMBLY/ciot_localizer_01.pdf

Localizers : 4 per clock
Thickness : 0.06"
Material : Acrylic, Black

0.36inch
