wyolum/ClockIOT/fabricate/Faceplates/hungarian_v1_StardosStencil-Regular_lower_v2jr_std1.0.pdf

hungarian_v1_StardosStencil-Regular_lower_v2 std1.0

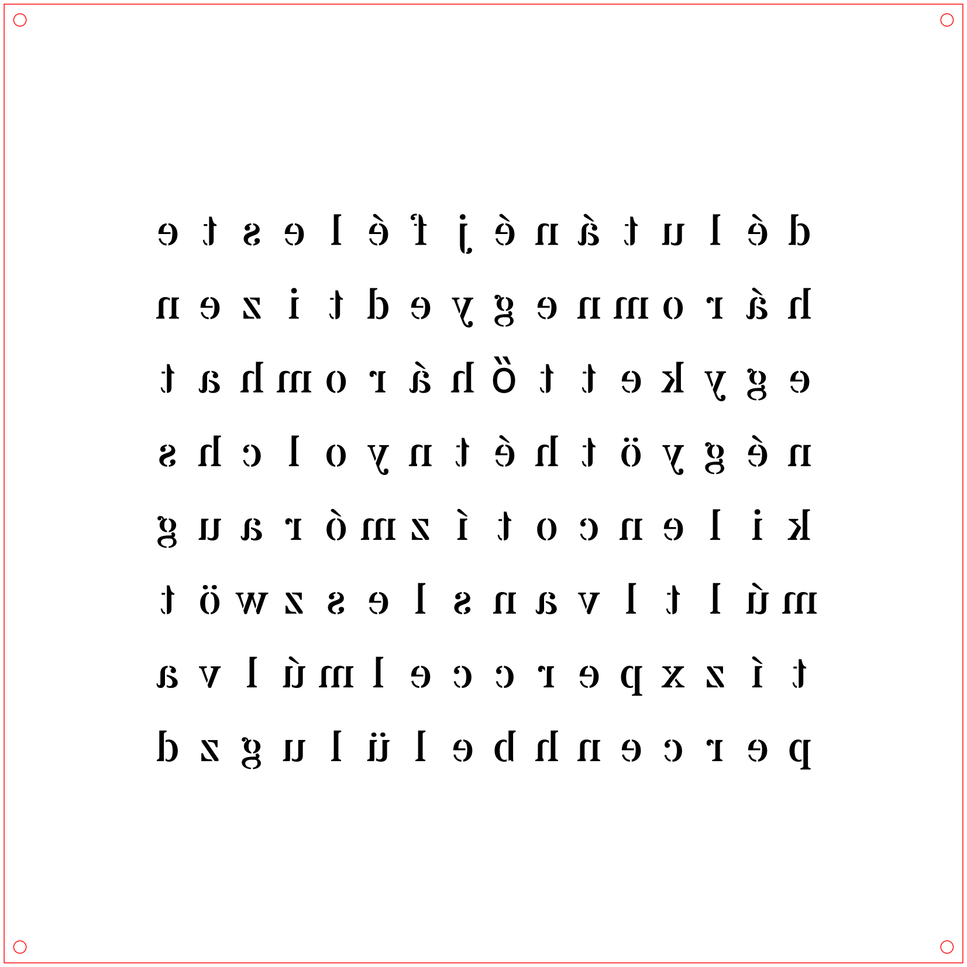
[picture p85: figure]
