wyolum/ClockIOT/fabricate/Faceplates/hungarian_v1_TC_LaserSans_lower_v2jr_std1.0.pdf

hungarian_v1_TC_LaserSans_lower_v2 std1.0

e t s e l é f j é n á t u l é d

n e z i t d e y g e n mo r á h

t a h mo r á h t t e k y g e

s h c l o y n t é h t ö y g é n

g u a r ó mz í t o c n e l i k

t ö wz s e l s n a v l t l ú m

a v l ú ml e c c r e p x z í t

d z g u l ü l e b h n e c r e p
