wyolum/ClockIOT/kicad/seeed_production_files/ClockIOT_ASSEMBLY/ClockIOT_assembly_images_CAD/clockiot_assy_04.png

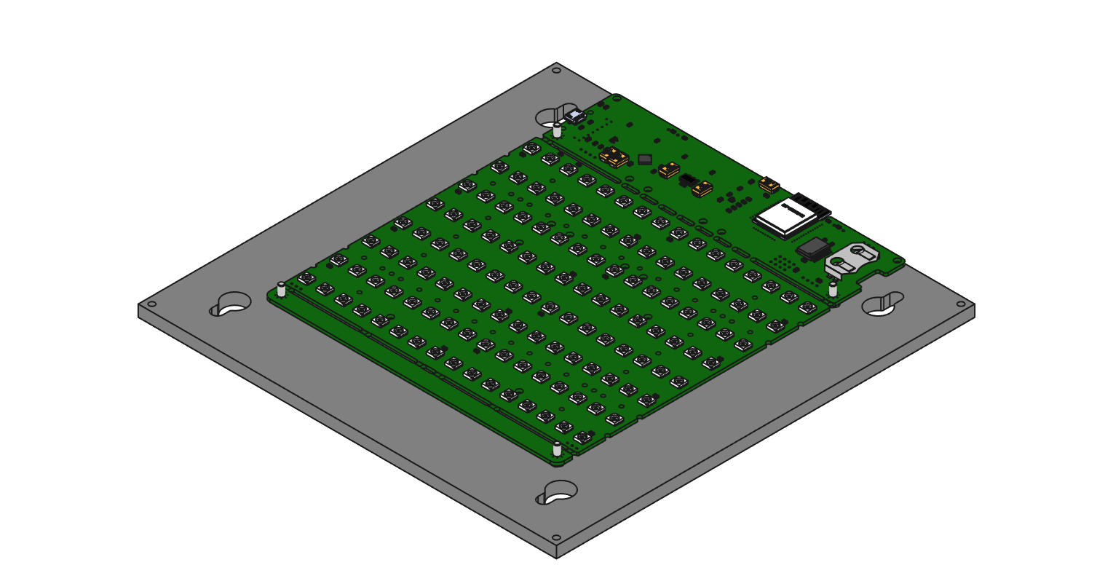
kicad/seeed_production_files/ClockIOT_ASSEMBLY/ClockIOT_assembly_images_CAD/clockiot_assy_04.png
