wyolum/ClockIOT/Wiki/Images/setup 1.png

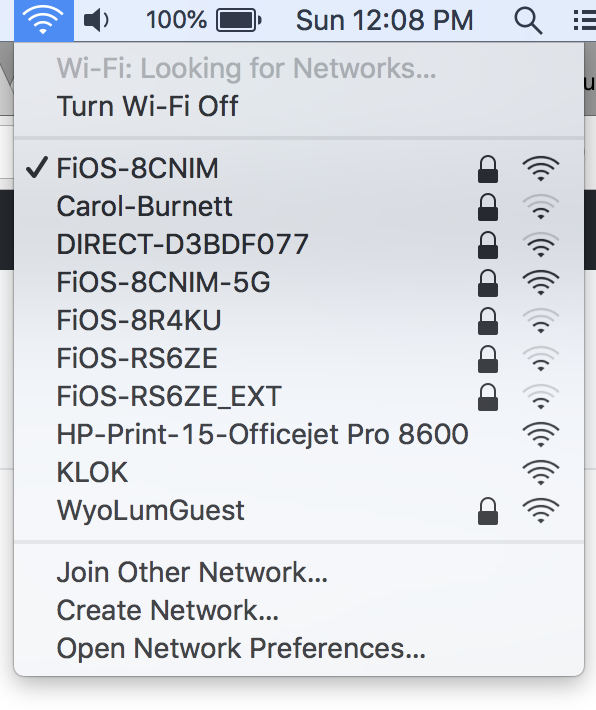
Wiki/Images/setup 1.png
