wyolum/ClockIOT/(threads)

Thread 1 (2018-09-26):

DS3231 reads are not consistant

wyojustin, 2018-09-26:
HW: ClockIOT First 5 complete protos (and no LED protos)
SW: ClockIOT (9/26/2018)

Problem:
When DS3231 is set, and subsequently read, the values can be very different.

OUTPUT: CASE 1, the absolute difference between ntp and ds3231 is greater than 5 seconds, so update ds3231. After update the incorrect value is read.  A second later, the ds3231 is off my a large value, so reset it again with same result

abs diff: 111011100111111110110110000
master: 1011011101010110001110000000001
backup: 1010100001101110001111001010001
backout wrong: 1010100001101110001111001010001
SET THE BACKUP to master: 1011011101010110001110000000001
got: 1010100001101110001111001010001

abs diff: 111011100111111110110110001
master: 1011011101010110001110000000010
backup: 1010100001101110001111001010001
backout wrong: 1010100001101110001111001010001
SET THE BACKUP to master: 1011011101010110001110000000010
got: 1010100001101110001111001010001

Thread 2 (2018-09-26):

Uploaded code does not work consistently

Anool, 2018-09-26:
Issue affects Anool's CIOT.
[MFG_CODE](https://github.com/wyolum/ClockIOT/tree/master/arduino/ClockIOT_MFGTest) works fine.
Justin's pared down [BAREBONES CODE](https://github.com/wyolum/ClockIOT/tree/master/arduino/BareBones) works.

[ClockIoT CODE](https://github.com/wyolum/ClockIOT/tree/master/arduino/ClockIOT) does not work. Results are not consistent and non-reproducible.
ClockIoT code loads without error - always.
AP mode works - most times.
It picks up a local IP - some times.
But there is no display on the LEDs - never (worked once for a few minutes).

wyojustin, 2018-09-26:
I added ntp service to the bare bones code.  Can you pull and test again?

Barebones now uses wifi manager, so you may need to setup from the Klok hotspot as before.

Anool, 2018-10-03:
WORKS.

Closed 2018-10-03.

Thread 3 (2018-09-29):

Use tall buttons for mode Inc etc

wyojustin, 2018-09-29:

wyojustin, 2018-10-05:
Use low buttons for reset and boot

Anool, 2018-10-06:
BoM updated.
Black Tall buttons for INC / DEC / MODE / ENTER
Red Short buttons for BOOT / EN
Updated BoM : https://github.com/wyolum/ClockIOT/blob/master/kicad/ClockIOT_BoM_seeed.xls

Closed 2018-10-06.

Thread 4 (2018-09-30):

Run without internet

wyojustin, 2018-09-30:
Right now, you need internet for the clock to run.  We need to be able to run in standalone mode.

wyojustin, 2018-09-30:
Add "bool stand_alone" to the configuration setting and an interface to toggle it on start up.

wyojustin, 2018-10-02:
Toggle use_wifi when Mode is depressed during start up.  Set time using buttons if use_wifi == false.

Anool, 2018-10-03:
If I keep MODE pressed, and press RST, the Klok goes in to manual mode. I can set time (hours using Mode / Ent and Minutes using Inc / Dec). I think issue can be closed.

Closed 2018-10-02.

Thread 6 (2018-10-03):

Power cord direction

Anool, 2018-10-03:
In config.h
bool FLIP_DISPLAY = true; // true: cord out bottom, false: cord out top

If cord out bottom, we ought to flip all the text on the PCB by 180 deg.

Text laser engraved on rear acrylic cover will appear upside down (EN/INC/DEC/MODE). We can't change that and will probably have to live with it.

We ought to use a right angle micro-USB cord. Cable should point north when cord is plugged in to USB socket.

Anool, 2018-10-03:
Like this

https://img.fasttechcdn.com/132/1329800/1329800-3.jpg

wyojustin, 2018-10-04:
Thanks for opening this issue to facilitate this discussion.  I think the upside down back plate is no issue at all as long as we document it well in the instructions.  The cord lies perfectly, no right angle needed.

Anool, 2018-10-04:
Sweet. Can you put the CIOT in an Ikea frame to see if the cord has any issues ?
If it works, this issue can be closed.

wyojustin, 2018-10-04:
I'll test... doubt it cord fits in RIBBA frame.

wyojustin, 2018-10-05:
I'll add a "flip_display" to the config file.

wyojustin, 2018-10-05:
Added flip_display to the config file.  You can flip display in real time now.  I think we can close this issue.

Closed 2018-10-05.

Thread 7 (2018-10-05):

Write test plan

wyojustin, 2018-10-05:
@wyojustin

Anool, 2018-10-11:
In test plan, add following steps :

1. Check USB connector anchoring. If required, add solder to anchor tabs manually
2. Check 5V0 and 3V3 rails. Replace Voltage regulator if 3V3 is not okay.

Thread 8 (2018-10-06):

UTC Offset Broken!

wyojustin, 2018-10-06:
The website at https://timezoneapi.io/api/ip revoked no-pay access.  Found work around using https://ipapi.co/json.

Need to proxy at wyolum.com in case interface changes... plus we can log locations.  Potential push upgrades.

Anool, 2018-10-06:
Code works well.

My CIOT, not so well. Keeps locking up, resetting, and generally very unstable.

Closed 2018-10-06.

Thread 9 (2018-10-06):

USB connector anchoring

Anool, 2018-10-06:
USB connector could likely get pulled out if cable is yanked.

Instructing SEEED to add extra solder on anchor tabs may help
OR
We can add two through hole pads next to the USB connector through which a piece of copper wire (component lead) can be soldered to retain the USB connector.

Adding the through holes is easy.
Deciding to add (or not) the extra retaining copper wire can be left for later.

wyojustin, 2018-10-06:
While effective, the process sounds non-standard and manually intensive.  Extra solder should suffice.

wyojustin, 2018-10-10:
Second unit broken.  USB felt secure, but came free after 3 weeks.

Anool, 2018-10-15:
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

Anool, 2018-10-16:
Mandy from Seeed
"We will optimize our production process in next batch, Modify the stencil and make sure there is enough tin for soldering. It will be solve the solder issue."

Anool will make changes to the Gerbers before submitting for Production.

Anool, 2018-10-16:
Add row of header pins to allow USB-C breakout connection in future (also useful if UCB-micro connector gets ripped out)

https://www.pololu.com/blog/790/new-product-usb-2.0-type-c-connector-breakout-board

Anool, 2018-10-19:
Moved some parts from around the USB-micro area to make space for the USB type-C breakout board from Pololu. Instead of using the Pololu breakout, it's also possible to just use the breakout pads to connect external 5V/D-/D+/GND. Details of Pololu breakout in this folder
https://github.com/wyolum/ClockIOT/tree/master/kicad/ClockIOT_data/USB-C_breakout

There are no other major changes on the board other than some track re-routing.

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

Closed 2018-10-19.

Thread 11 (2018-10-09):

Voltage and Current measurements

Anool, 2018-10-09:
I performed some tests on my CIOT. Results as below.
Using unmodified code
(logo brightness set to 30 and set.brightness set to 8)
(#define MILLI_AMPS 1000  // IMPORTANT: set the max milli-Amps of your power supply (4A = 4000mA)
Input voltage = 5.1V via current limited power supply (max current locked to 2000mA)
When CIOT starts and shows KLOK logo, current = 1200mA
When Display is blank (no LED), current = 300mA

After dialing down the brightness
(logo brightness set to 2 and set.brightness set to 4)
(#define MILLI_AMPS 500  // IMPORTANT: set the max milli-Amps of your power supply (4A = 4000mA)
Input voltage = 5.1V via current limited power supply (max current locked to 2000mA)
When CIOT starts and shows KLOK logo, current = 750mA
When Display is blank (no LED), current = 250mA

Also, across Voltage Regulator
Vinput = 4.8V (across cap C17)
Voutput = 4.2V (Across cap C18)

It seems the Voltage Regulator on my CIOT is broken, but I'm not sure why it still works.
ESP32 ought to have been fried.

I'm planning to order out a fresh V Reg AMS1117-3.3 and will report back how things pan out after replacement.

Meanwhile, can you please measure voltages across caps C17 (Vinput) and C18 (Voutput) and let mw know the results.

Anool, 2018-11-16:
Per results from @osbock

module only: Result summary:
Start up no WiFi 40-45mA
Flash Mode 20-25mA
WiFi Example 120-125mA (300mA -400mA spikes)
Deep Sleep Timer 5.xµA
Deep Sleep GPIO 6.xµA
Bluetooth low Energy [not tested yet]
BLE+WiFi [not tested yet]

@osbock
so, when I plug directly into my travel charger. not too bright, .86a 5.23V
I threw a bunch of brighters at it now it's 1.2 A.
I think the voltage coming out of the hootoo is too low.

Power issues were discussed on Google Hangouts WyoCore on 28-Oct-2018.

PHOTOS
[https://photos.app.goo.gl/UuXAhvvW89kGhtoR7](url)

[https://photos.app.goo.gl/6yz8RvhohqMX2DGv8](url)

[https://photos.app.goo.gl/hHvj3B4q5Ffk6vVt8](url)

[https://photos.app.goo.gl/6GRnLn8EG3HouY7s5](url)

RESULT :
Works well from almost all sources except a few sources which internally limit current.

Work with Seeed to select a proper  5.1V / 2.5A wall wart with international plug options.

Closed 2018-11-16.

Thread 16 (2018-11-17):

Add "Auto Detect Timezone" button to Timezone modal.

wyojustin, 2018-11-17:
Assigned to: @Pramanicin
Feature Request

Want to make it easy to revert to timezones autodetected.

Thread 19 (2018-12-10):

ClockIOT doesn't report local IP when timezone manually selected

ChaoticWyrme, 2018-12-10:
When the timezone is manually selected, the clock doesn't request it's timezone from our server, and as such it never sends it's local IP to the server. This means that the browser UI can't find any clocks that are set to use a manual timezone. Currently, the only way to fix this problem after the previous local IP entry expires is to reset the clock or use the serial interface.

wyojustin, 2018-12-15:
Ok, so now, as long as you have internet, arduino checks in with wyolum.com.  Only set timezone if "use ip timezone" is in effect.

Closed 2018-12-15.

Thread 20 (2018-12-17):

Include in Faceplate.cpp not capitalized

ChaoticWyrme, 2018-12-17:
The `#include <arduino.h>` in Faceplate.cpp causes the entire program to fail to compile on linux because linux includes are case sensitive whereas Mac and Windows includes are not.

ChaoticWyrme, 2018-12-17:
Fixed by 5473d6a

Closed 2018-12-17.
