wyolum/ClockIOT/kicad/ClockIOT_pdf/ClockIOT.pdf

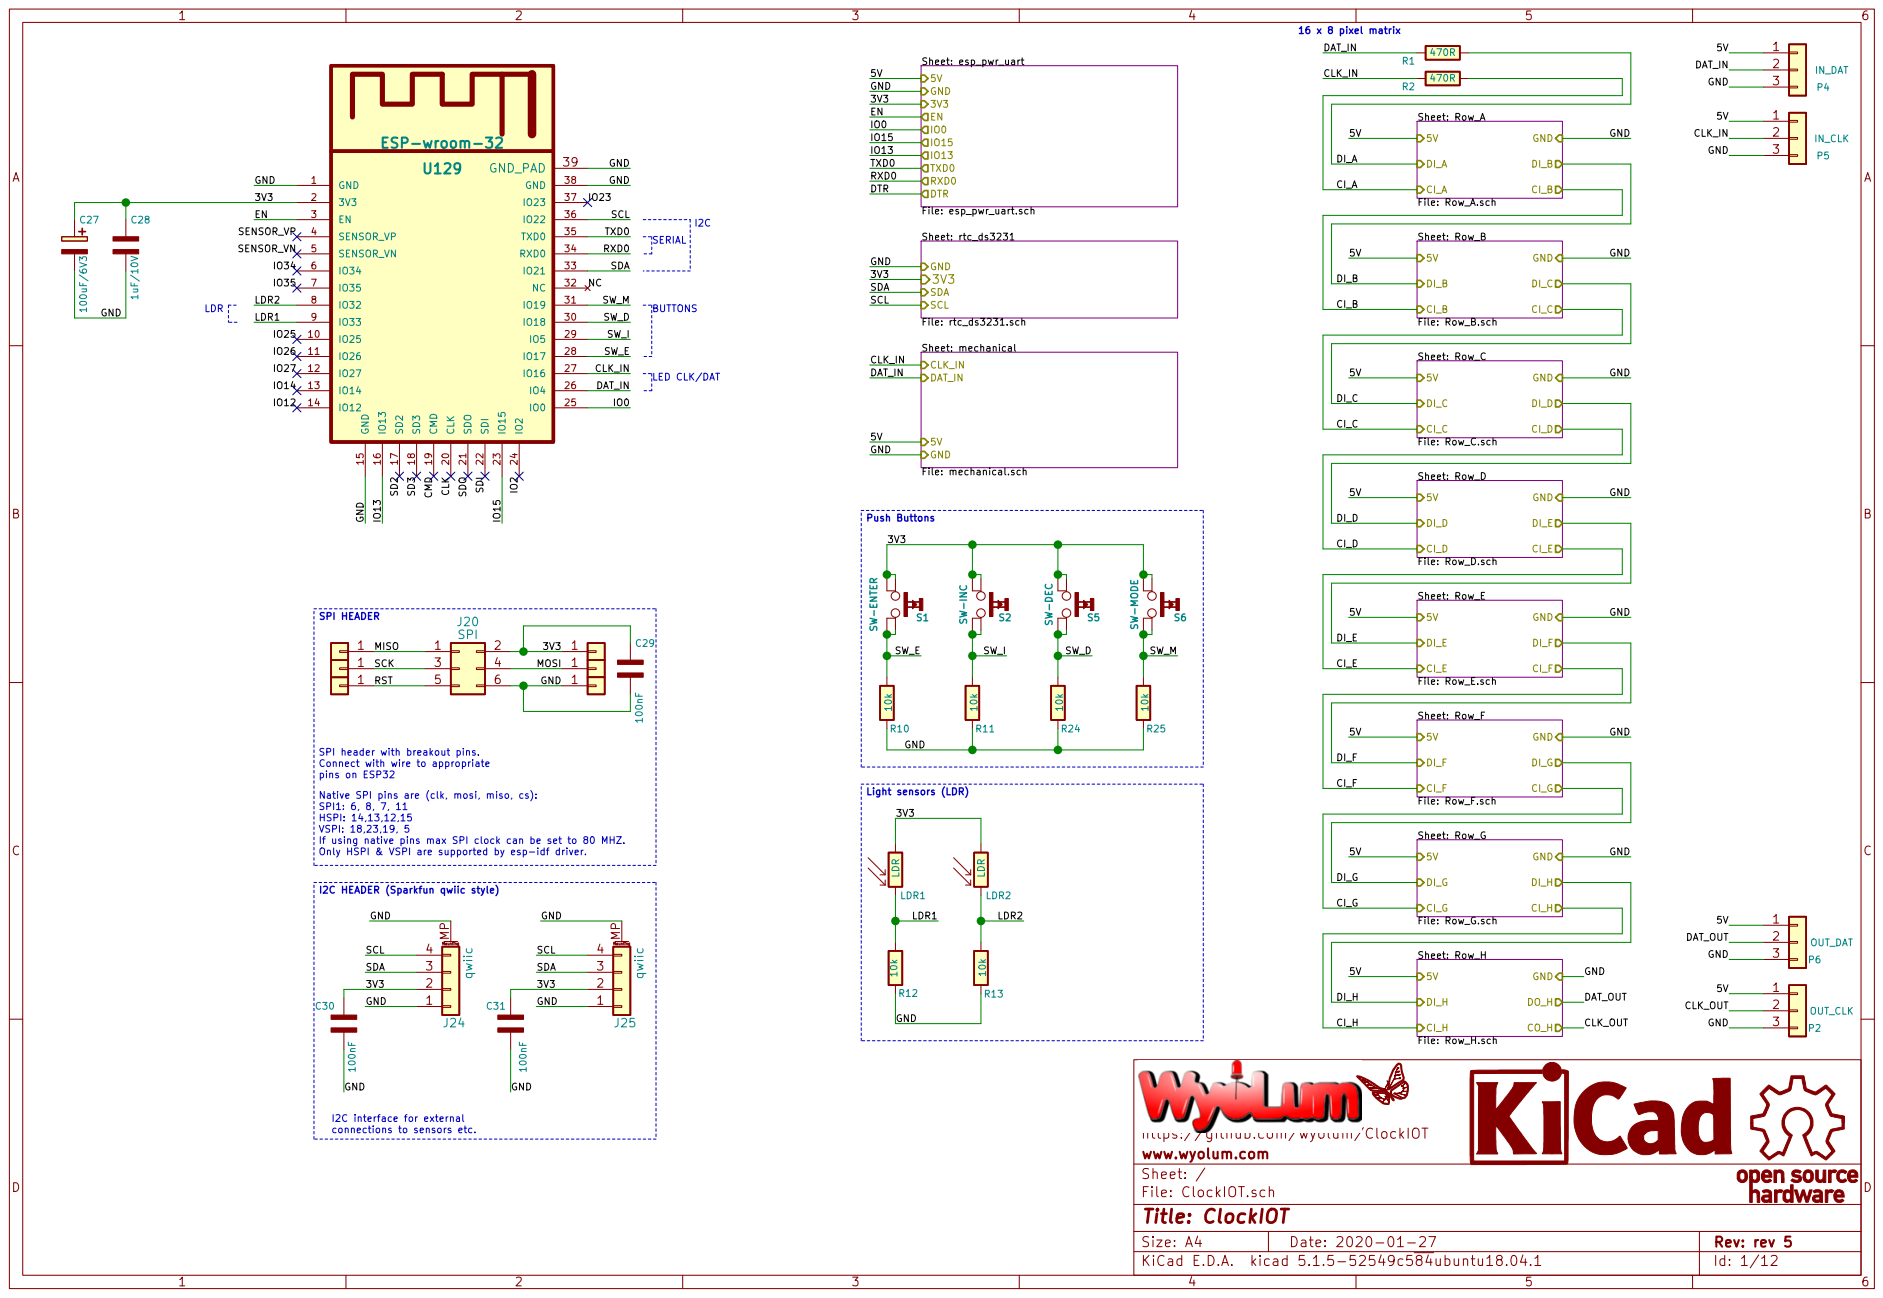
[picture p97: page 1]

16 x 8 pixel matrix SPI HEADER

Sheet: esp_pwr_uart File: esp_pwr_uart.sch GND

Sheet: rtc_ds3231 File: rtc_ds3231.sch GND

LED CLK/DAT BUTTONS

Sheet: mechanical File: mechanical.sch CLK_IN

GND GND GND GND GND

I2C interface for external connections to sensors etc. Native SPI pins are (clk, mosi, miso, cs): SPI1: 6, 8, 7, 11 HSPI: 14,13,12,15 VSPI: 18,23,19, 5

Push Buttons SPI header with breakout pins. Connect with wire to appropriate

If using native pins max SPI clock can be set to 80 MHZ. Only HSPI & VSPI are supported by esp-idf driver.

I2C HEADER (Sparkfun qwiic style)

https://github.com/wyolum/ClockIOT
File: ClockIOT.sch Sheet: / www.wyolum.com

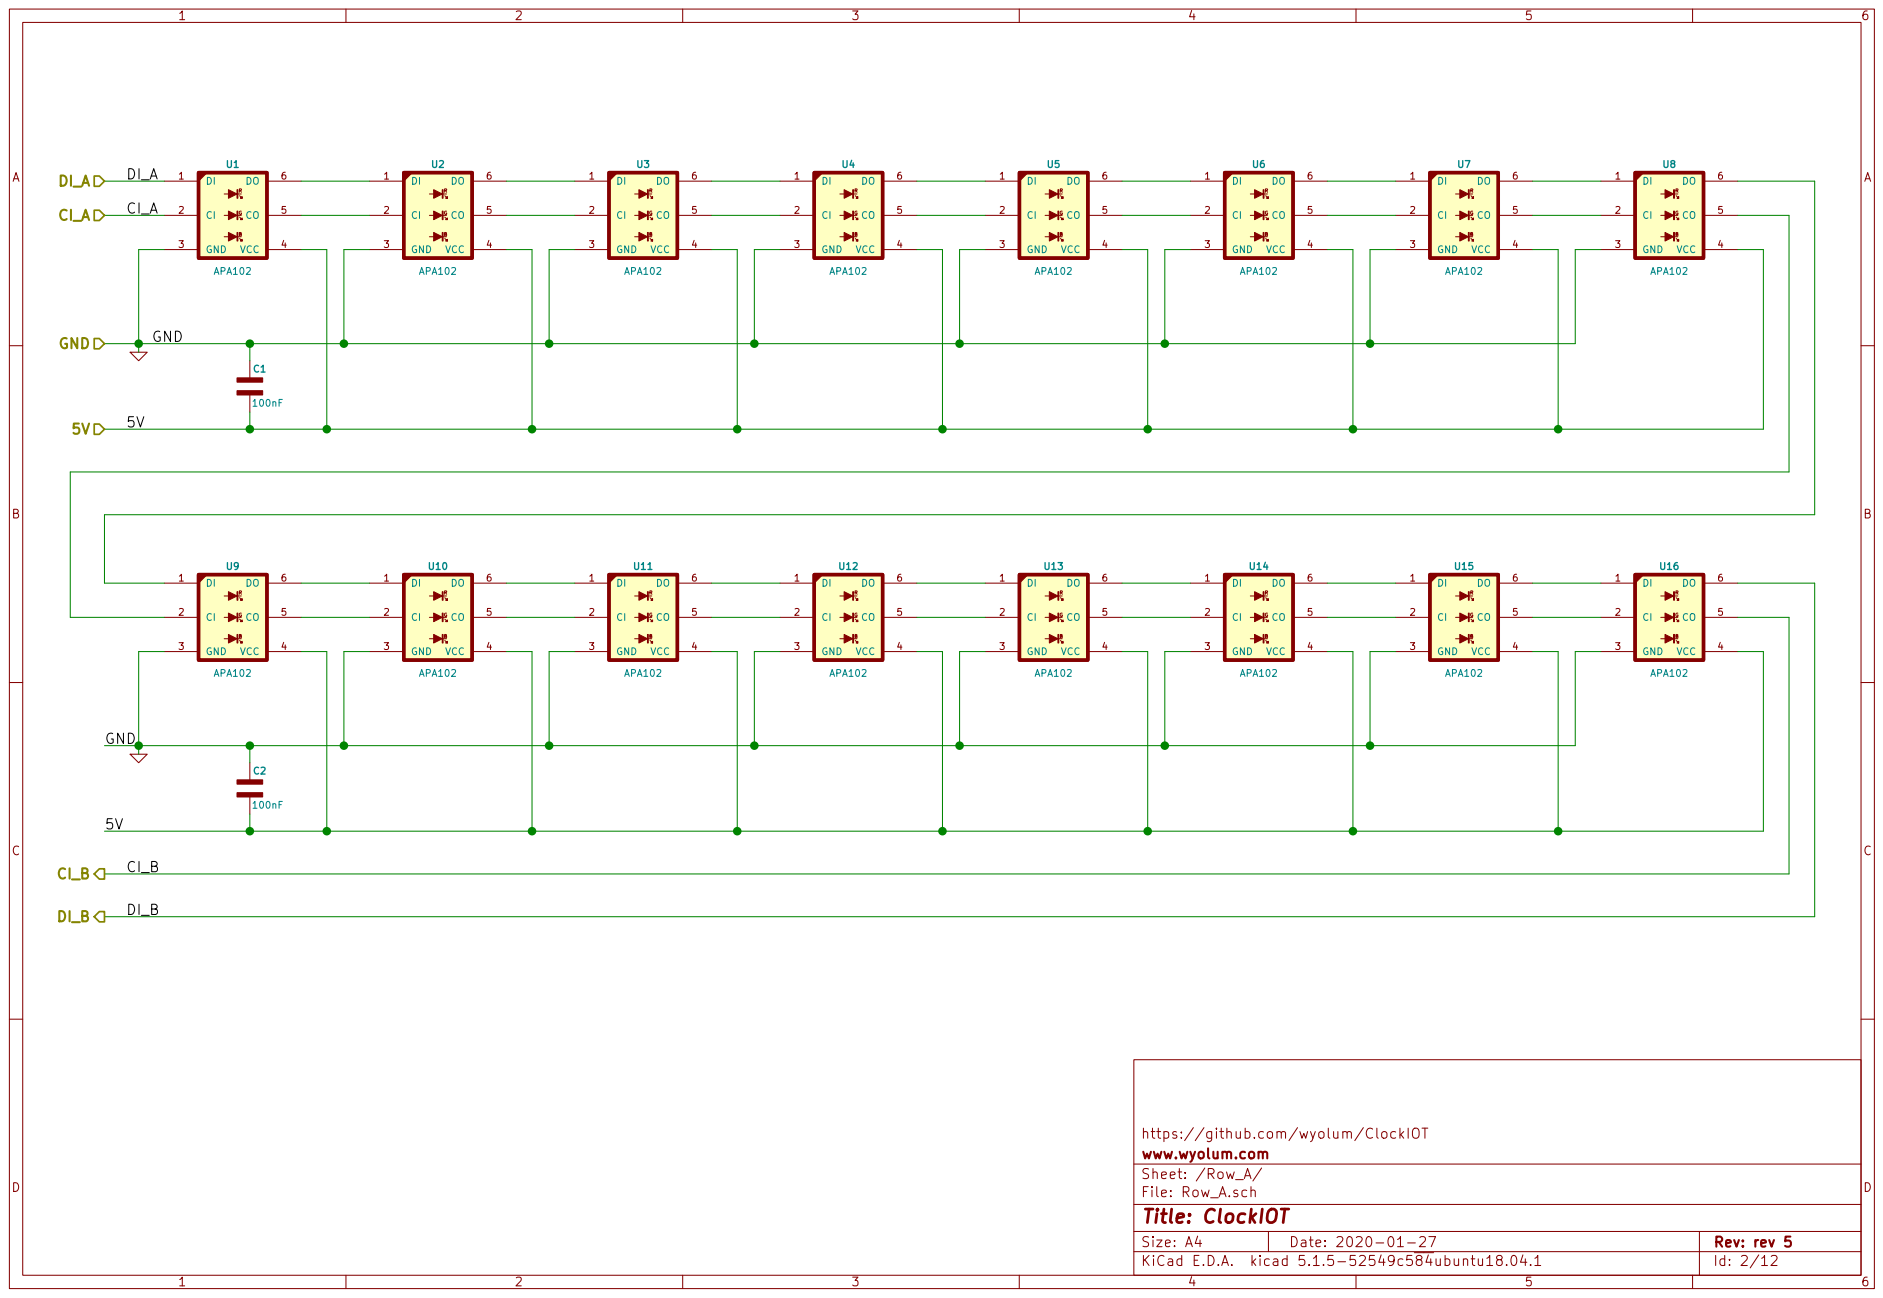
[picture p98: page 2]

https://github.com/wyolum/ClockIOT
www.wyolum.com
Sheet: /Row_A/
File: Row_A.sch
Id: 2/12 Title: ClockIOT

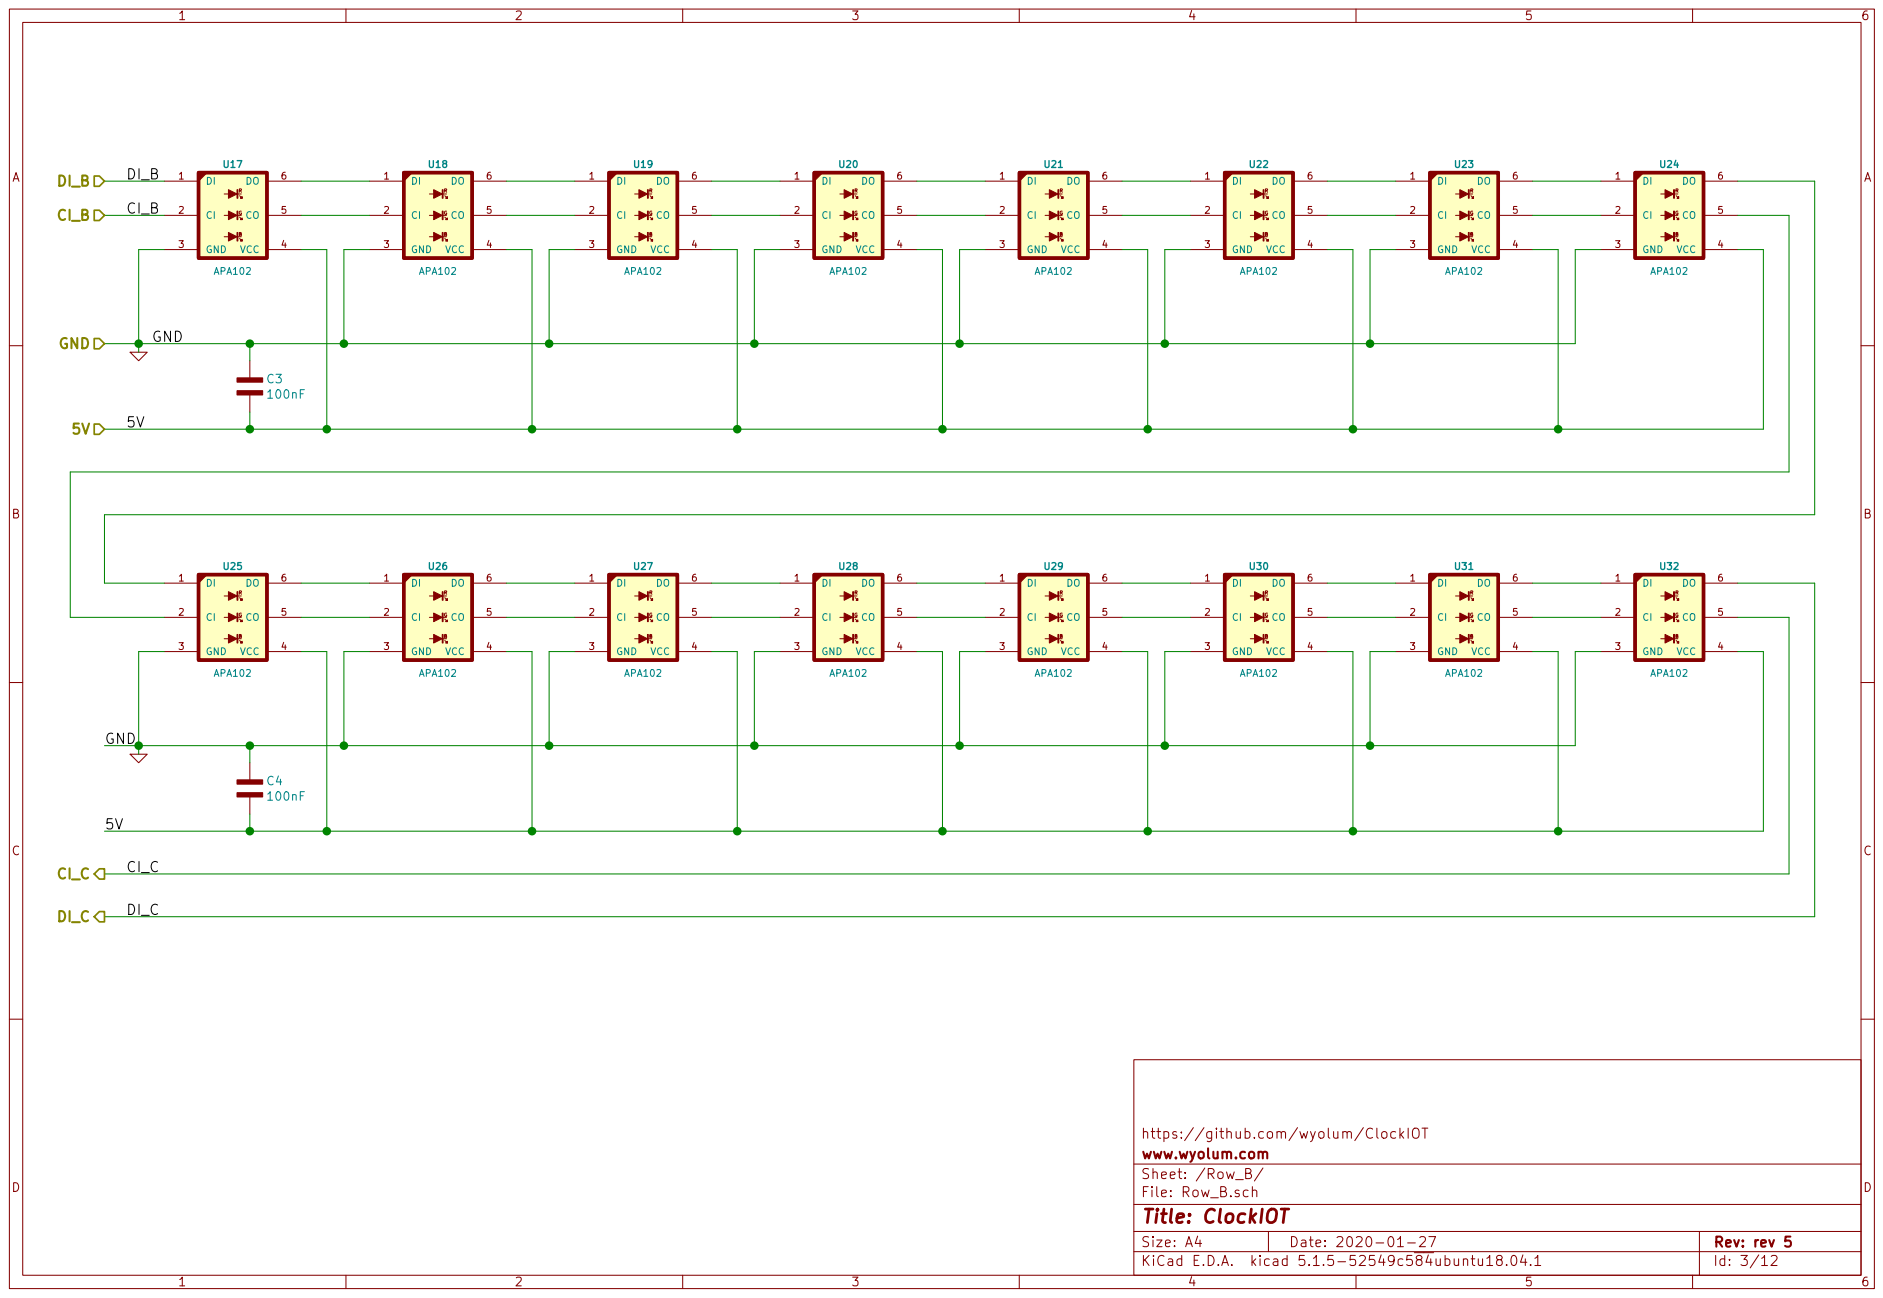
[picture p99: page 3]

https://github.com/wyolum/ClockIOT
www.wyolum.com
Sheet: /Row_B/
File: Row_B.sch
Id: 3/12 Title: ClockIOT

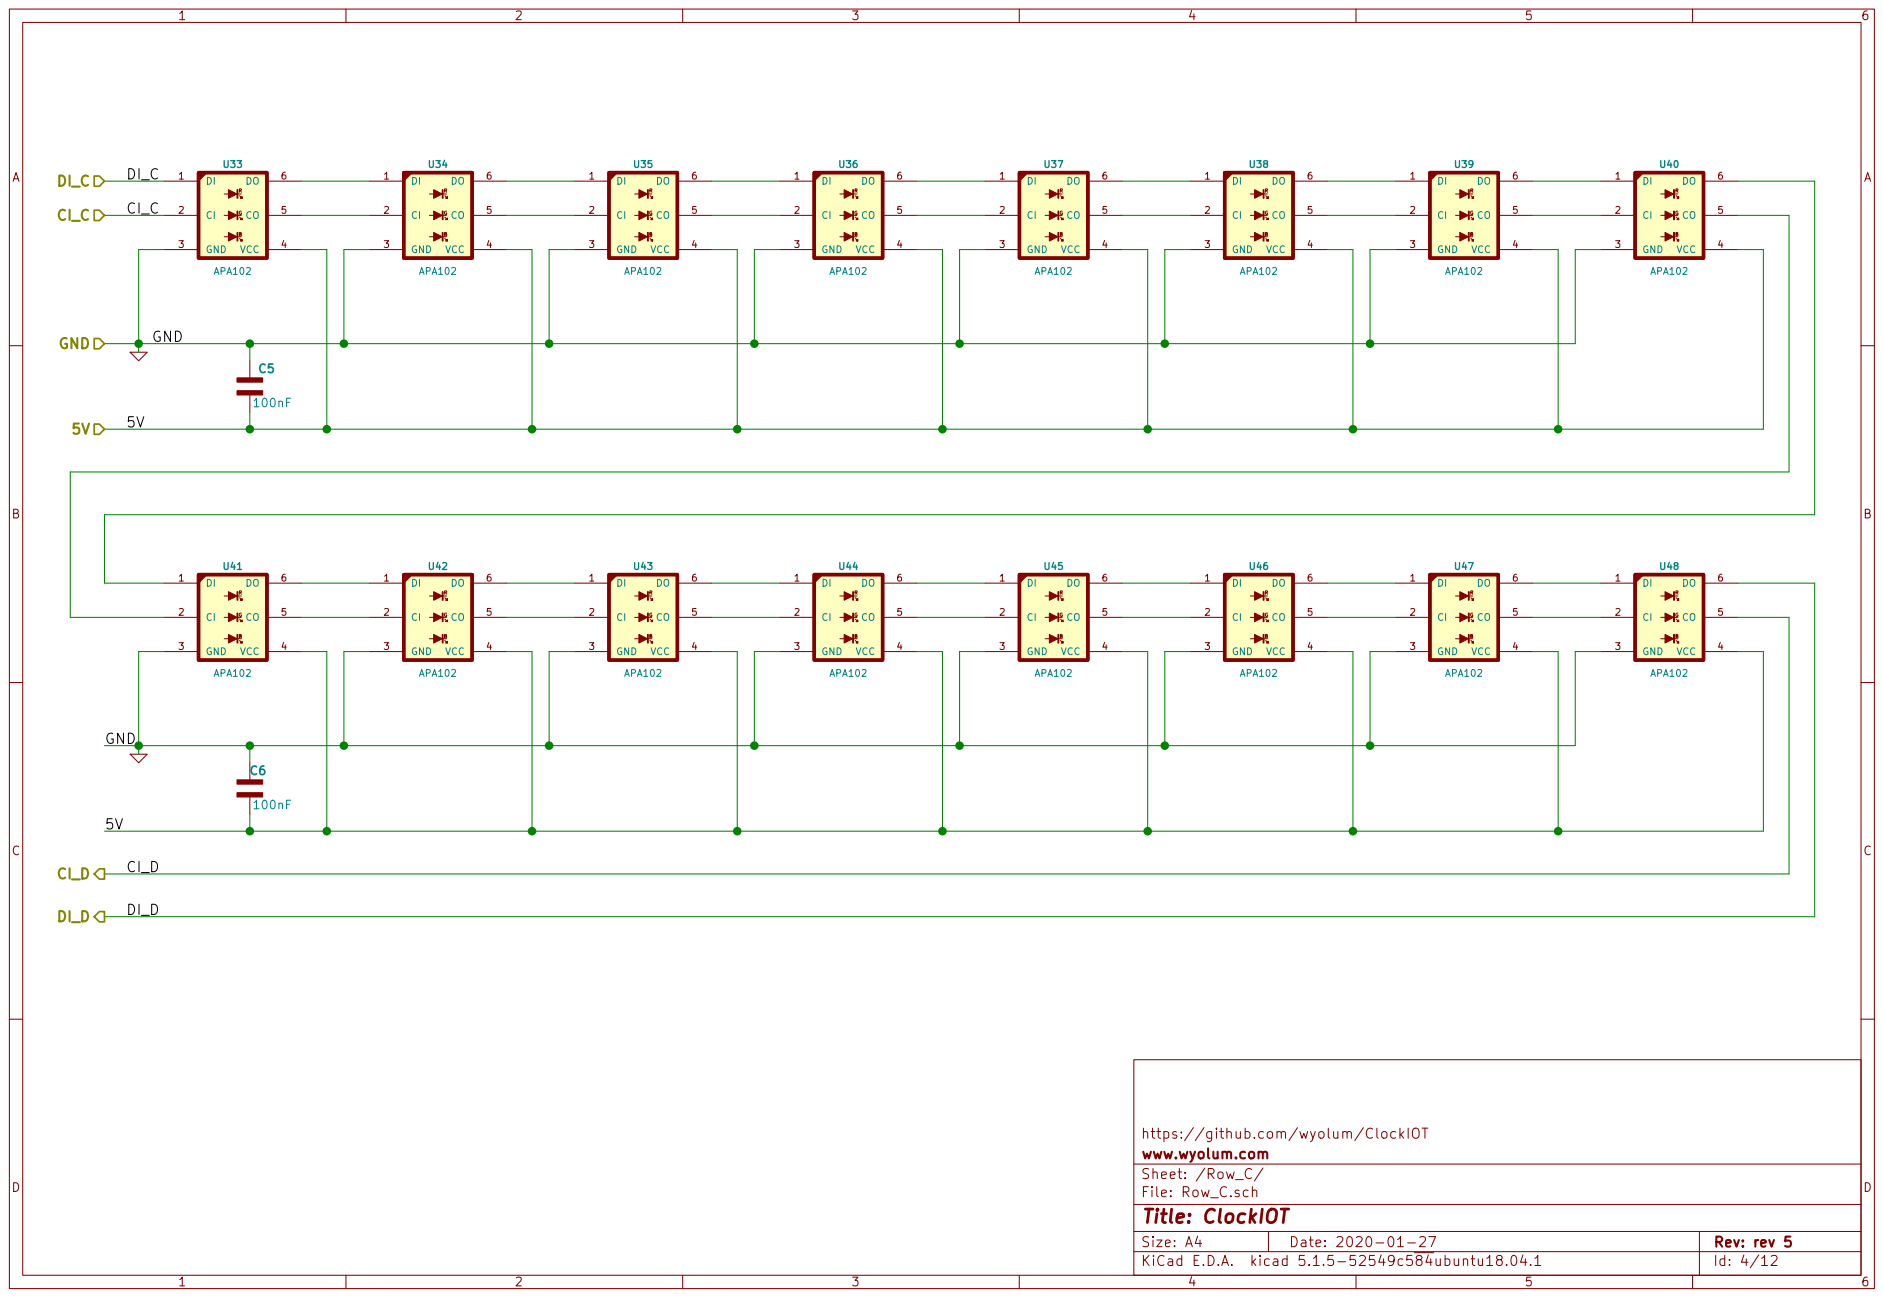
[picture p100: page 4]

https://github.com/wyolum/ClockIOT
www.wyolum.com
Sheet: /Row_C/
File: Row_C.sch
Id: 4/12 Title: ClockIOT

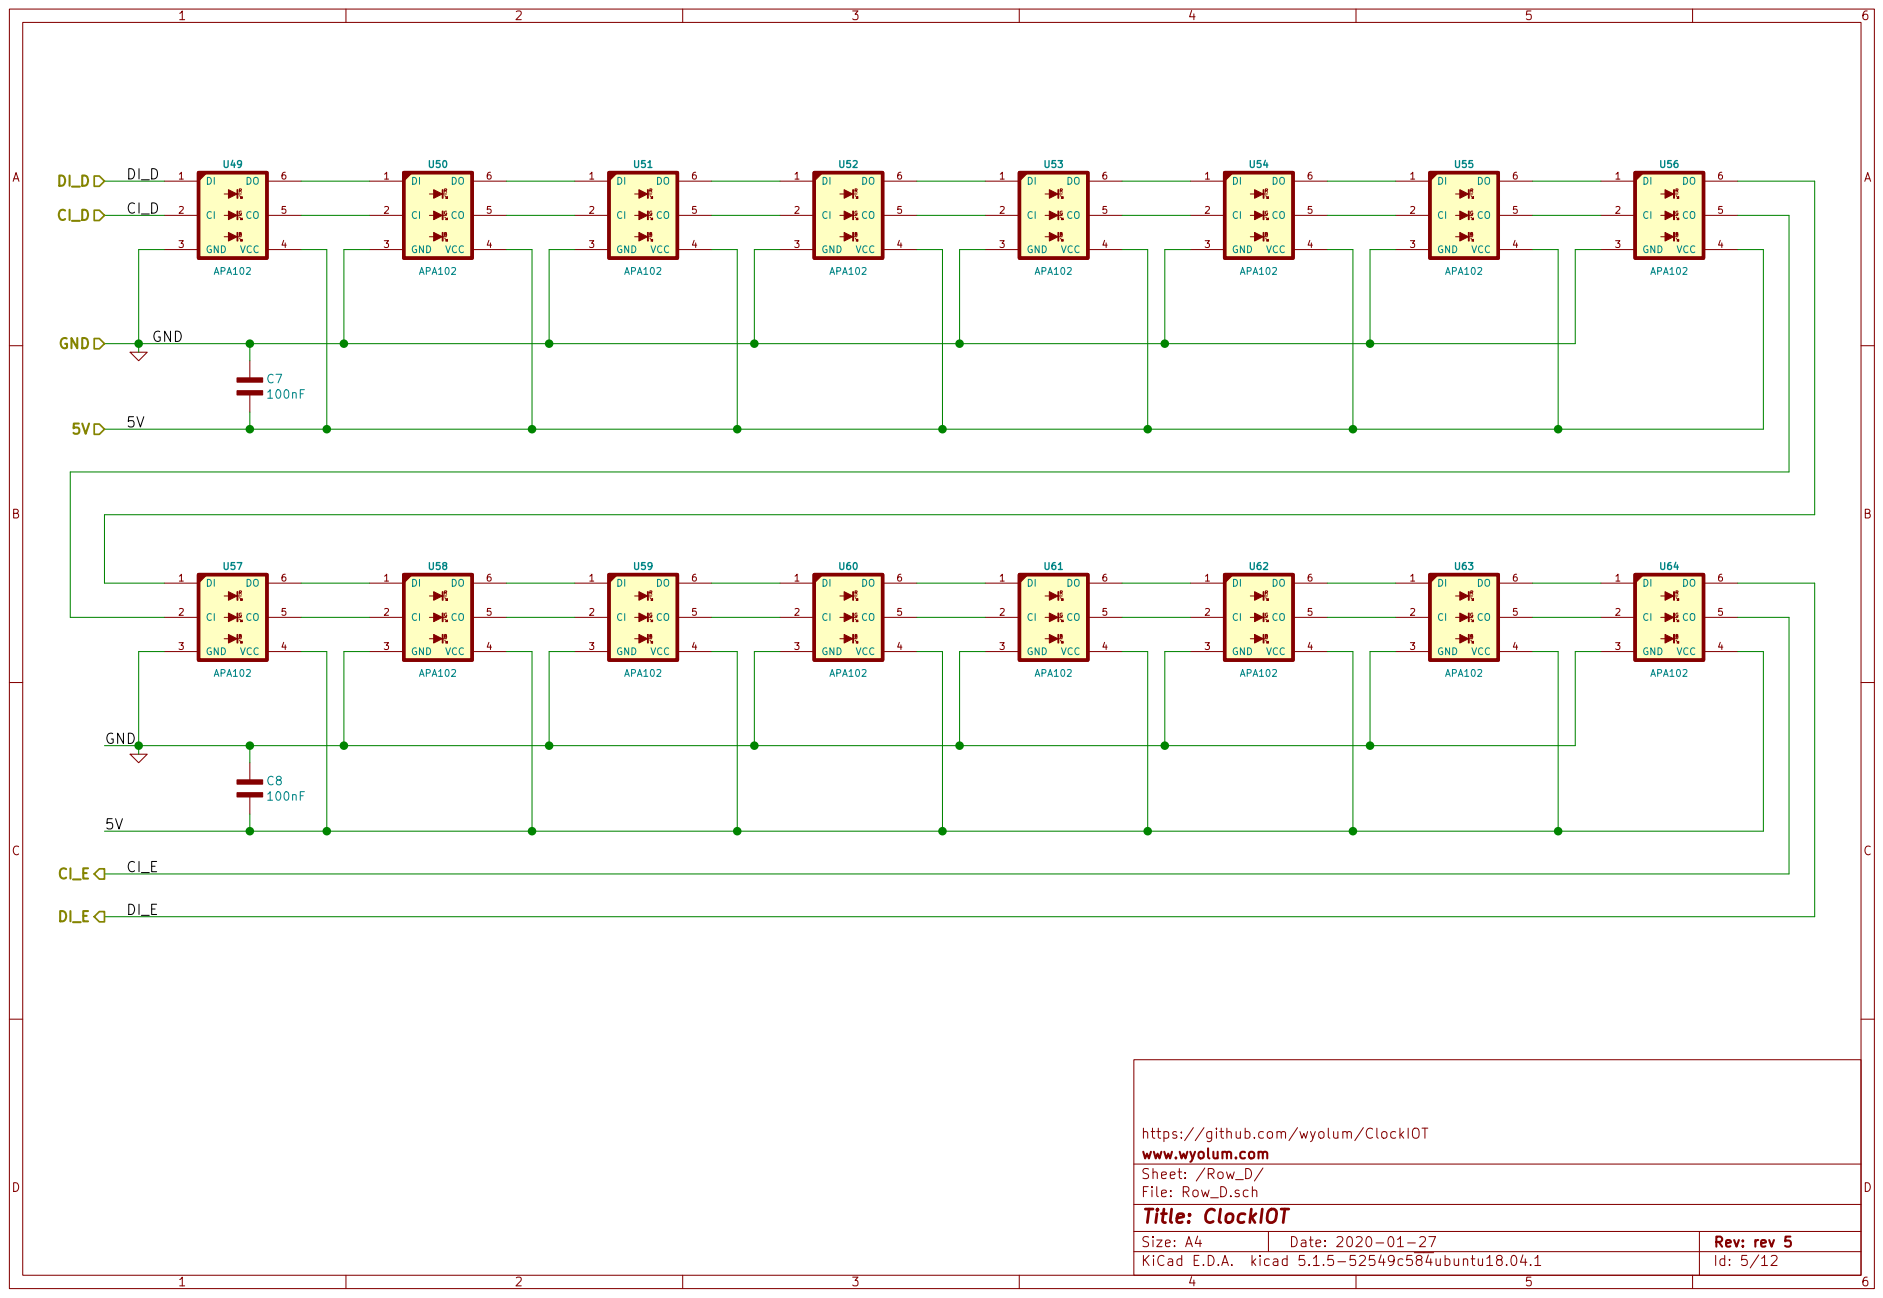
[picture p101: page 5]

https://github.com/wyolum/ClockIOT
www.wyolum.com
Sheet: /Row_D/
File: Row_D.sch
Id: 5/12 Title: ClockIOT

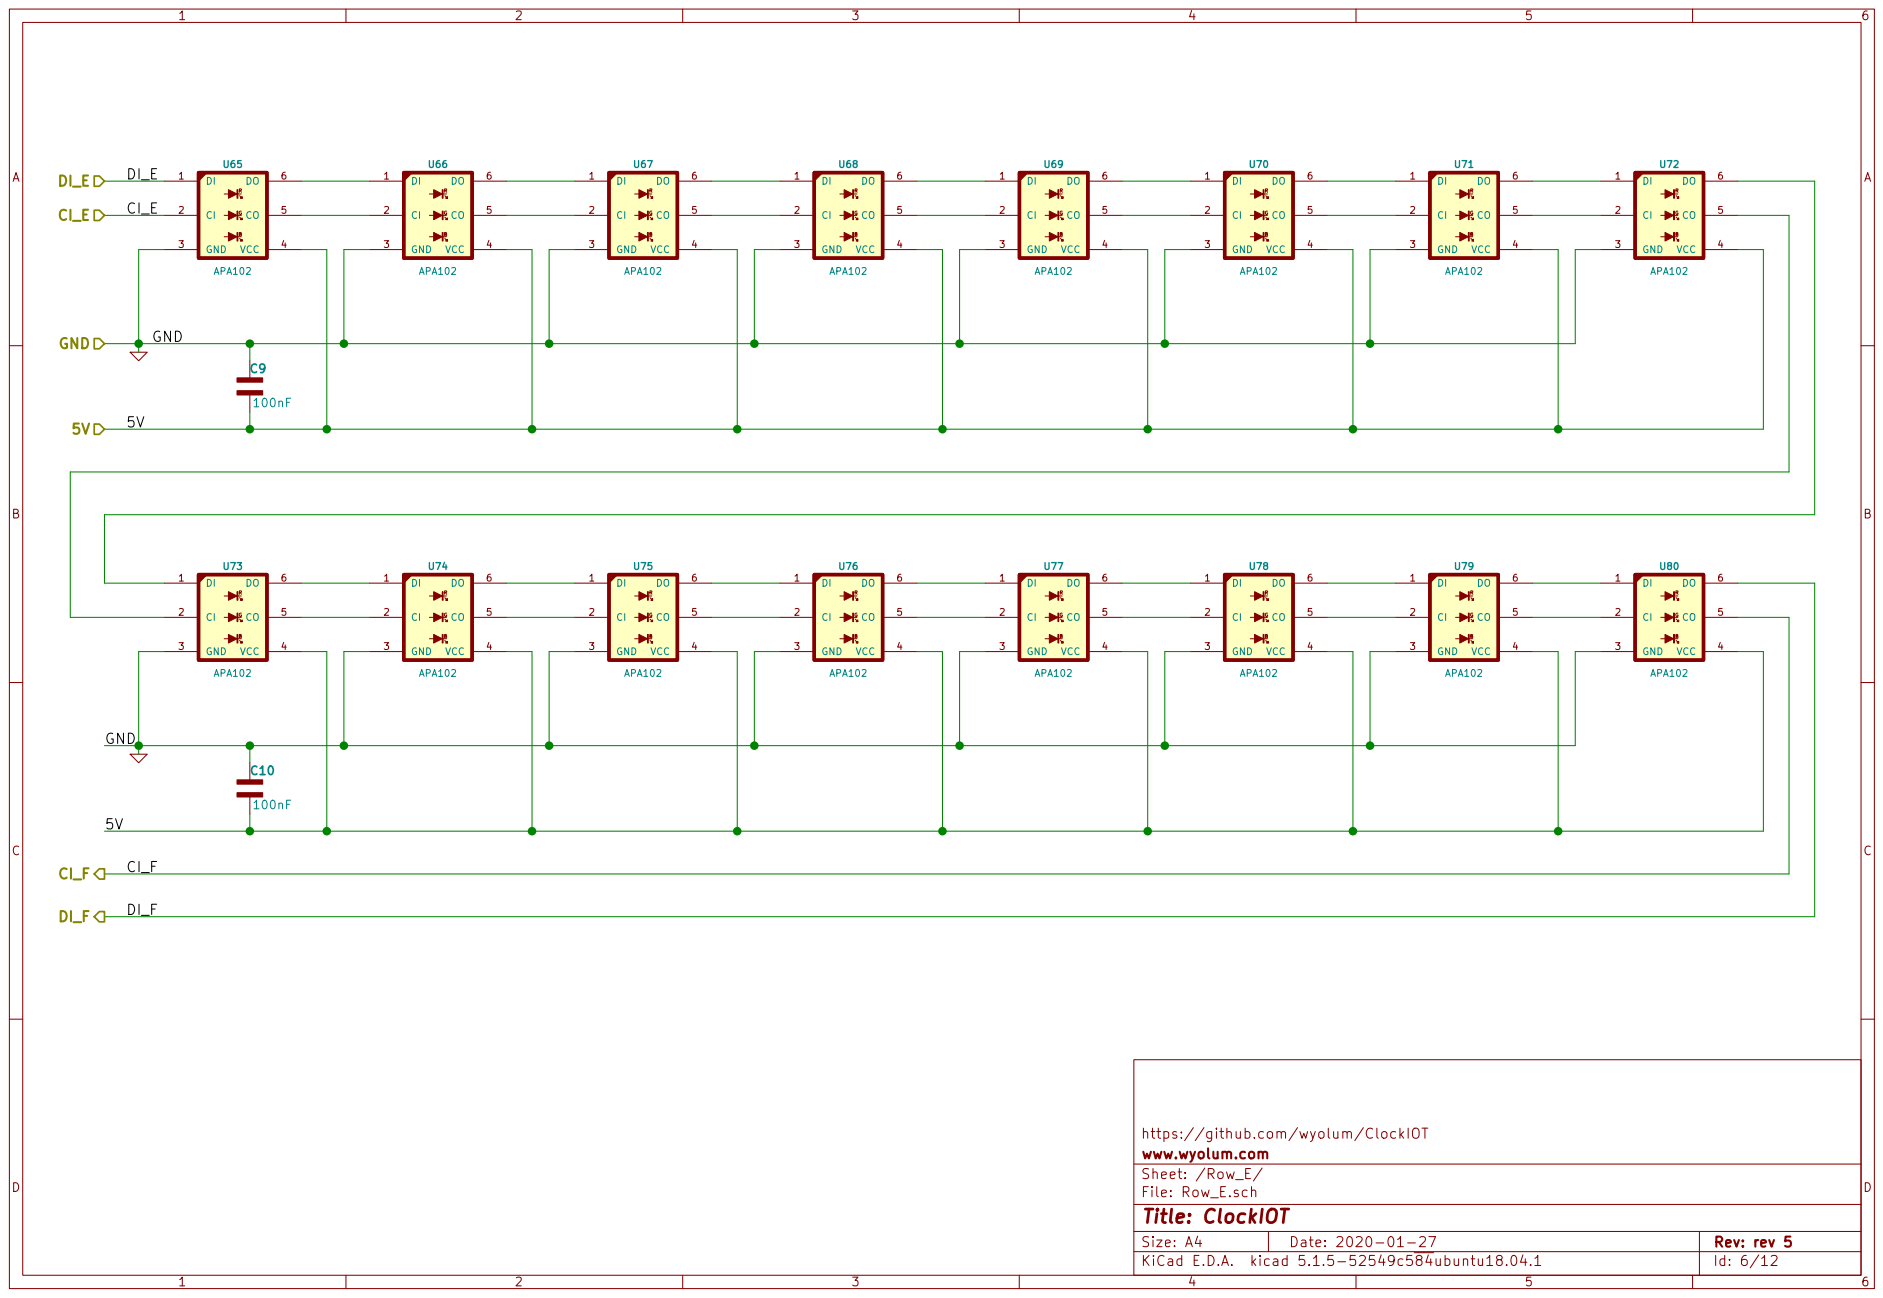
[picture p102: page 6]

https://github.com/wyolum/ClockIOT
www.wyolum.com
Sheet: /Row_E/
File: Row_E.sch
Id: 6/12 Title: ClockIOT

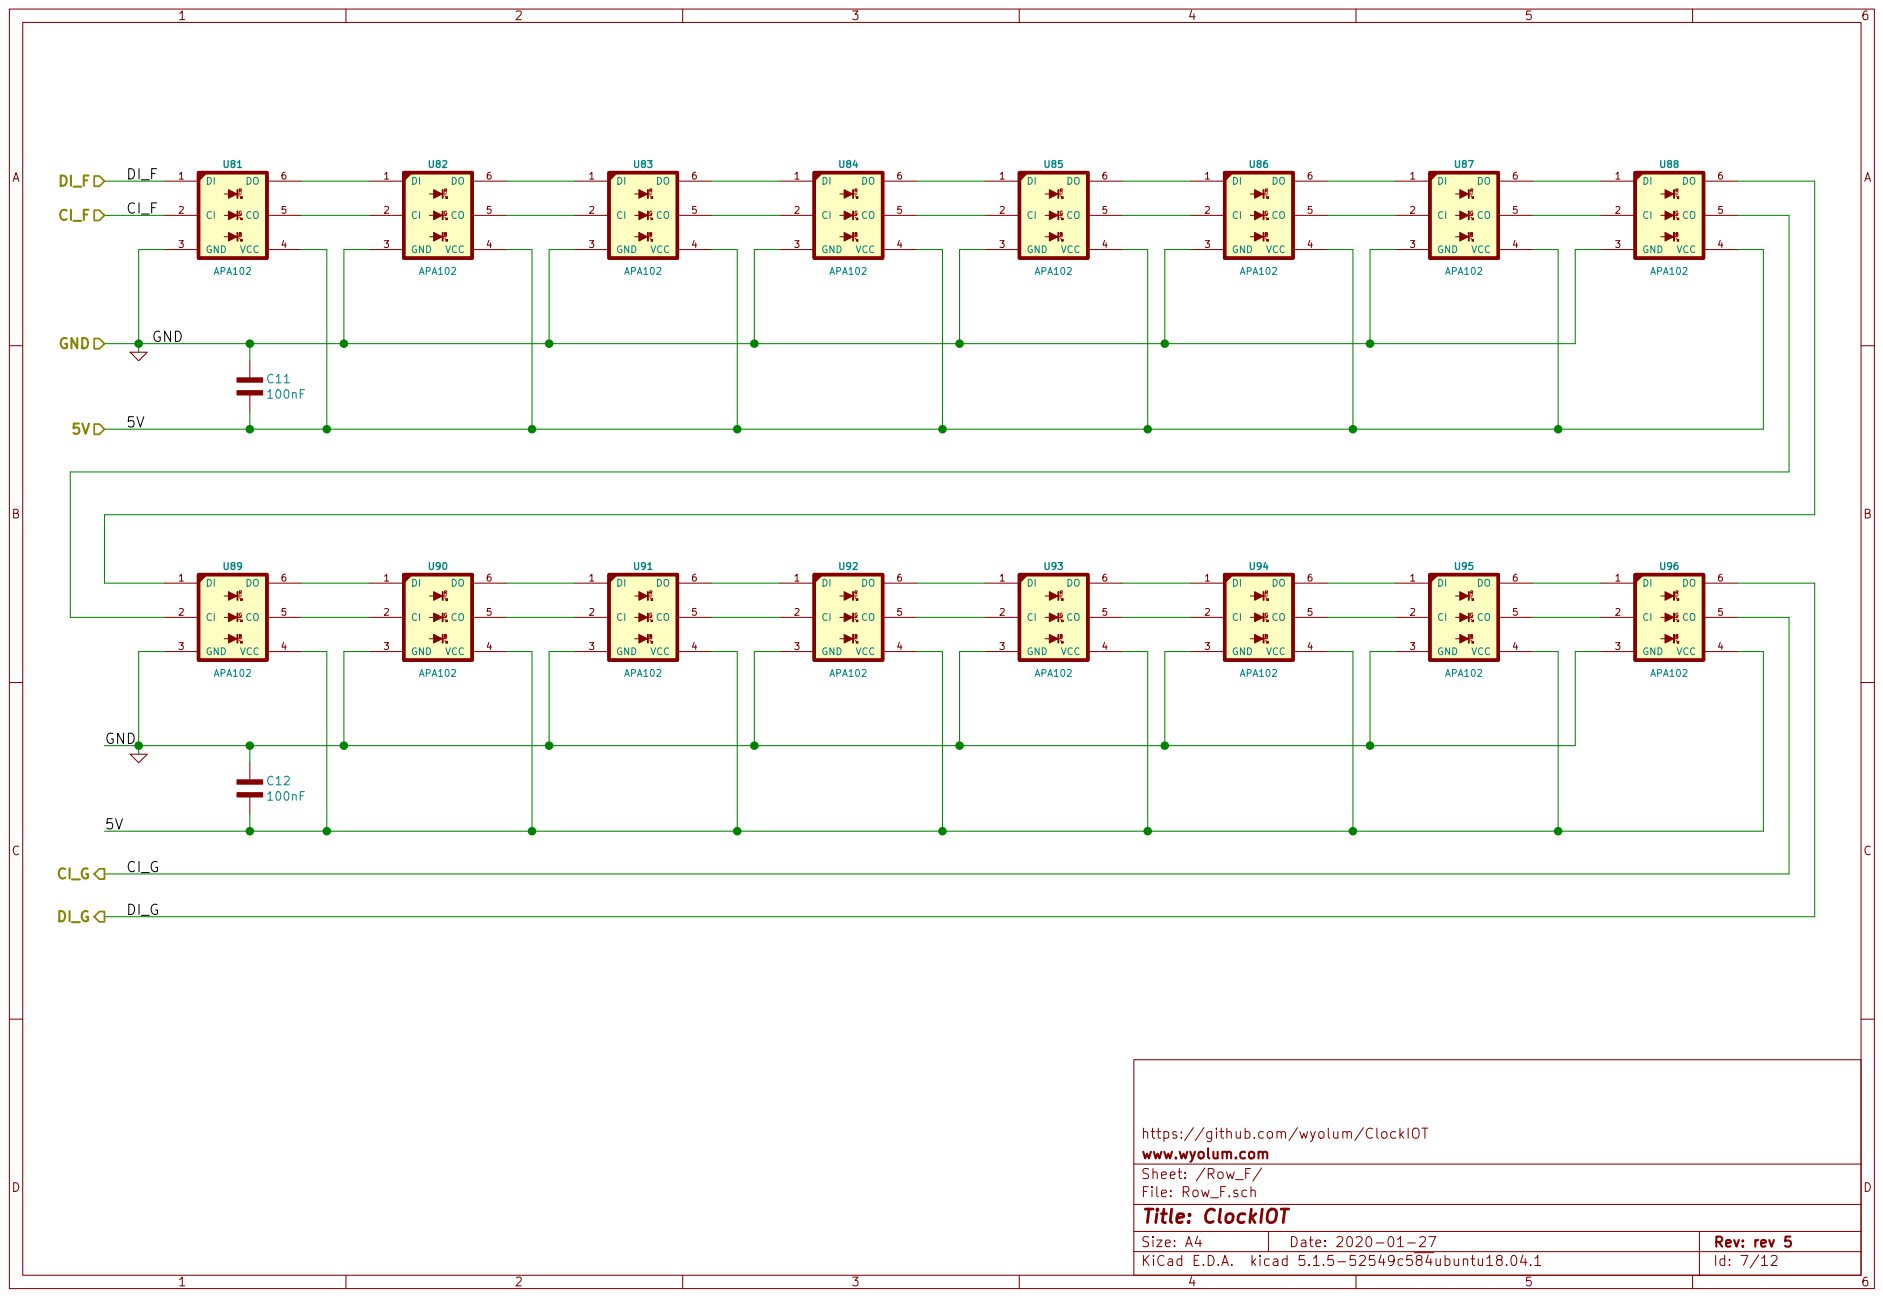
[picture p103: page 7]

https://github.com/wyolum/ClockIOT
www.wyolum.com
Sheet: /Row_F/
File: Row_F.sch
Id: 7/12 Title: ClockIOT

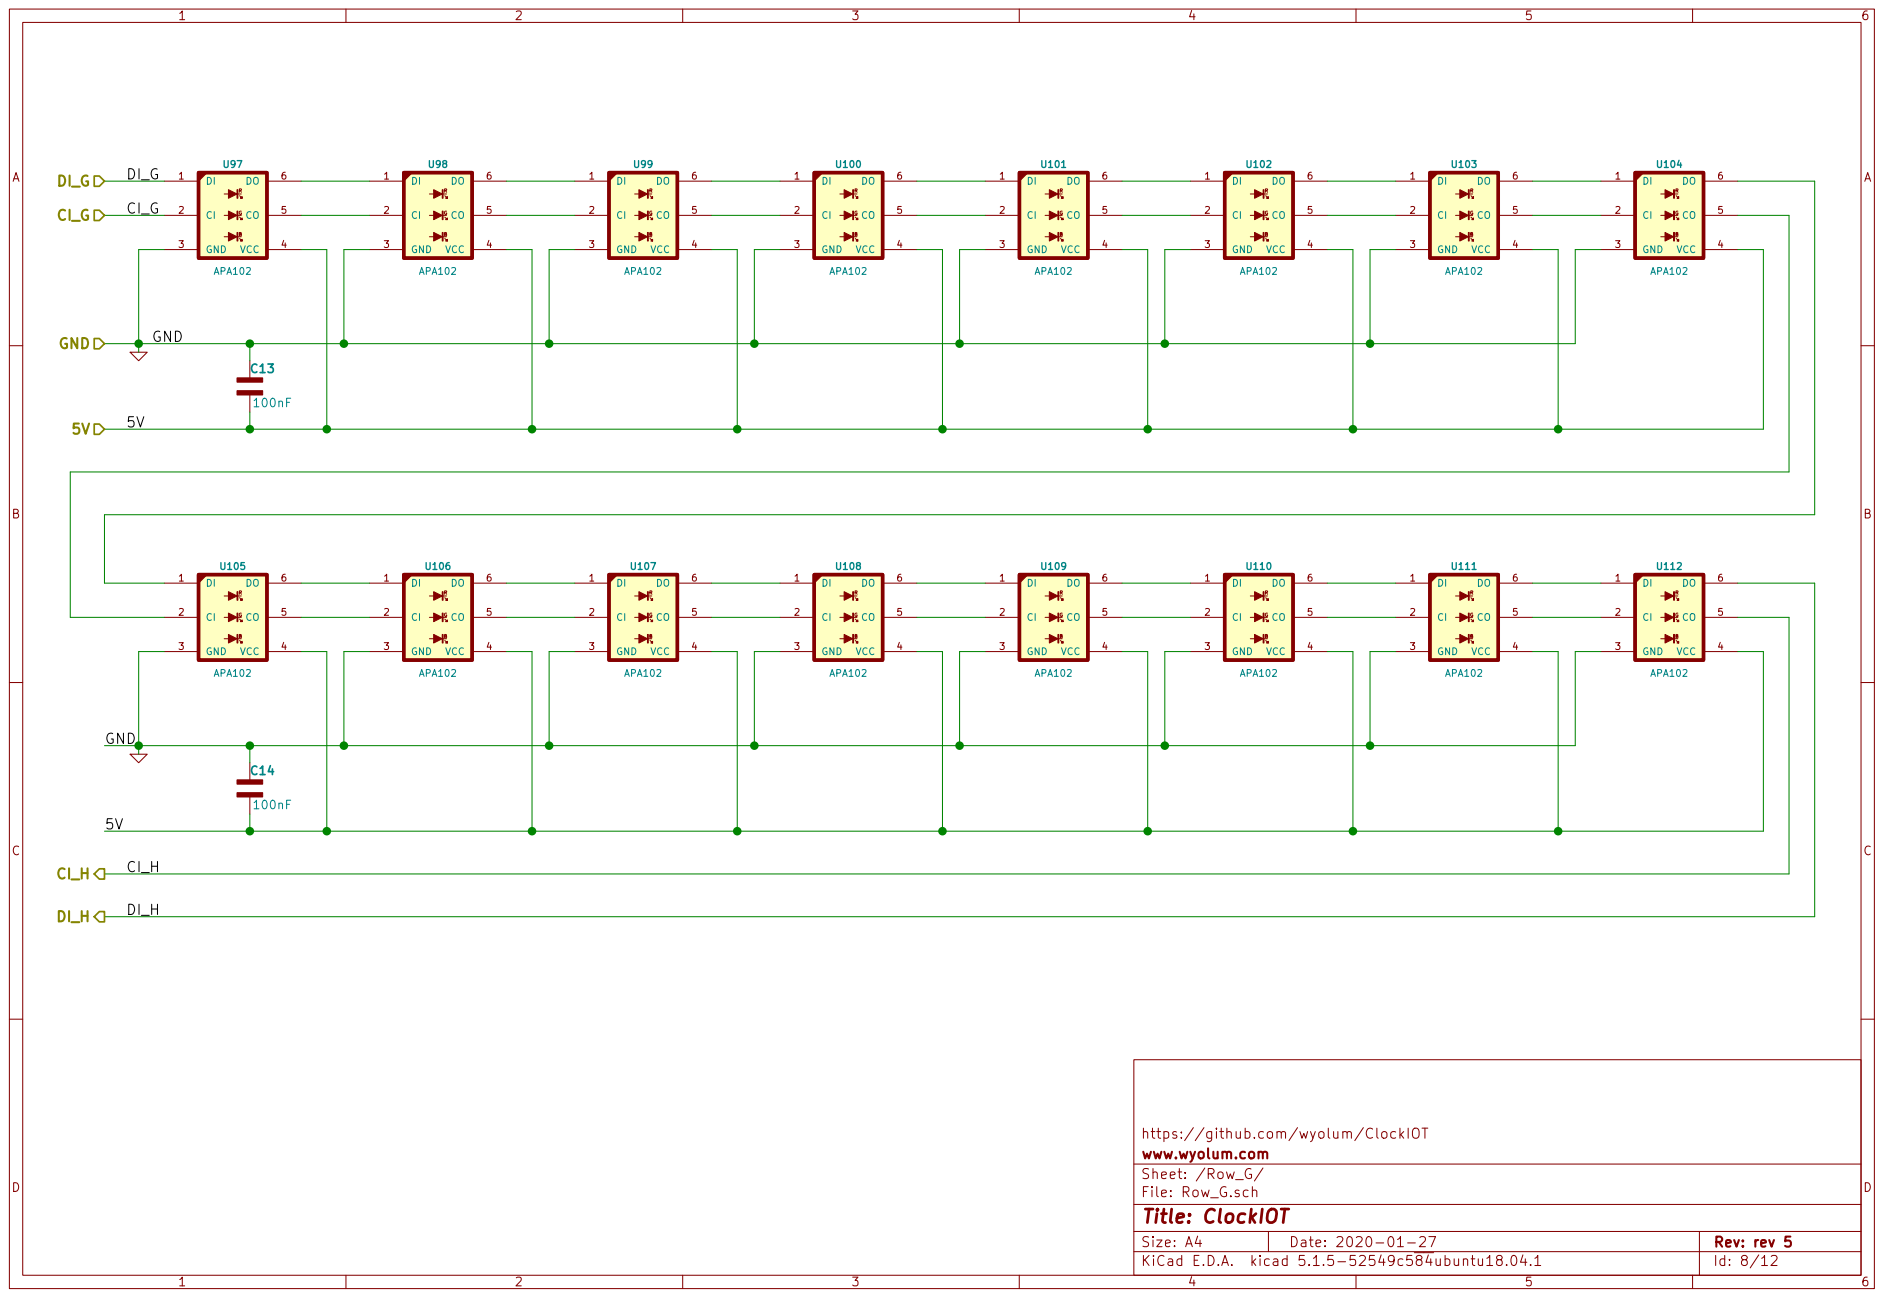
[picture p104: page 8]

https://github.com/wyolum/ClockIOT
www.wyolum.com
Sheet: /Row_G/
File: Row_G.sch
Id: 8/12 Title: ClockIOT

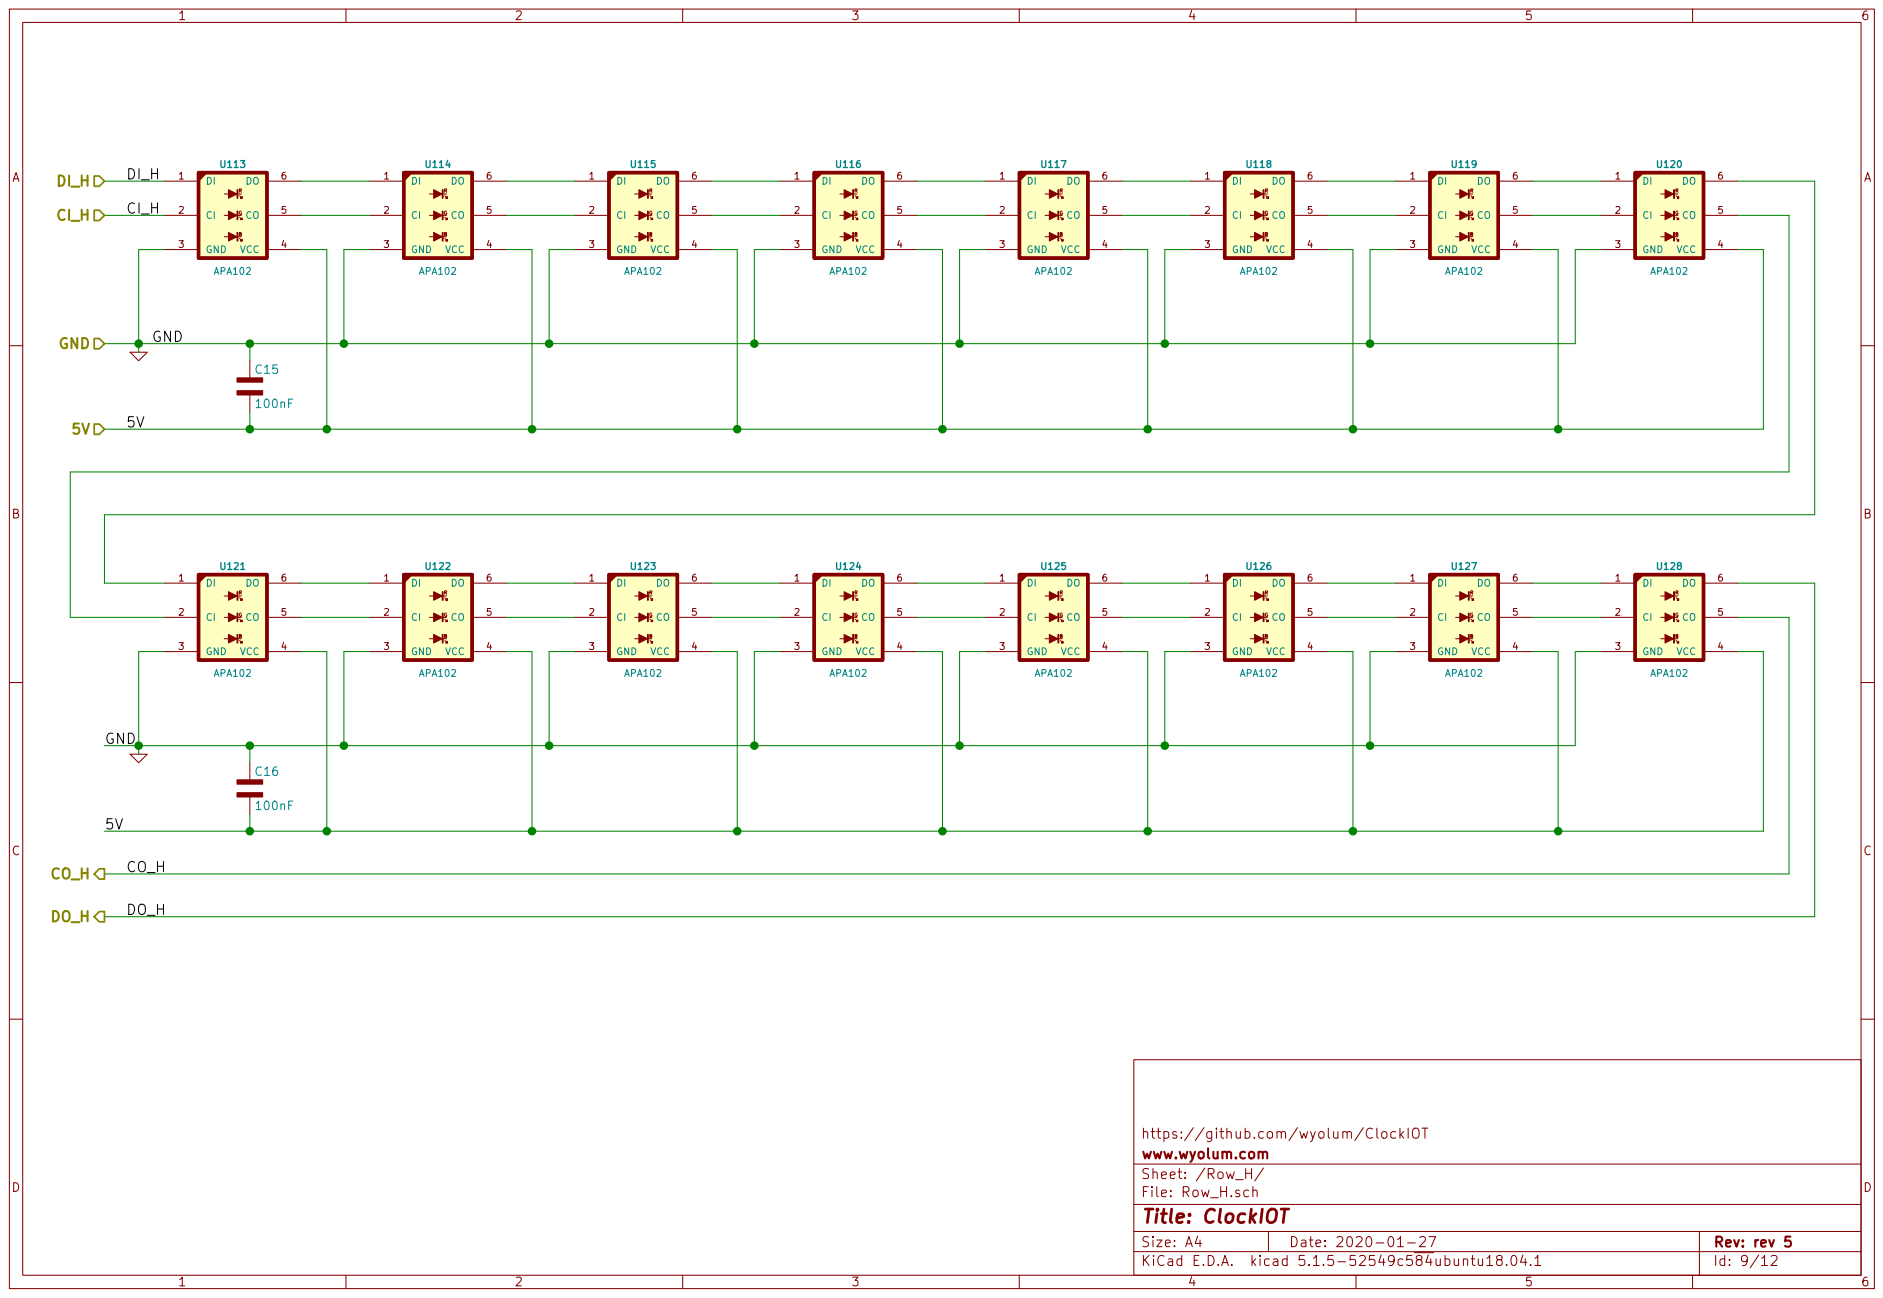
[picture p105: page 9]

https://github.com/wyolum/ClockIOT
www.wyolum.com
Sheet: /Row_H/
File: Row_H.sch
Id: 9/12 Title: ClockIOT

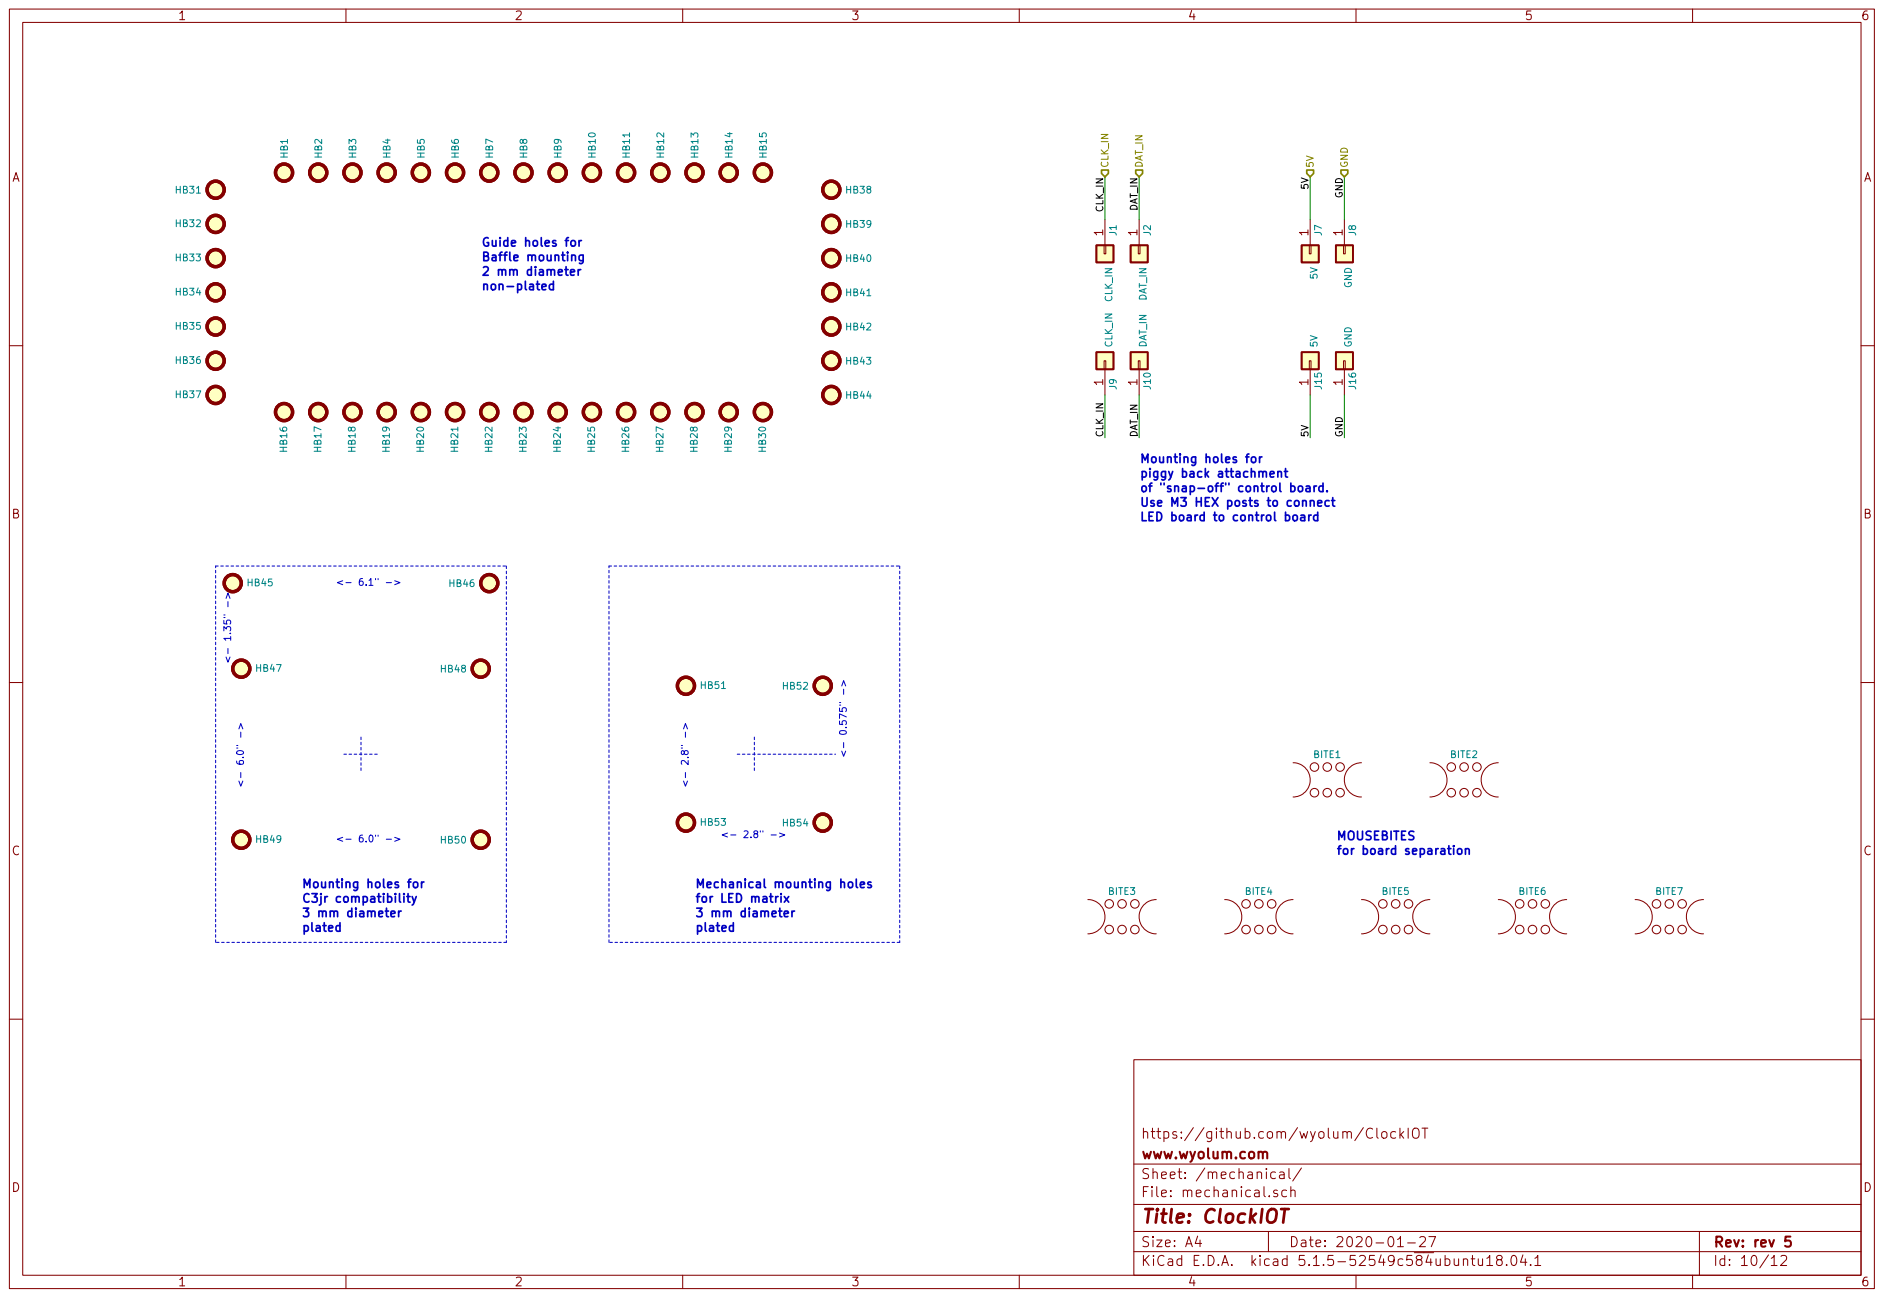
[picture p106: page 10]

for board separation <- 2.8" -> Guide holes for Baffle mounting

2 mm diameter non-plated

Mounting holes for
piggy back attachment
of "snap-off" control board.

Use M3 HEX posts to connect LED board to control board Mechanical mounting holes

https://github.com/wyolum/ClockIOT
File: mechanical.sch Sheet: /mechanical/ www.wyolum.com

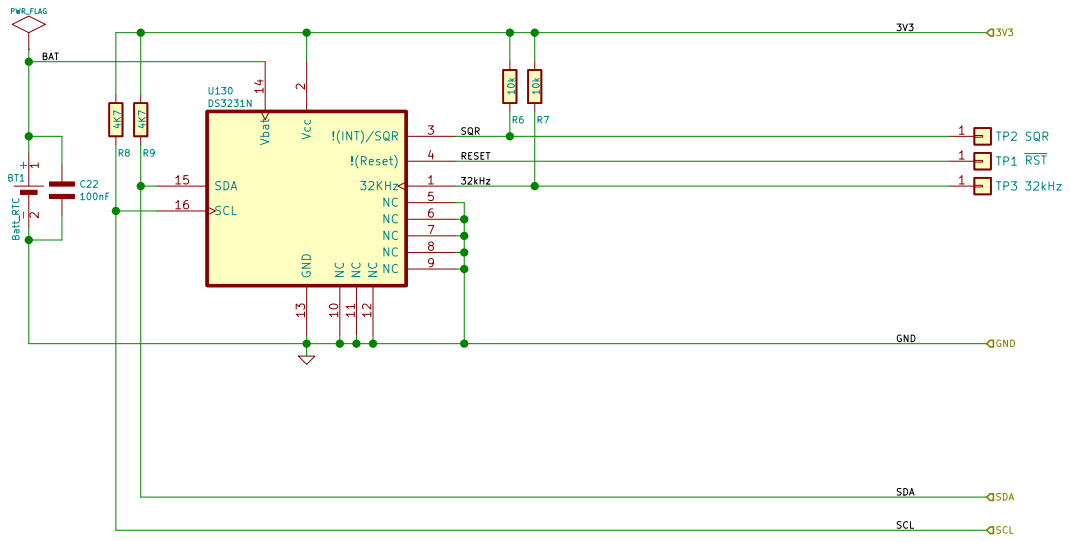
[picture p107: page 11]

https://github.com/wyolum/ClockIOT
www.wyolum.com
Sheet: /rtc_ds3231/
File: rtc_ds3231.sch
Id: 11/12 Title: ClockIOT

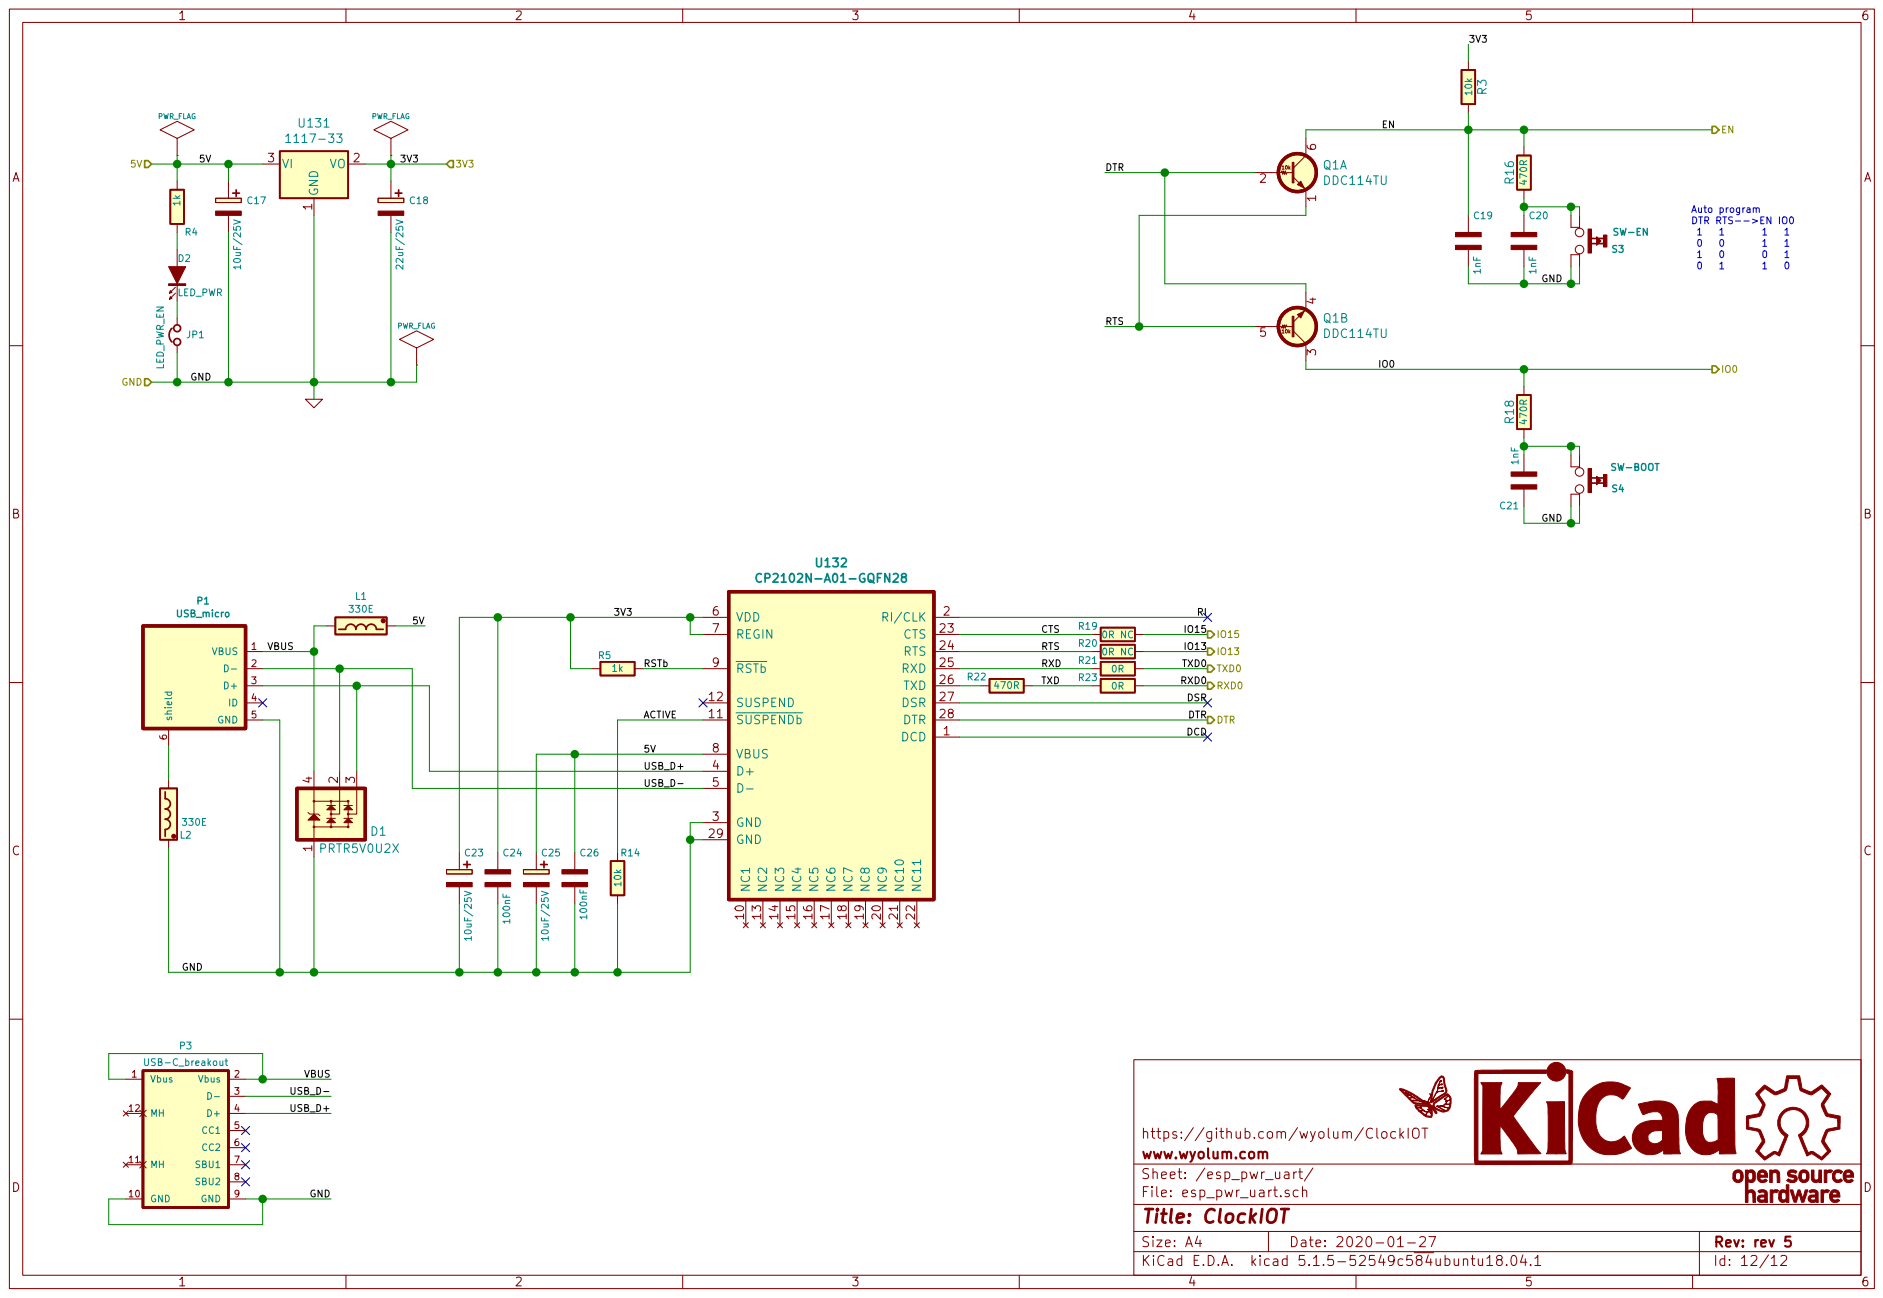
[picture p108: page 12]

6 P1 USB_micro Vbus 1 GND 10 MH 11 MH 12 Vbus 2 D- 3 D+ 4 CC1 5 CC2 6 SBU1 7 SBU2 8 GND 9 P3 USB-C_breakout L2

https://github.com/wyolum/ClockIOT
www.wyolum.com
Sheet: /esp_pwr_uart/
File: esp_pwr_uart.sch
Id: 12/12 Title: ClockIOT
