wyolum/ClockIOT/kicad/ClockIOT_pdf/ClockIOT-B_Cu.pdf

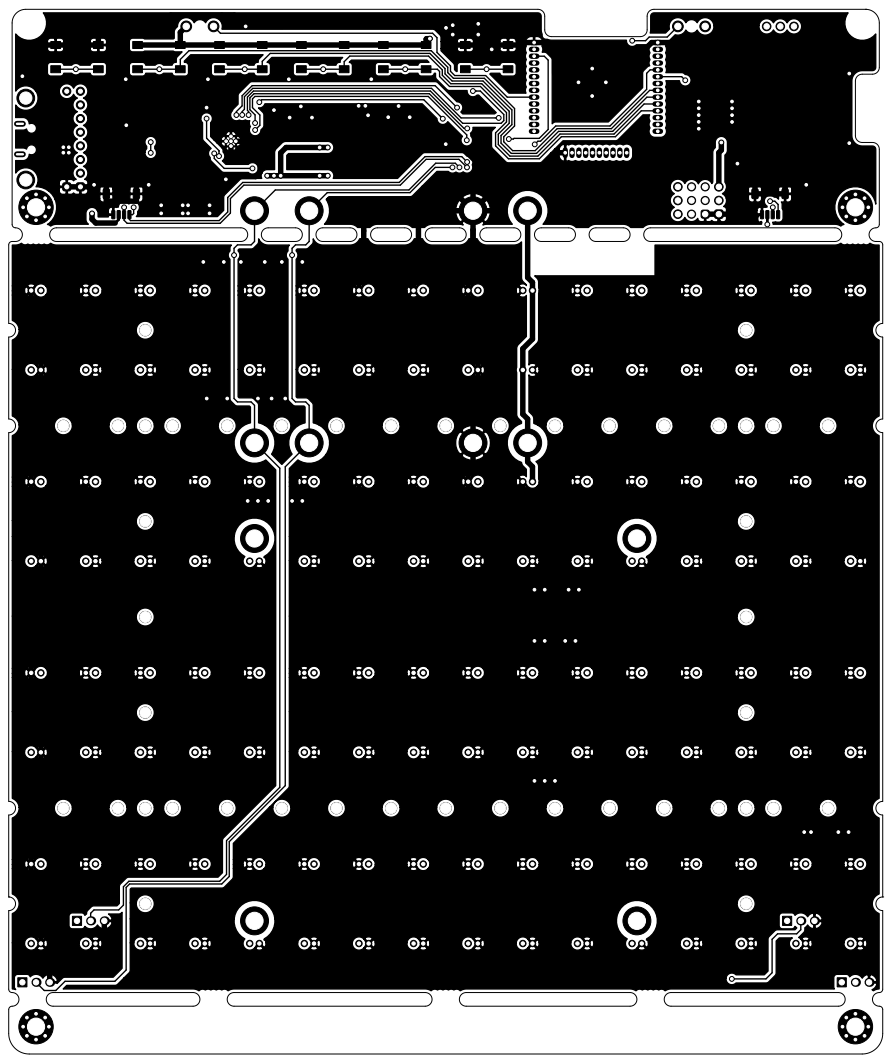
[picture p109: page 1]

https://github.com/wyolum/ClockIOT
File: ClockIOT.kicad_pcb Sheet: www.wyolum.com
