wyolum/ClockIOT/kicad/ClockIOT_pdf/ClockIOT-B_SilkS.pdf

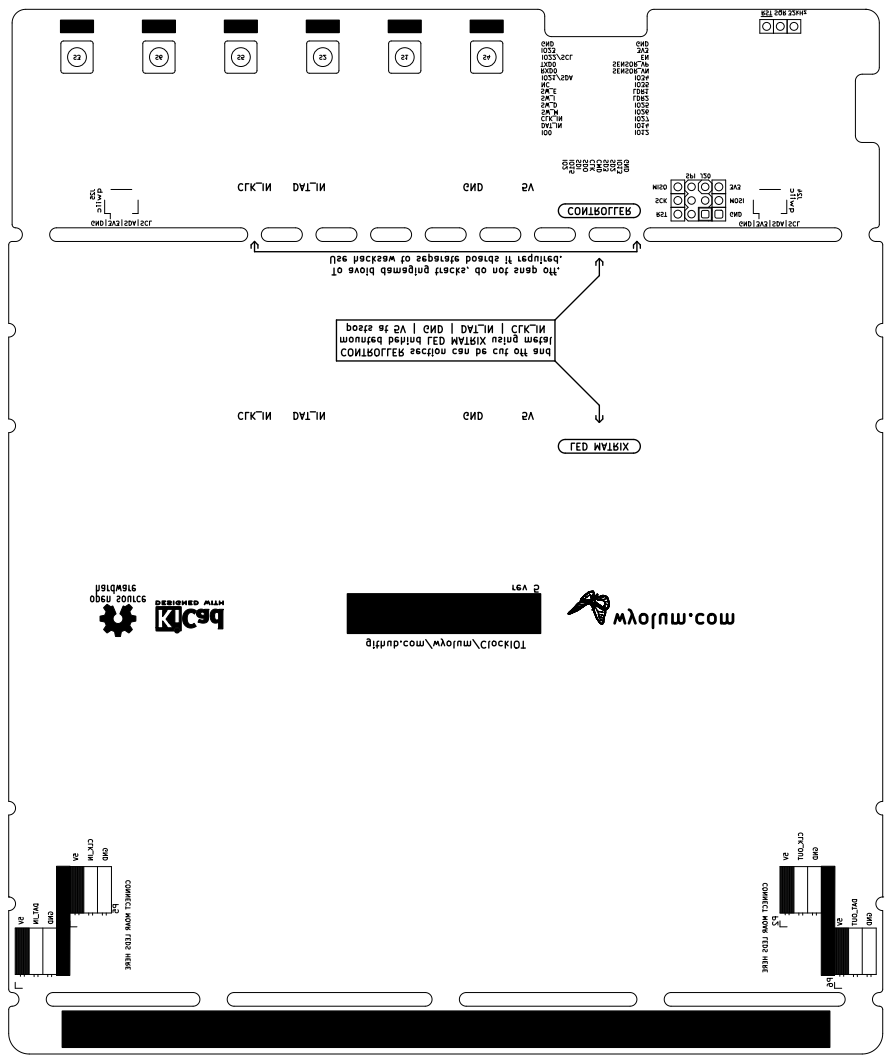
[picture p110: page 1]

Use hacksaw to separate boards if required.
To avoid damaging tracks, do not snap off.

posts at 5V | GND | DAT_IN | CLK_IN
rev 5 CONTROLLER section can be cut off and mounted behind LED MATRIX using metal

github.com/wyolum/ClockIOT

File: ClockIOT.kicad_pcb Sheet: www.wyolum.com
