wyolum/ClockIOT/kicad/ClockIOT_pdf/ClockIOT-Dwgs_User.pdf

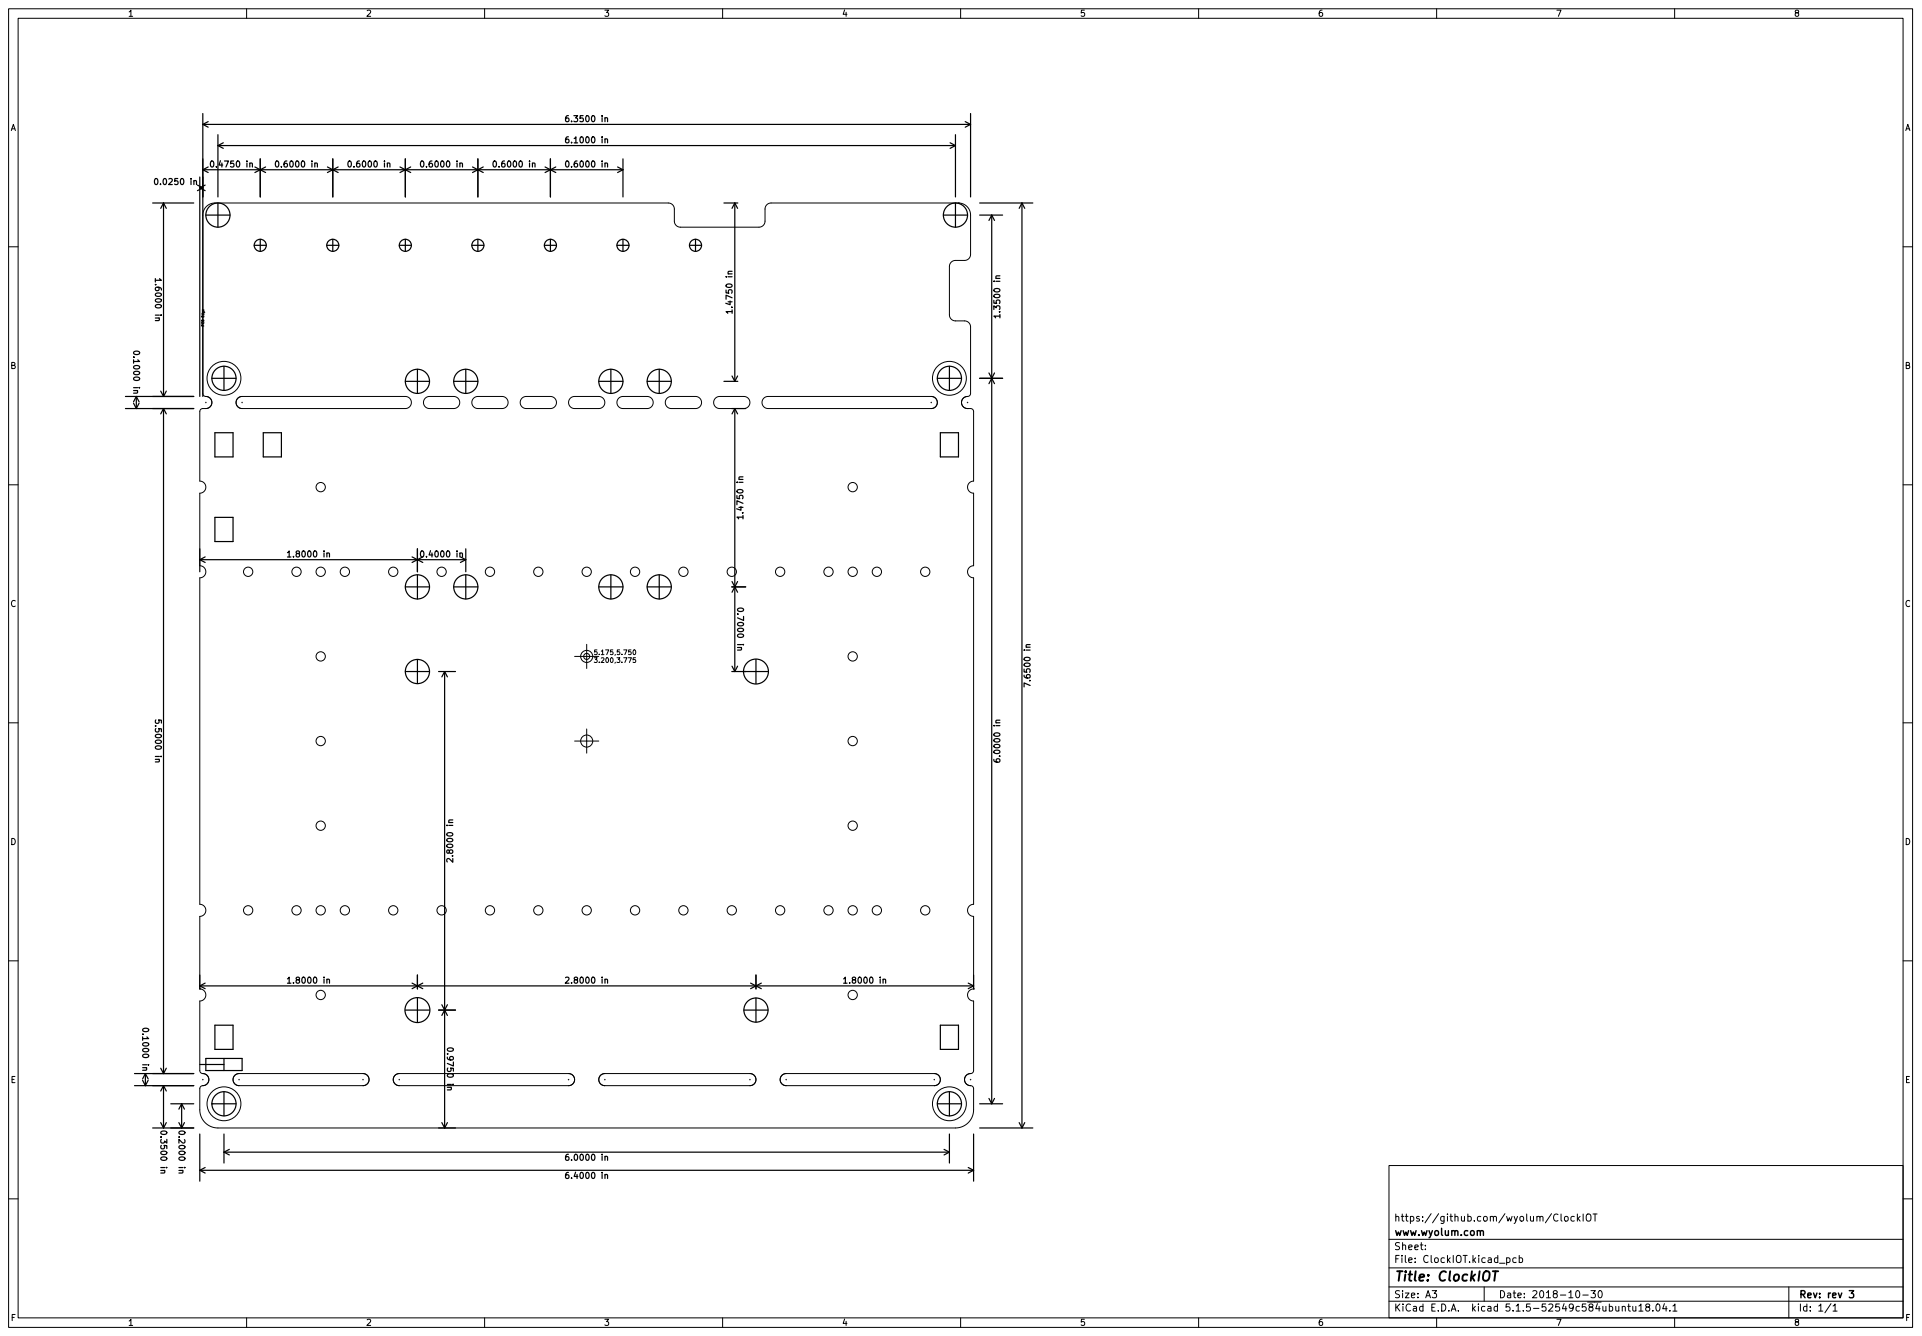
[picture p111: page 1]

https://github.com/wyolum/ClockIOT
File: ClockIOT.kicad_pcb Sheet: www.wyolum.com
