wyolum/ClockIOT/kicad/ClockIOT_pdf/ClockIOT-F_Cu.pdf

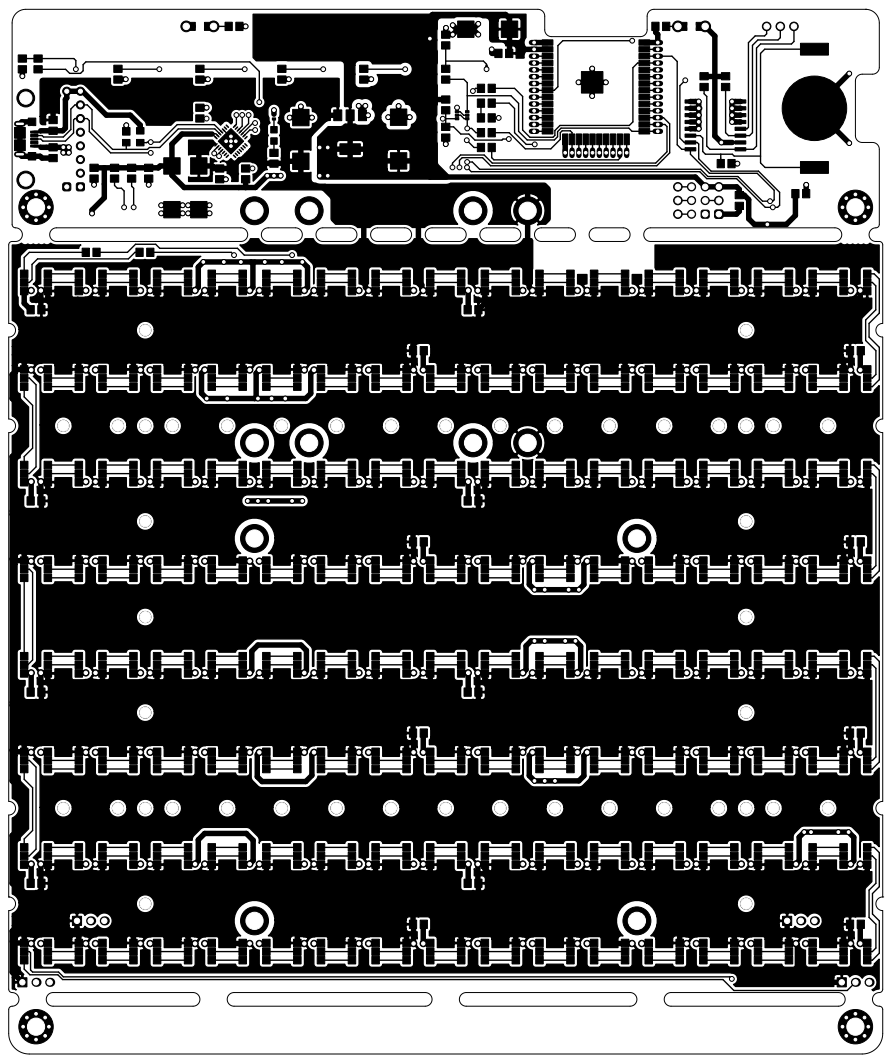
[picture p112: page 1]

https://github.com/wyolum/ClockIOT
File: ClockIOT.kicad_pcb Sheet: www.wyolum.com
