wyolum/ClockIOT/kicad/ClockIOT_pdf/ClockIOT-F_Fab.pdf

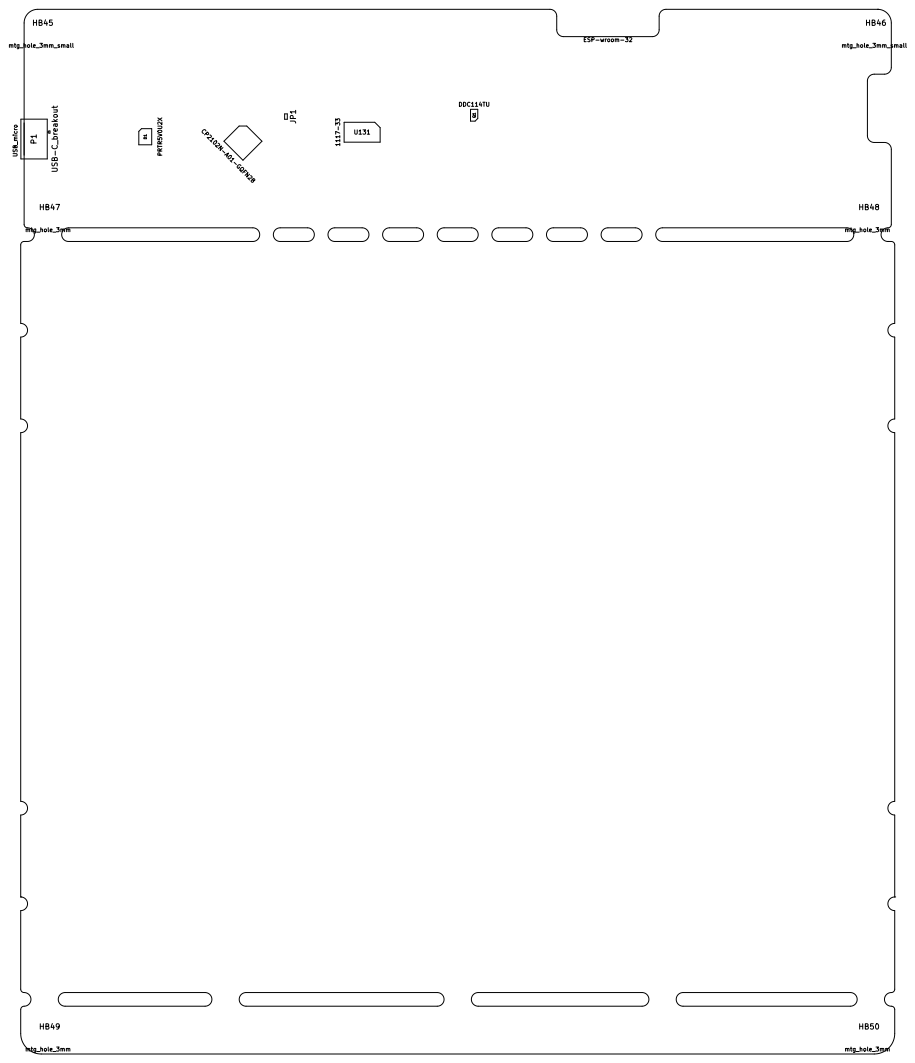
[picture p113: page 1]

File: ClockIOT.kicad_pcb Sheet: www.wyolum.com
