wyolum/ClockIOT/mech_fabricate/ciot_backplate_cord_bottom.pdf

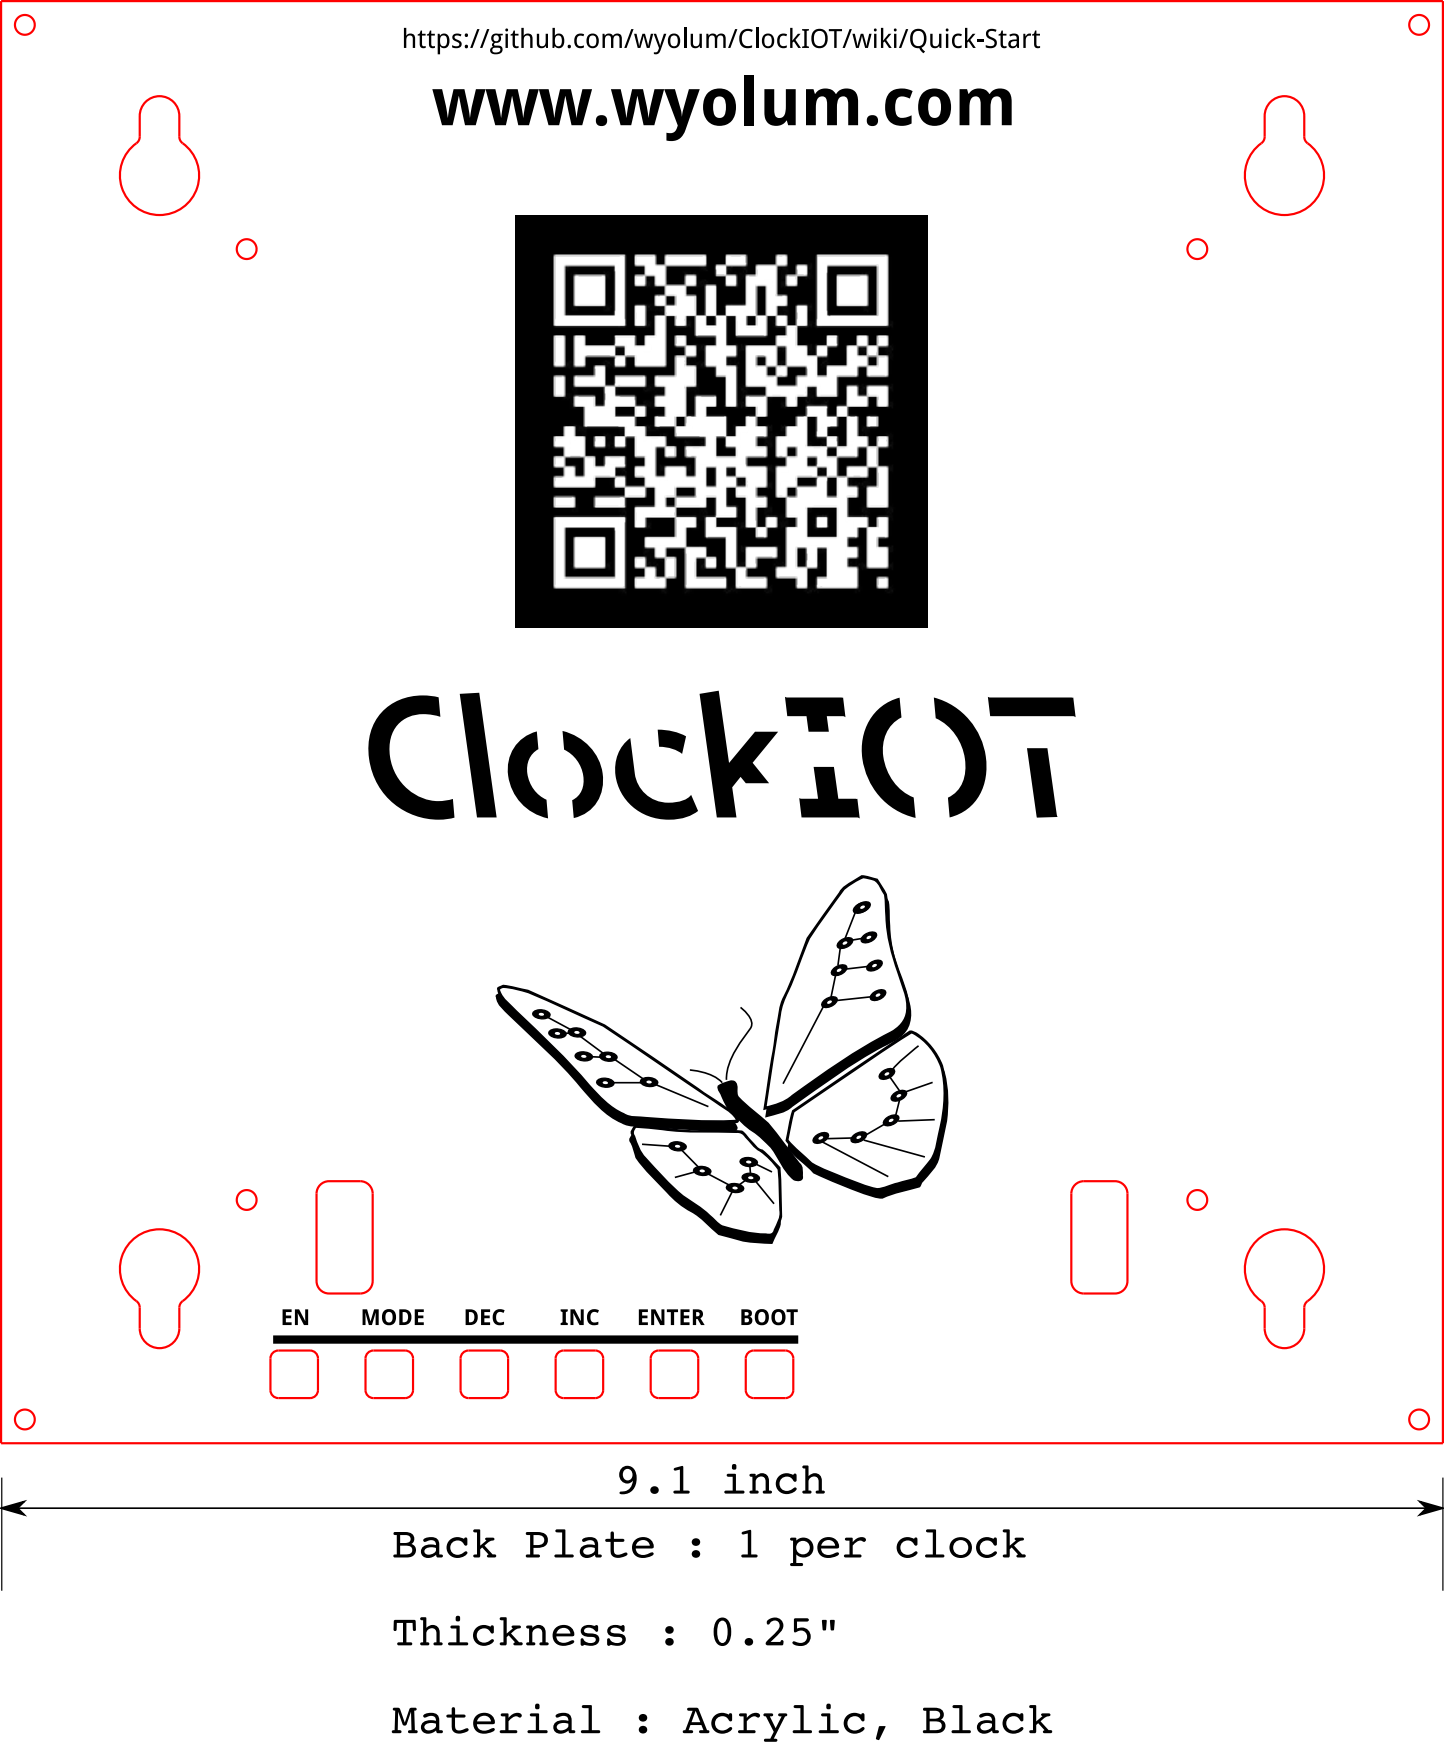
[picture p115: page 1]
