wyolum/ClockIOT/mech_fabricate/ciot_backplate_cord_top.pdf

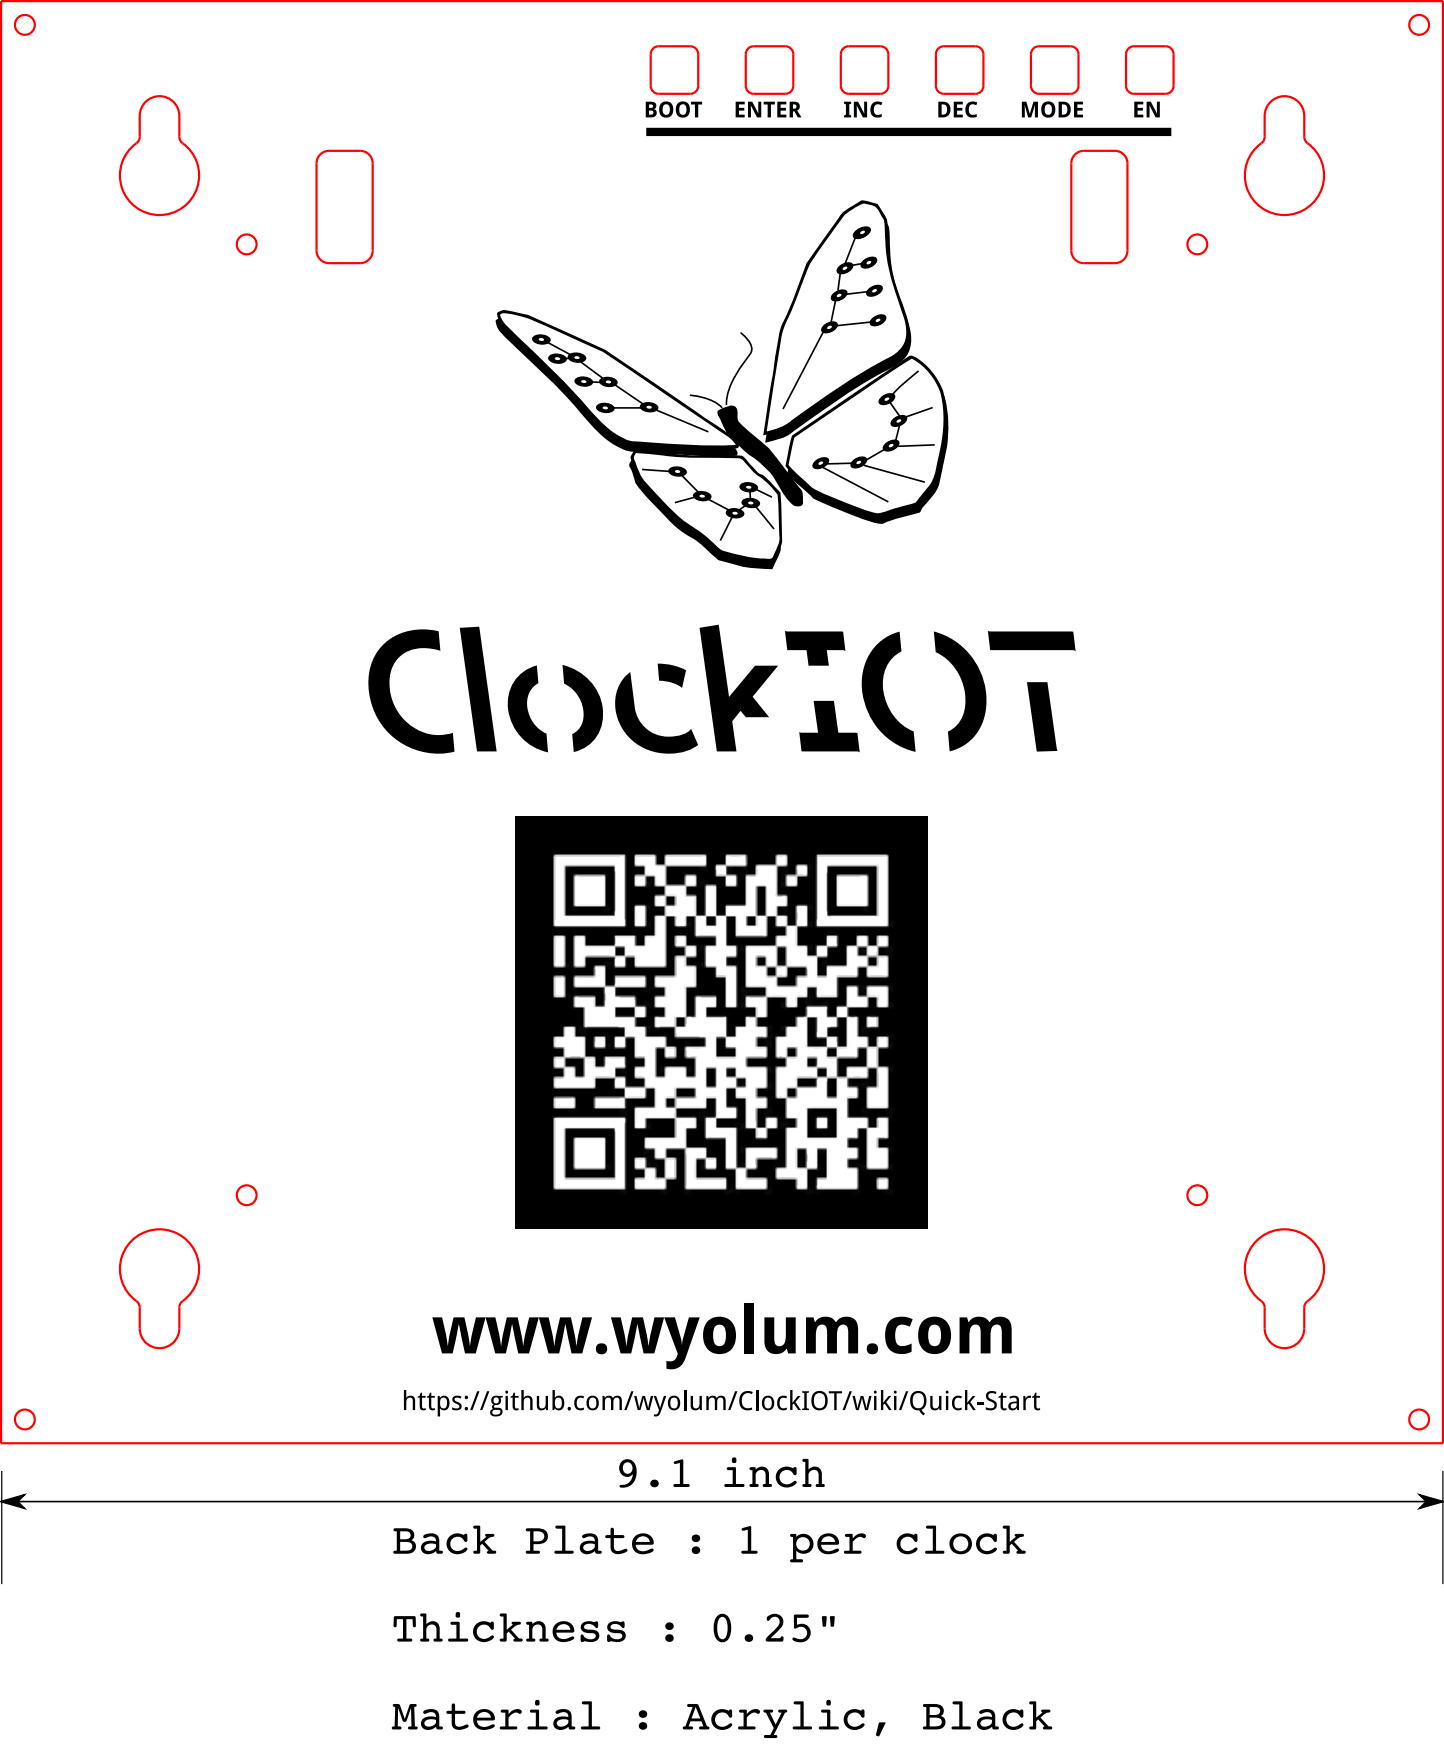
[picture p116: page 1]
