wyolum/ClockIOT/ClockIOT_data/batt_clip_seeed_SKST-2007D.pdf

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

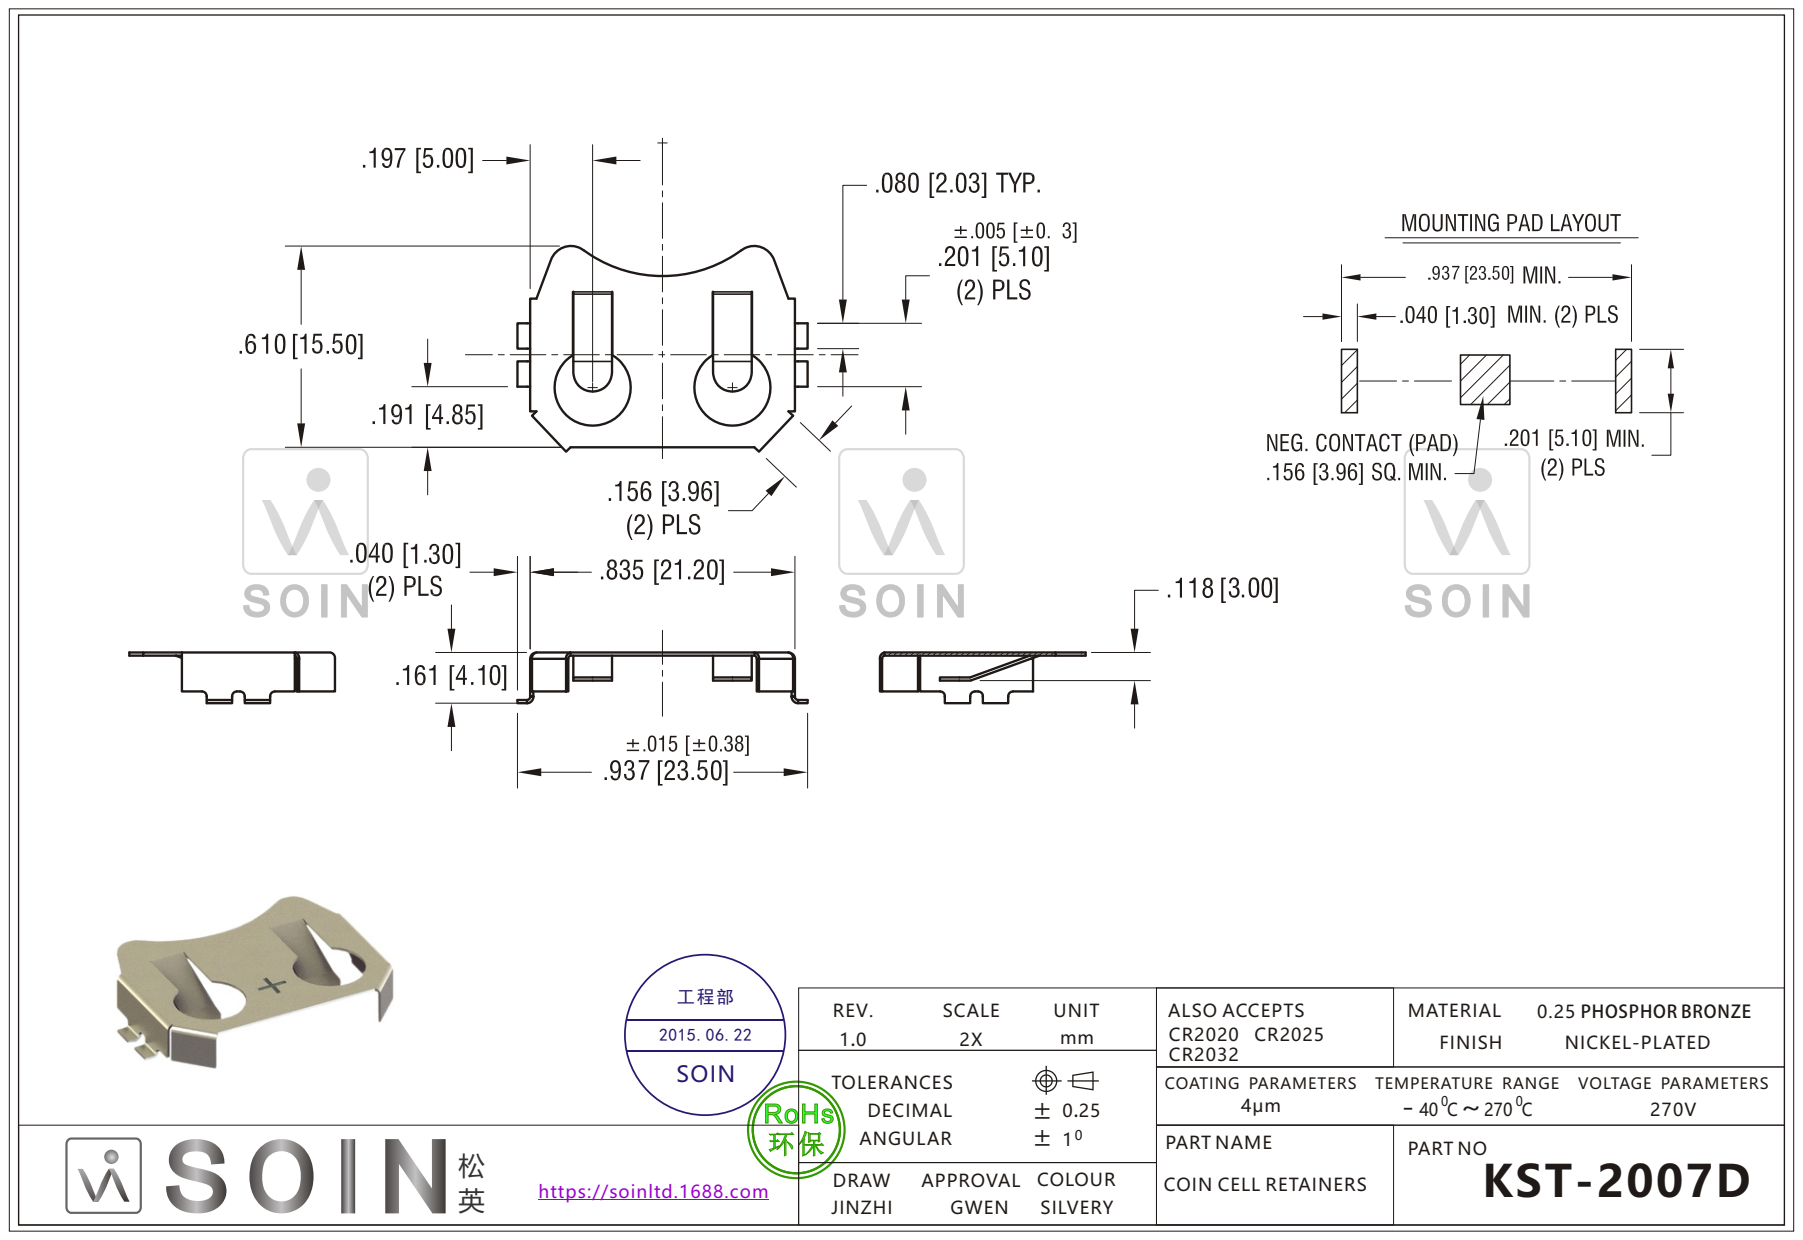
[picture p117: page 1]
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
