wyolum/ClockIOT/ClockIOT_data/usb_micro_seeed_320010561_SMD+DIP Micro USB Type B_5P+2.pdf

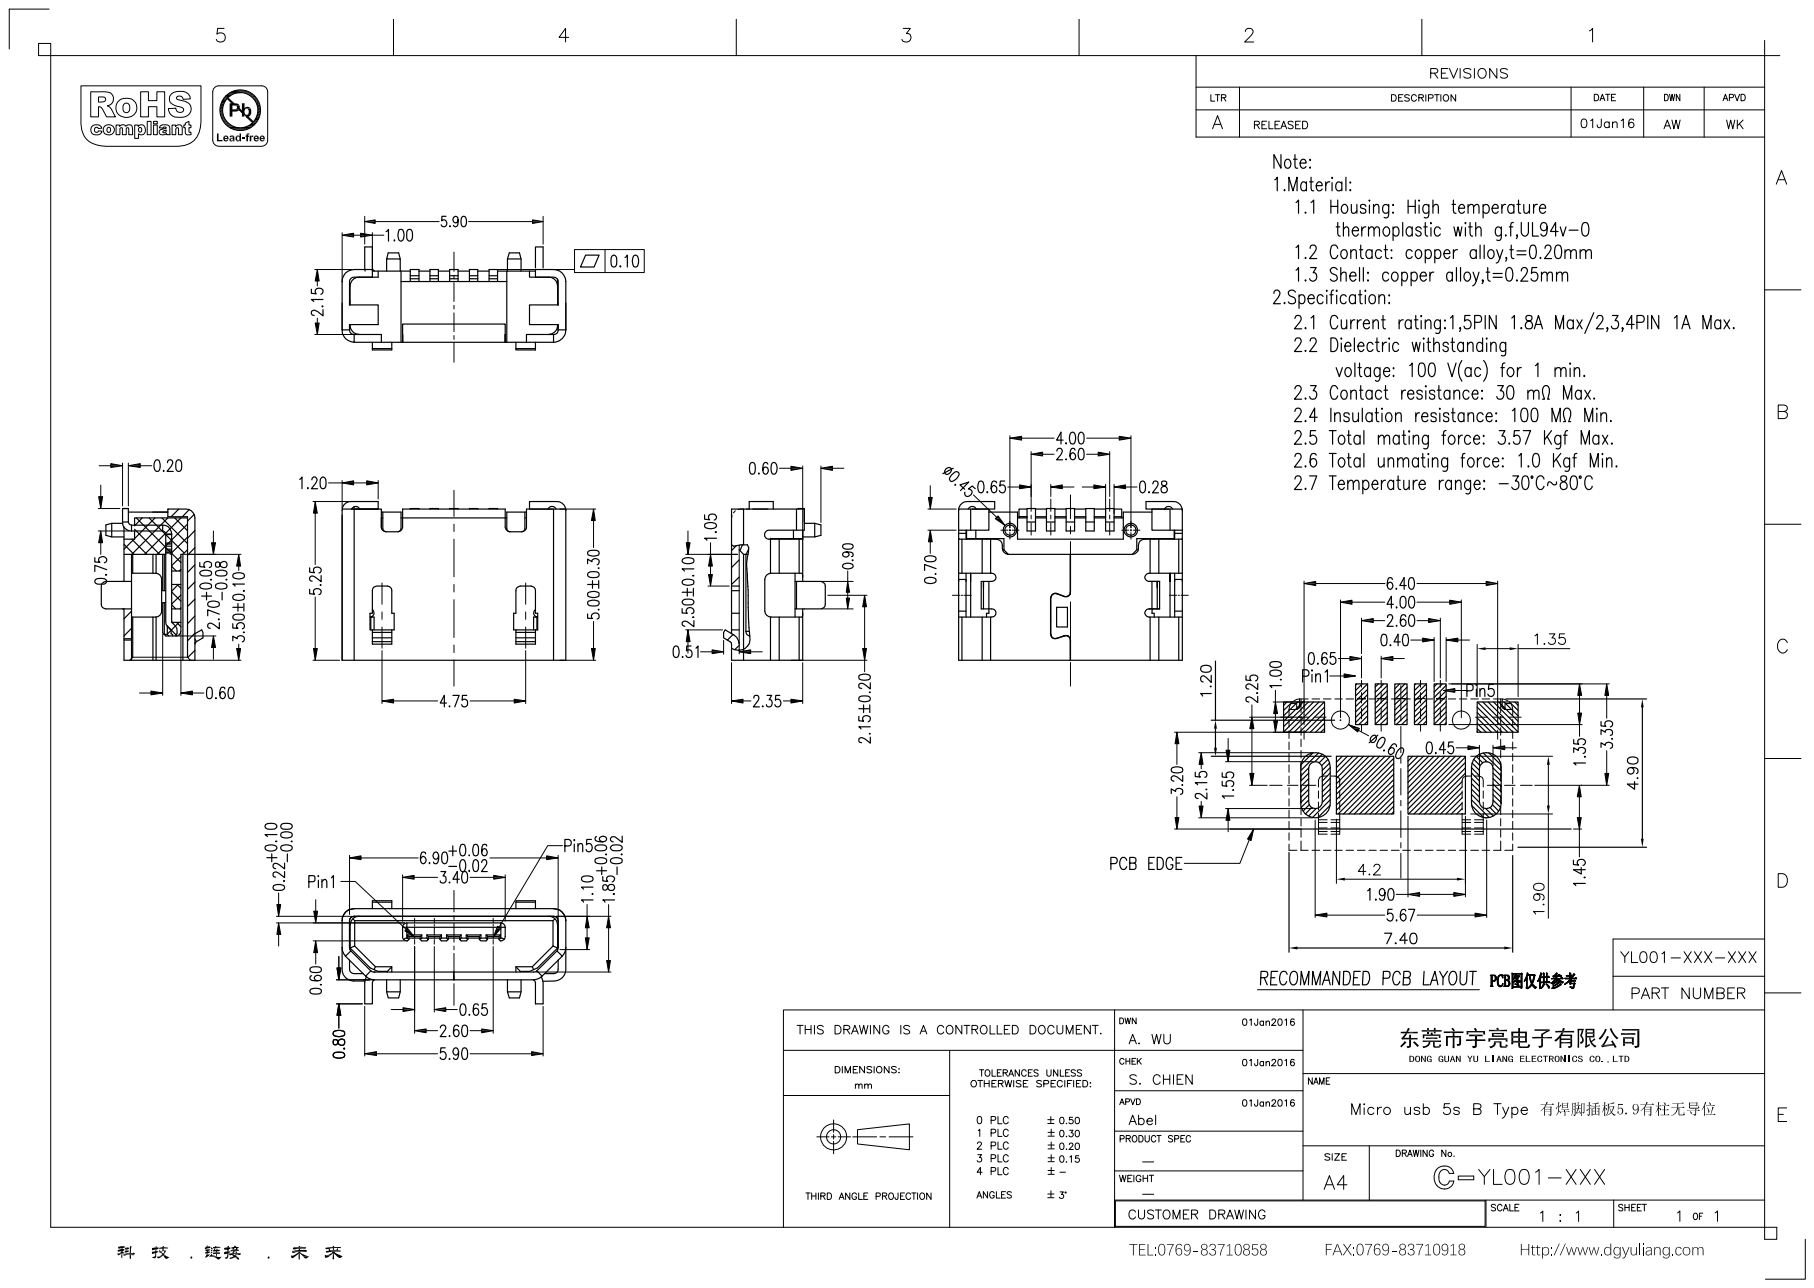
[picture p118: page 1]
