wyolum/ClockIOT/kicad_v3/ClockIOT_pdf/ClockIOT-B.Cu.pdf

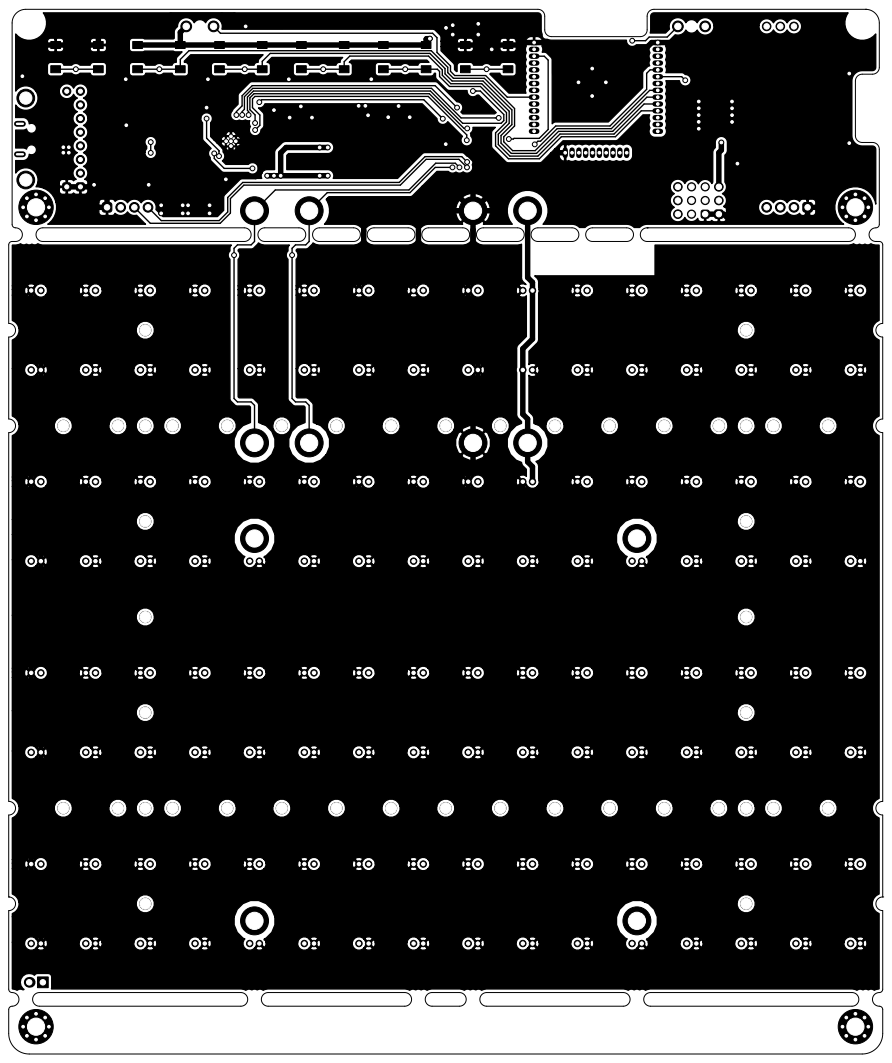
[picture p119: page 1]

https://github.com/wyolum/ClockIOT
File: ClockIOT.kicad_pcb Sheet: www.wyolum.com
