wyolum/ClockIOT/kicad_v3/ClockIOT_pdf/ClockIOT-B.SilkS.pdf

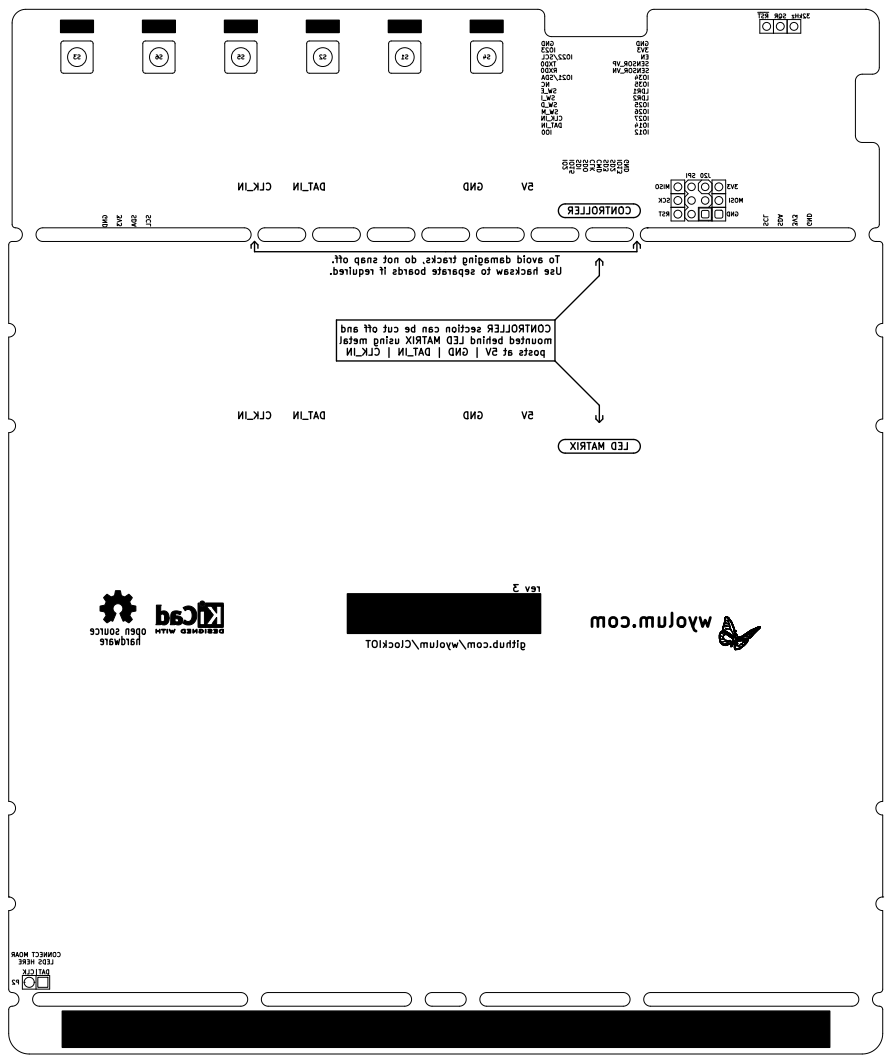
[picture p120: page 1]

SCK MOSI MISO 3V3 SQR 32kHz

SPI J20 RST RST GND

NC SCL SDA 3V3 GNDGND 3V3 SDA SCL

IO12 IO2 SDI SDO CLK CMD SD3 SD2

To avoid damaging tracks, do not snap off.

Use hacksaw to separate boards if required.

rev 3 CONTROLLER section can be cut off and mounted behind LED MATRIX using metal

github.com/wyolum/ClockIOT

LEDS HERE DAT|CLK

https://github.com/wyolum/ClockIOT
File: ClockIOT.kicad_pcb Sheet: www.wyolum.com
