wyolum/ClockIOT/kicad_v3/ClockIOT_pdf/ClockIOT-Dwgs.User.pdf

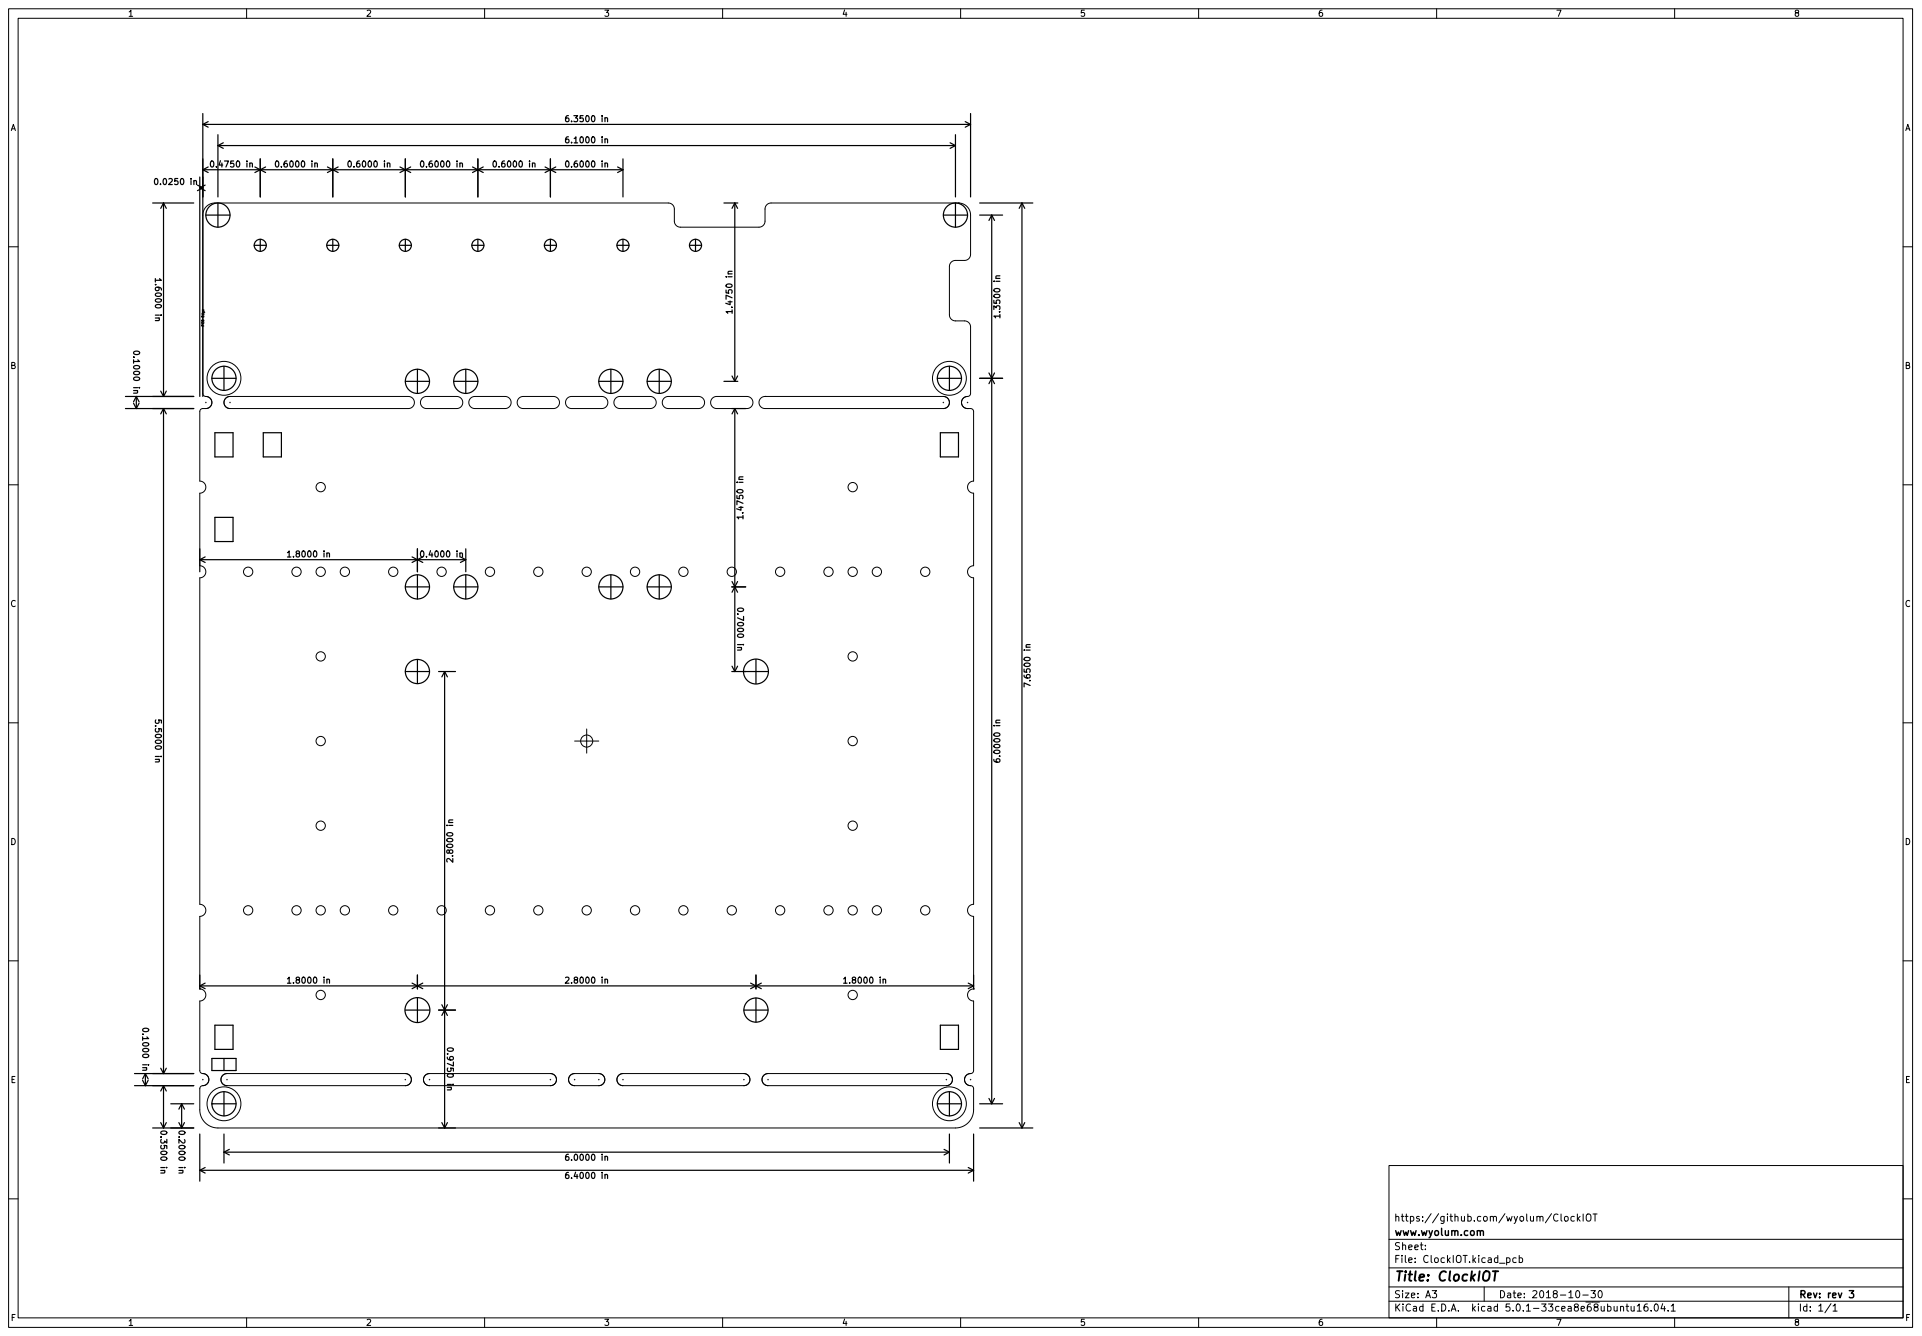
[picture p121: page 1]

https://github.com/wyolum/ClockIOT 0.7000 in

File: ClockIOT.kicad_pcb Sheet: www.wyolum.com
