wyolum/ClockIOT/kicad_v3/ClockIOT_pdf/ClockIOT-F.Cu.pdf

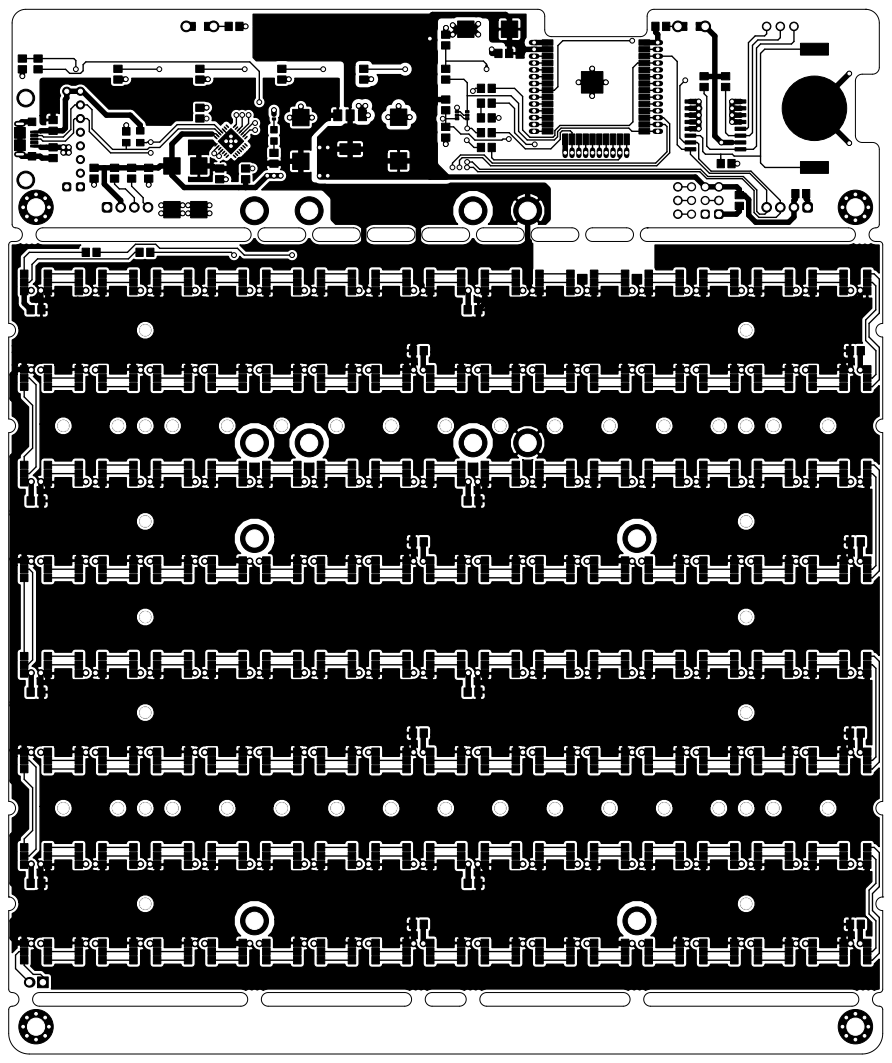
[picture p122: page 1]

https://github.com/wyolum/ClockIOT
File: ClockIOT.kicad_pcb Sheet: www.wyolum.com
