wyolum/ClockIOT/kicad_v3/ClockIOT_pdf/ClockIOT-F.SilkS.pdf

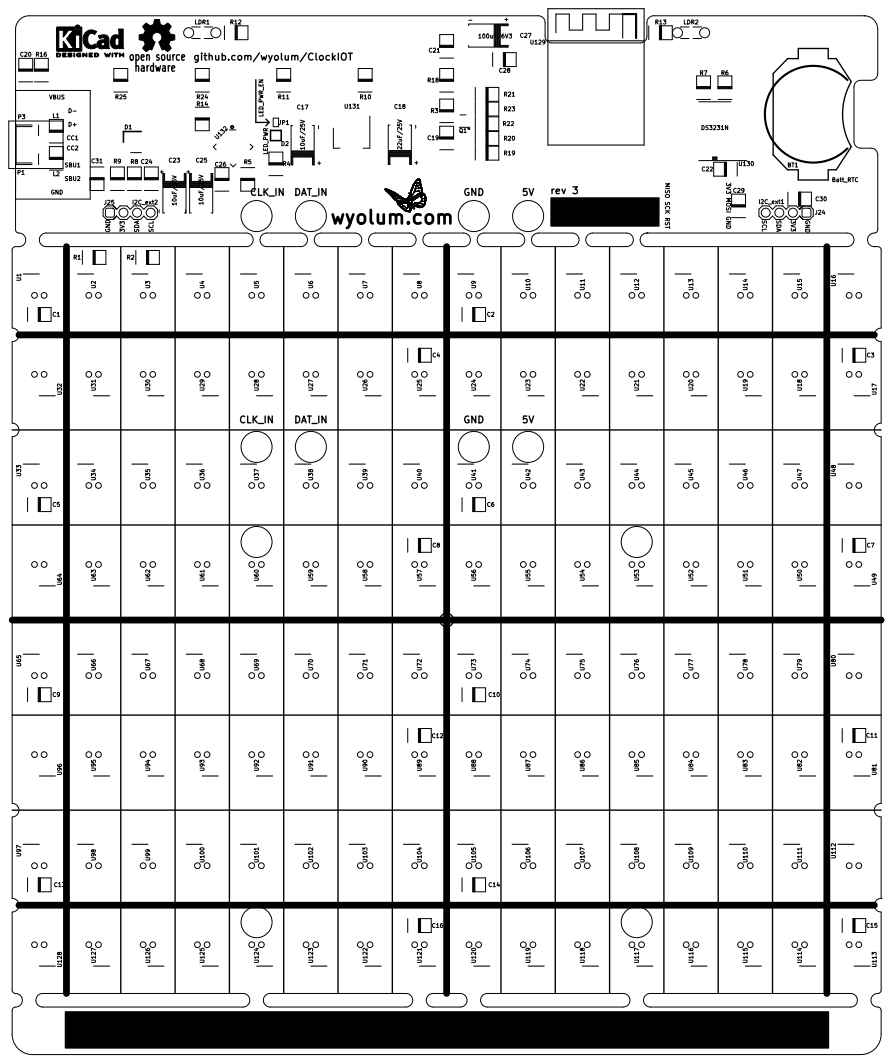
[picture p123: page 1]

D2 LED_PWR U123 | U129

https://github.com/wyolum/ClockIOT
File: ClockIOT.kicad_pcb Sheet: www.wyolum.com
