wyolum/ClockIOT/kicad/kicad_old_versions/kicad_v4/seeed_production_files/ClockIOT_ASSEMBLY/ciot_backplate_01.pdf

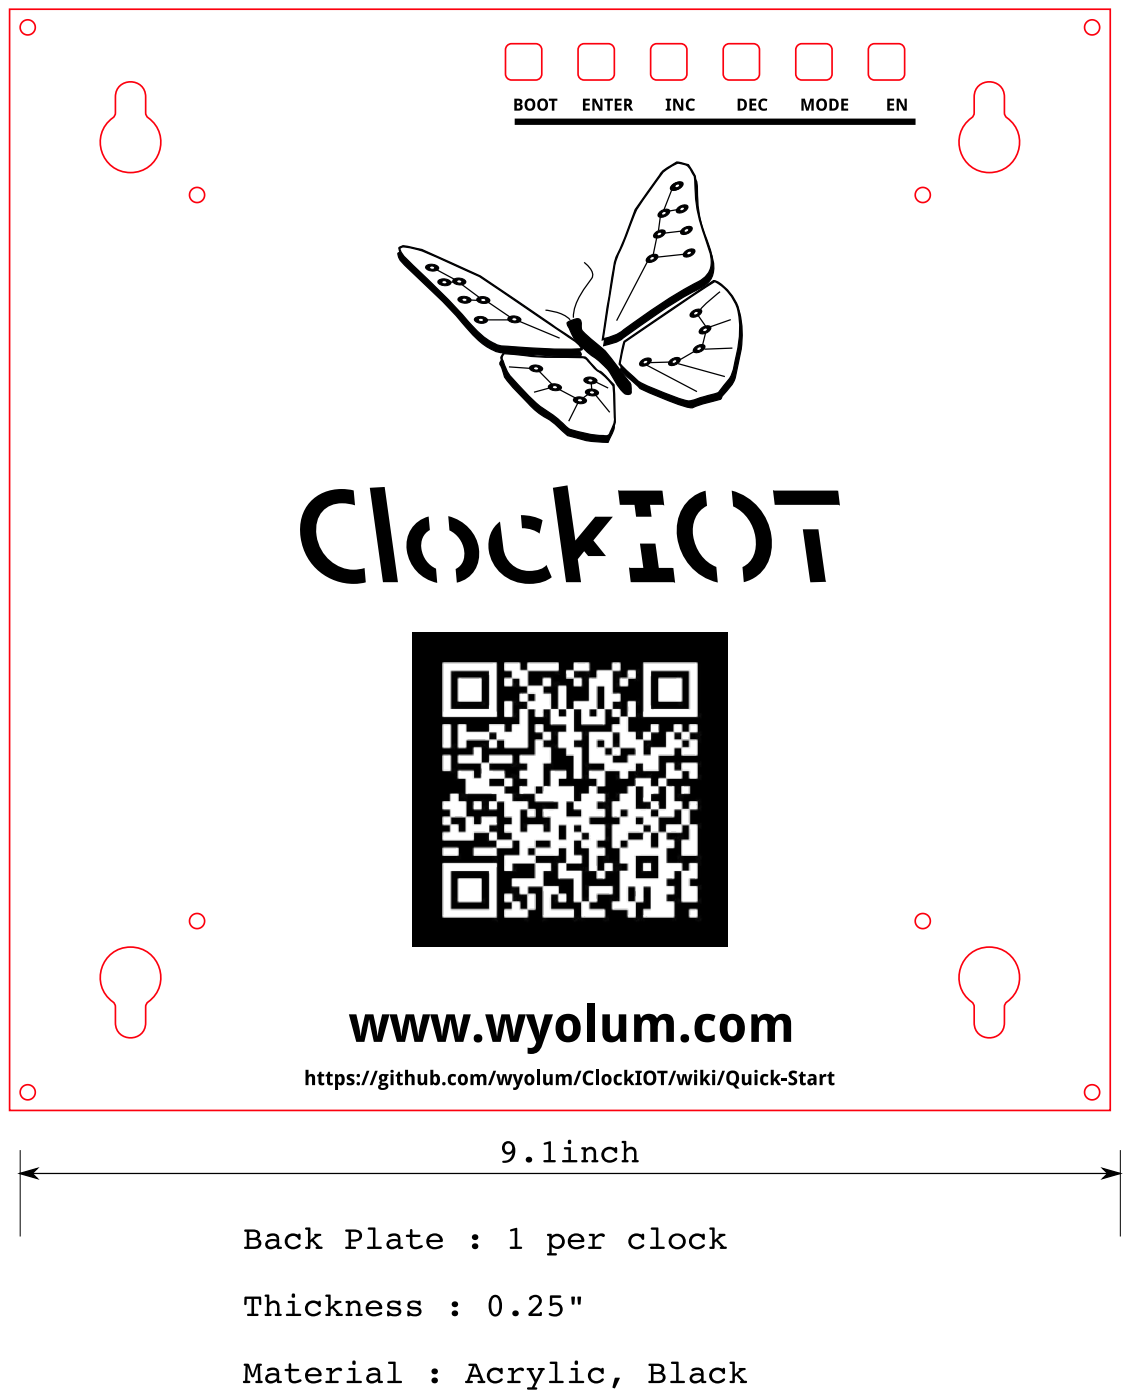
[picture p124: page 1]
