wyolum/ClockIOT/kicad/ClockIOT_data/USB-C_breakout/USB-C_pololu/USB-C_pololu.kicad_pcb

## KiCad design kicad/ClockIOT_data/USB-C_breakout/USB-C_pololu/USB-C_pololu.kicad_pcb (2018-10-19)

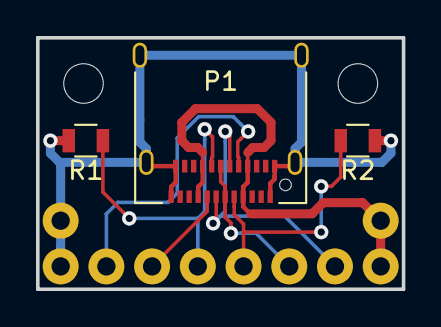
[picture p125: board USB-C_pololu.kicad_pcb from above]

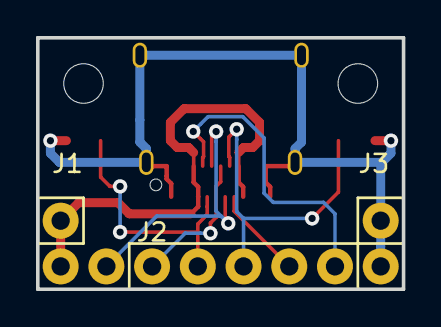
[picture p126: board USB-C_pololu.kicad_pcb from below]

Board: 2 copper layers, 20.3 x 14.0 mm, 6 parts (3 on the bottom side), 8 nets.

Parts:
J1: VBUS; Socket_Strip_Straight_1x02
J2: IO; Socket_Strip_Straight_1x06
J3: GND; Socket_Strip_Straight_1x02
P1: USB_C_Receptacle; USB_C_Receptacle_Amphenol_12401610E4-2A
R1, R2: 5k11; R_0805

Connections:
/CC1: J2.3, P1.A5, R2.1
/CC2: J2.4, P1.B5, R1.1
/D+: J2.2, P1.A6, P1.B6
/D-: J2.1, P1.A7, P1.B7
/SBU1: J2.5, P1.A8
/SBU2: J2.6, P1.B8
/VBUS: J1.1, J1.2, P1.A4, P1.A9, P1.B4, P1.B9
GND: J3.1, J3.2, P1.A1, P1.A12, P1.B1, P1.B12, P1.S1, R1.2, R2.2
