wyolum/ClockIOT/kicad/ClockIOT.sch

## KiCad design kicad/ClockIOT.sch (2020-01-27)

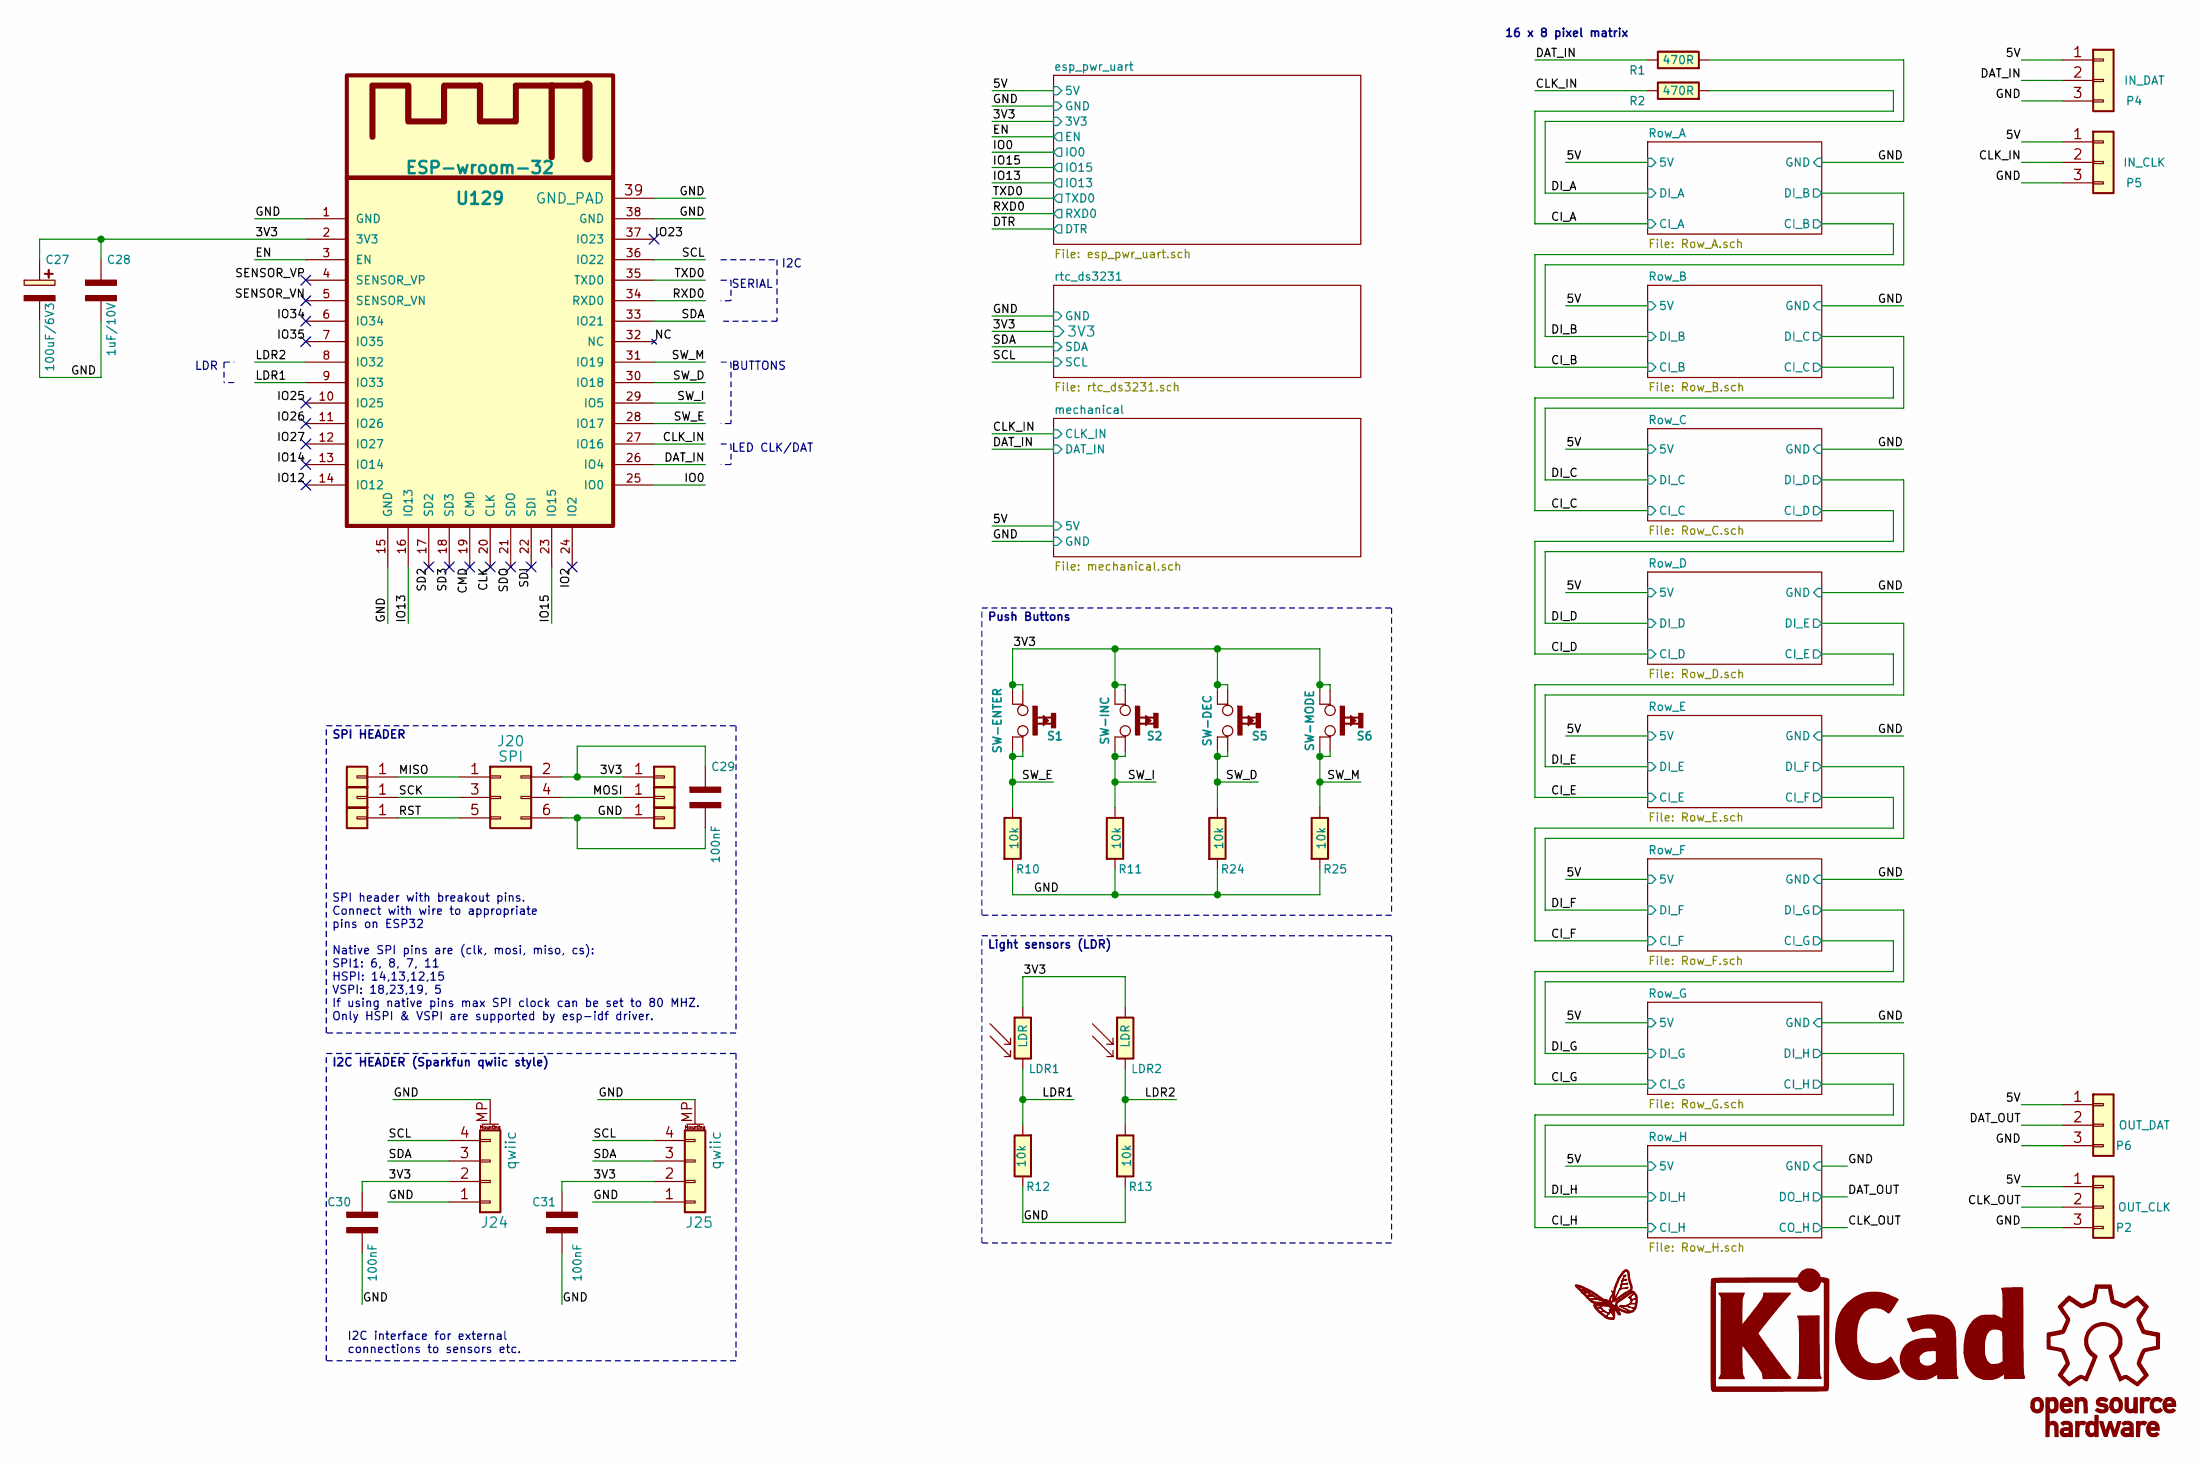
[picture p127: schematic ClockIOT.sch]

Parts:
C27: 100uF/6V3; c_2917
C28: 1uF/10V; c_0805
C29, C30, C31: 100nF; c_0805
G1: LOGO_WL; Logo-WL3
G2: KiCad; KiCad-Logo2_6mm_SilkScreen
G3: OSHW; OSHW_6mm
J17: MISO; BreakOutPad
J18: 3V3; BreakOutPad
J19: SCK; BreakOutPad
J20: SPI; Header_ISP
J21: MOSI; BreakOutPad
J22: RST; BreakOutPad
J23: GND; BreakOutPad
J24, J25: qwiic; JST_SH_SM04B-SRSS-TB_1x04-1MP_P1.00mm_Horizontal
LDR1, LDR2: LDR; r_0805_ldr_2
P2: OUT_CLK; PinSocket_1x03_P2.54mm_Horizontal
P4: IN_DAT; PinSocket_1x03_P2.54mm_Horizontal
P5: IN_CLK; PinSocket_1x03_P2.54mm_Horizontal
P6: OUT_DAT; PinSocket_1x03_P2.54mm_Horizontal
R1, R2: 470R; r_0805
R10, R11, R12, R13, R24, R25: 10k; r_0805
S1: SW-ENTER; SW_SMD_311020004
S2: SW-INC; SW_SMD_311020004
S5: SW-DEC; SW_SMD_311020004
S6: SW-MODE; SW_SMD_311020004
U129: ESP-wroom-32; esp_wroom_32

Connections:
3V3: C27.1 (+), C28.1 (+), C29.1 (+), C30.2 (-), C31.2 (-), J18.1, J20.2, J24.2, J25.2, LDR1.1, LDR2.1, S1.1, S1.3, S2.1, S2.3, S5.1, S5.3, S6.1, S6.3, U129.2 (3V3)
5V: P2.1, P4.1, P5.1, P6.1
CI_A: R2.2
CLK: U129.20 (CLK)
CLK_IN: P5.2, R2.1, U129.27 (IO16)
CLK_OUT: P2.2
CMD: U129.19 (CMD)
DAT_IN: P4.2, R1.1, U129.26 (IO4)
DAT_OUT: P6.2
DI_A: R1.2
EN: U129.3 (EN)
GND: C27.2 (-), C28.2 (-), C29.2 (-), C30.1 (+), C31.1 (+), J20.6, J23.1, J24.1, J24.MP (MountPin), J25.1, J25.MP (MountPin), P2.3, P4.3, P5.3, P6.3, R10.2, R11.2, R12.1, R13.2, R24.2, R25.2, U129.1 (GND), U129.15 (GND), U129.38 (GND), U129.39 (GND_PAD)
IO0: U129.25 (IO0)
IO2: U129.24 (IO2)
IO12: U129.14 (IO12)
IO13: U129.16 (IO13)
IO14: U129.13 (IO14)
IO15: U129.23 (IO15)
IO23: U129.37 (IO23)
IO25: U129.10 (IO25)
IO26: U129.11 (IO26)
IO27: U129.12 (IO27)
IO34: U129.6 (IO34)
IO35: U129.7 (IO35)
LDR1: LDR1.2, R12.2, U129.9 (IO33)
LDR2: LDR2.2, R13.1, U129.8 (IO32)
MISO: J17.1, J20.1
MOSI: J20.4, J21.1
NC: U129.32 (NC)
RST: J20.5, J22.1
RXD0: U129.34 (RXD0)
SCK: J19.1, J20.3
SCL: J24.4, J25.4, U129.36 (IO22)
SD2: U129.17 (SD2)
SD3: U129.18 (SD3)
SDA: J24.3, J25.3, U129.33 (IO21)
SDI: U129.22 (SDI)
SDO: U129.21 (SDO)
SENSOR_VN: U129.5 (SENSOR_VN)
SENSOR_VP: U129.4 (SENSOR_VP)
SW_D: R24.1, S5.2, S5.4, U129.30 (IO18)
SW_E: R10.1, S1.2, S1.4, U129.28 (IO17)
SW_I: R11.1, S2.2, S2.4, U129.29 (IO5)
SW_M: R25.1, S6.2, S6.4, U129.31 (IO19)
TXD0: U129.35 (TXD0)

Notes on the sheet:
16 x 8 pixel matrix
Push Buttons
Light sensors (LDR)
BUTTONS
LED CLK/DAT
I2C
SERIAL
LDR
Native SPI pins are (clk, mosi, miso, cs): SPI1: 6, 8, 7, 11 HSPI: 14,13,12,15 VSPI: 18,23,19, 5 If using native pins max SPI clock can be set to 80 MHZ. Only HSPI & VSPI are supported by esp-idf driver.
SPI header with breakout pins. Connect with wire to appropriate pins on ESP32
I2C interface for external connections to sensors etc.
SPI HEADER
I2C HEADER (Sparkfun qwiic style)
