wyolum/ClockIOT/kicad/esp_pwr_uart.sch

## KiCad design kicad/esp_pwr_uart.sch (2020-01-27)

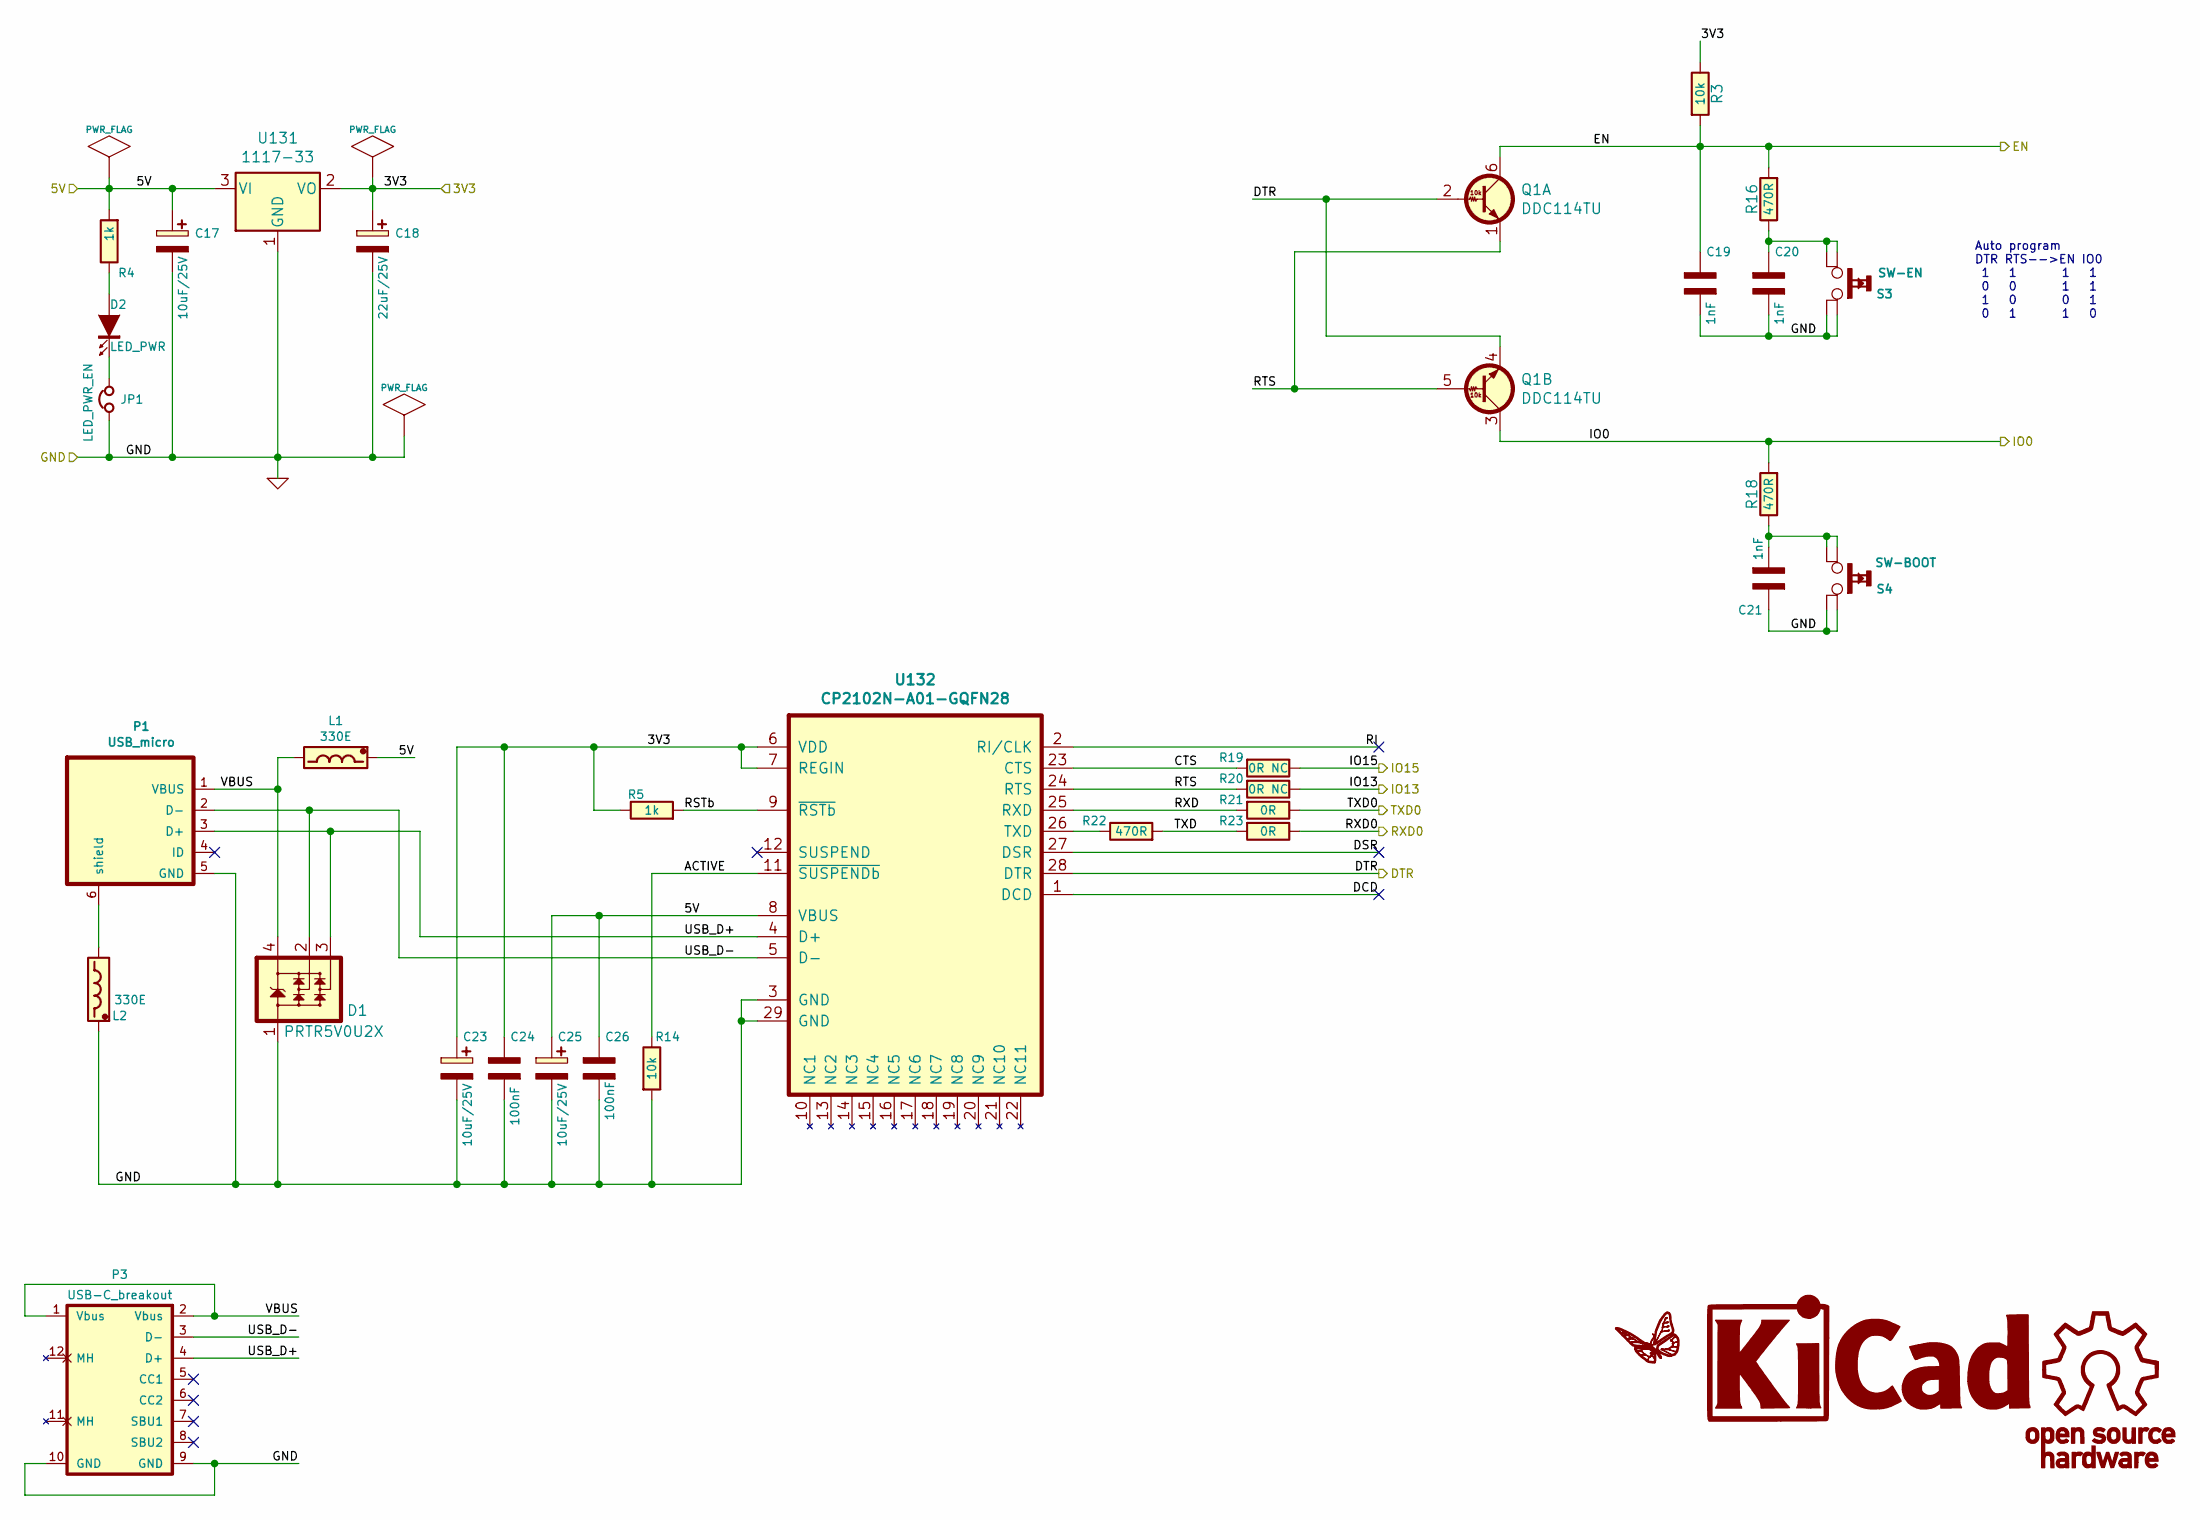
[picture p128: schematic esp_pwr_uart.sch]

Parts:
C17, C23, C25: 10uF/25V; c_2917
C18: 22uF/25V; c_2917
C19, C20, C21: 1nF; c_0805
C24, C26: 100nF; c_0805
D1: PRTR5V0U2X; SOT-143
D2: LED_PWR; LED-0805
G7: LOGO_WL; Logo-WL3
G8: KiCad; KiCad-Logo2_6mm_SilkScreen
G9: OSHW; OSHW_6mm
JP1: LED_PWR_EN; R_0402
L1, L2: 330E; r_0805
P1: USB_micro; USB_Micro-B_seeed-320010561
P3: USB-C_breakout; USB-C_bout
Q1: DDC114TU; SOT-363_SC-70-6
R3, R14: 10k; r_0805
R4, R5: 1k; r_0805
R16, R18, R22: 470R; r_0805
R19, R20: 0R NC; r_0805
R21, R23: 0R; r_0805
S3: SW-EN; SW_SMD_311020004
S4: SW-BOOT; SW_SMD_311020004
U131: 1117-33; SOT-223-3_TabPin2
U132: CP2102N-A01-GQFN28; QFN-28-1EP_5x5mm_Pitch0.5mm

Connections:
3V3: C18.1 (+), C23.1 (+), C24.1 (+), R3.1, R5.1, U131.2 (VO), U132.6 (VDD), U132.7 (REGIN)
5V: C17.1 (+), C25.1 (+), C26.1 (+), L1.1, R4.2, U131.3 (VI), U132.8 (VBUS)
ACTIVE: R14.1, U132.11 (~SUSPENDb)
CTS: R19.2, U132.23 (CTS)
DCD: U132.1 (DCD)
DSR: U132.27 (DSR)
DTR: Q1.2 (B1), Q1.4 (E2), U132.28 (DTR)
EN: C19.1 (+), Q1.6 (C1), R3.2, R16.2
GND: C17.2 (-), C18.2 (-), C19.2 (-), C20.2 (-), C21.1 (+), C23.2 (-), C24.2 (-), C25.2 (-), C26.2 (-), D1.1, JP1.1, L2.1, P1.5 (GND), P3.9 (GND), P3.10 (GND), R14.2, S3.1, S3.3, S4.1, S4.3, U131.1 (GND), U132.3 (GND), U132.29 (GND)
IO0: Q1.3 (C2), R18.2
IO13: R20.1
IO15: R19.1
unnamed: C20.1 (+), R16.1, S3.2, S3.4
unnamed: C21.2 (-), R18.1, S4.2, S4.4
unnamed: D2.1 (A), R4.1
unnamed: D2.2 (K), JP1.2
unnamed: L2.2, P1.6 (shield)
unnamed: R22.1, U132.26 (TXD)
RI: U132.2 (RI/CLK)
RSTb: R5.2, U132.9 (~RSTb)
RTS: Q1.1 (E1), Q1.5 (B2), R20.2, U132.24 (RTS)
RXD: R21.2, U132.25 (RXD)
RXD0: R23.1
TXD: R22.2, R23.2
TXD0: R21.1
USB_D+: D1.3, P1.3 (D+), P3.4 (D+), U132.4 (D+)
USB_D-: D1.2, P1.2 (D-), P3.3 (D-), U132.5 (D-)
VBUS: D1.4, L1.2, P1.1 (VBUS), P3.1 (Vbus), P3.2 (Vbus)

Notes on the sheet:
Auto program DTR RTS-->EN IO0 1 1 1 1 0 0 1 1 1 0 0 1 0 1 1 0
