wyolum/ClockIOT/kicad/rtc_ds3231.sch

## KiCad design kicad/rtc_ds3231.sch (2020-01-27)

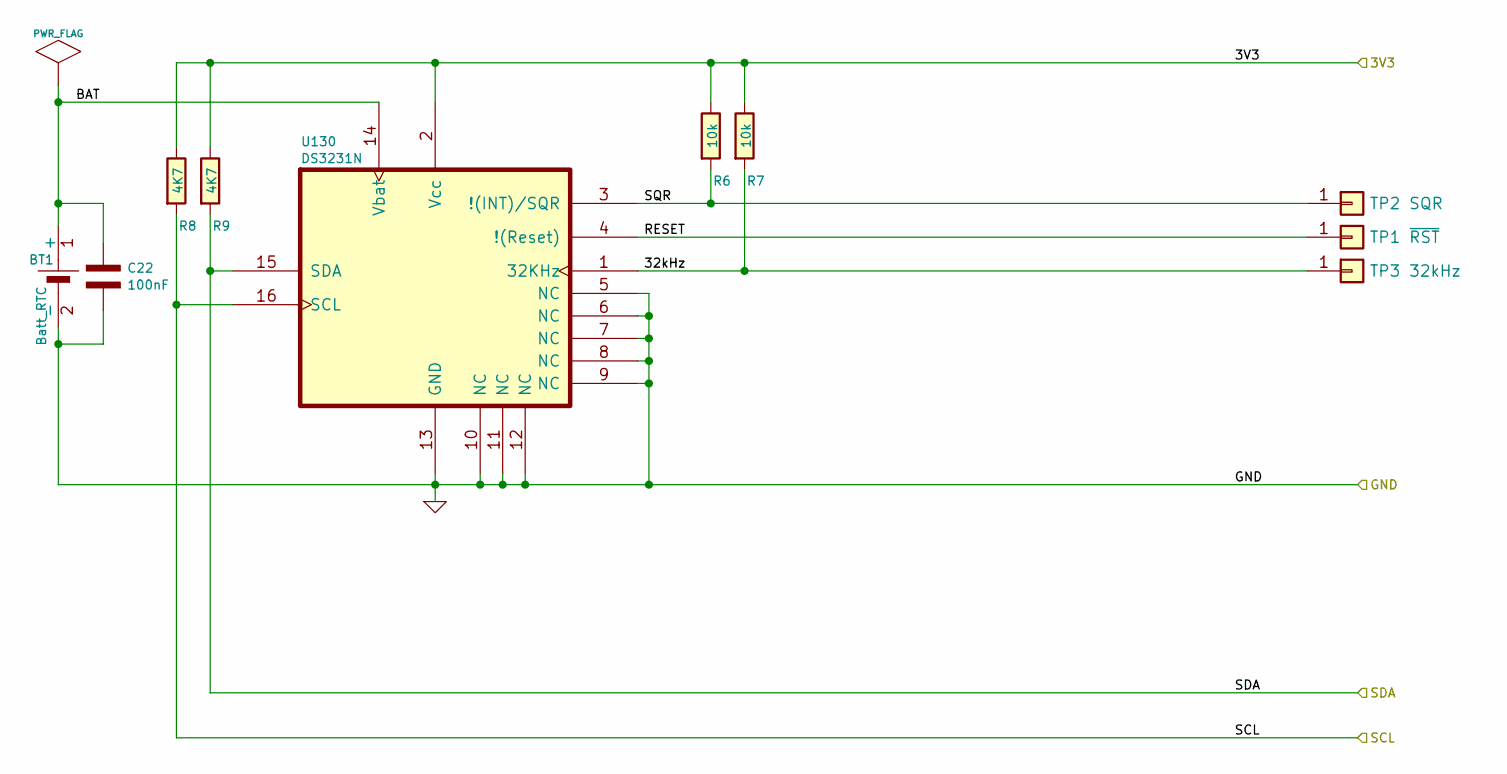
[picture p129: schematic rtc_ds3231.sch]

Parts:
BT1: Batt_RTC; CR2032_SMD_SKST-2007D; Digikey BU2032SM-HD-GCT-ND
C22: 100nF; c_0805
R6, R7: 10k; r_0805
R8, R9: 4K7; r_0805
TP1: ~RST; BreakOutPad
TP2: SQR; BreakOutPad
TP3: 32kHz; BreakOutPad
U130: DS3231N; DS3231

Connections:
3V3: R6.1, R7.1, R8.1, R9.1, U130.2 (Vcc)
32kHz: R7.2, TP3.1, U130.1 (32KHz)
BAT: BT1.1 (+), C22.1 (+), U130.14 (Vbat)
GND: BT1.2 (-), C22.2 (-), U130.5 (NC), U130.6 (NC), U130.7 (NC), U130.8 (NC), U130.9 (NC), U130.10 (NC), U130.11 (NC), U130.12 (NC), U130.13 (GND)
RESET: TP1.1, U130.4 (!(Reset))
SCL: R8.2, U130.16 (SCL)
SDA: R9.2, U130.15 (SDA)
SQR: R6.2, TP2.1, U130.3 (!(INT)/SQR)
