wyolum/ClockIOT/arduino/Chromogram2/english2_v1.h

#define N_BYTE_PER_HOUR 4
#define N_BYTE_PER_MINUTE 4

static const char HOUR_WORDS[] PROGMEM = {
     32, // # words
      0,  0,  2,       3,  0,  2,      13,  4,  3,      16,  4,  3,     // words
     19,  4,  5,      24,  4,  4,      28,  4,  4,       0,  5,  3,     // words
      3,  5,  5,       8,  5,  5,      13,  5,  4,      17,  5,  3,     // words
     20,  5,  6,      26,  5,  6,       7,  6,  2,      10,  6,  3,     // words
     14,  6,  7,      22,  6,  2,      27,  6,  5,      24,  6,  8,     // words
      0,  7,  2,       3,  7,  3,       7,  7,  9,      12,  7,  4,     // words
     17,  7,  2,      20,  7,  3,      24,  7,  7,       0,  0,  0,     // words
      0,  0,  0,       0,  0,  0,       0,  0,  0,       0,  0,  0,     // words
};

static const char HOUR_SEQ[] PROGMEM = {
   4, // number of bytes per state
//                             a                      
//                             f  m                   
//                             t  i  m         e      
//                  te         e  d  o         v      
//       t          wl  es     r  nn r         e      
//     ffh          ee nie    nn  ii n         n      
//    siorto      t lvtigv    oot gg i         it     
//    ivuewnii    hiveenhe    oohihhan         nhi    
//    xereoest    enennetn    nnentttg         gen    
    0b00000011, 0b00100000, 0b00001000, 0b00000000, 
    0b00000111, 0b11000000, 0b00000001, 0b00000000, 
    0b00001011, 0b11000000, 0b00000001, 0b00000000, 
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
    0b00001000, 0b00000000, 0b10000000, 0b01010000, 
    0b00010000, 0b00000000, 0b10000000, 0b01010000, 
    0b00100000, 0b00000000, 0b10000000, 0b01010000, 
    0b01000000, 0b00000000, 0b10000000, 0b01010000, 
    0b10000000, 0b00000000, 0b10000000, 0b01010000, 
    0b00000000, 0b00000001, 0b10000000, 0b01010000, 
    0b00000000, 0b00000010, 0b10000000, 0b01010000, 
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
    };
