wyolum/ClockIOT/(commit log)

2018-03-22 initial commit (copyied and renamed from KlokTHREEjr
    [default.csv, minimal.csv]
2018-03-25 renamed clock.h to prevent conflicts
    [get_time.cpp, get_time.h]
2018-04-08 transferred Kicad files from old repo
    [ClockIOT-B.Cu.gbl, ClockIOT-B.Mask.gbs, ClockIOT-B.Paste.gbp, ClockIOT-B.SilkS.gbo, ClockIOT-Edge.Cuts.gm1, ClockIOT-F.Cu.gtl, ClockIOT-F.Mask.gts, ClockIOT-F.Paste.gtp]
2018-06-02 _v0 is prototype, _v1 has USB/Batt on top side. All parts on top side = WIP
    [ClockIOT-B.Cu.gbl, ClockIOT-B.Mask.gbs, ClockIOT-B.Paste.gbp, ClockIOT-B.SilkS.gbo, ClockIOT-Edge.Cuts.gm1, ClockIOT-F.Cu.gtl, ClockIOT-F.Mask.gts, ClockIOT-F.Paste.gtp]
2018-06-03 fix up various references
    [ClockIOT.ino, get_time.cpp]
2018-06-03 moved all parts to top layer except buttons
    [ClockIOT-B.Cu.gbl, ClockIOT-B.Mask.gbs, ClockIOT-B.Paste.gbp, ClockIOT-B.SilkS.gbo, ClockIOT-Edge.Cuts.gm1, ClockIOT-F.Cu.gtl, ClockIOT-F.Mask.gts, ClockIOT-F.Paste.gtp]
2018-06-04 copied lost schematic library from KlokTHREEjr to ClockIOT
    [ClockIOT.sch, ClockIOT_BoM.ods, ClockIOT_BoM_seeed.ods, ClockIOT_BoM_seeed.xls, ClockIOT_PCB_specification.xlsx, ClockIOT_pcb_BoM.csv, D_1006-LLP1006-2L.step, D_LLP1006-2L.step]
2018-06-04 layout WIP
    [ClockIOT.sch, Row_A.sch, Row_B.sch, Row_C.sch, Row_D.sch, Row_E.sch, Row_F.sch, Row_G.sch]
2018-06-04 ClockIOT new version layout complete. All parts on top layer. Gerbers ready
    [ClockIOT-B.Cu.gbl, ClockIOT-B.Mask.gbs, ClockIOT-B.Paste.gbp, ClockIOT-B.SilkS.gbo, ClockIOT-Edge.Cuts.gm1, ClockIOT-F.Cu.gtl, ClockIOT-F.Mask.gts, ClockIOT-F.Paste.gtp]
2018-06-05 Layout checked. Gerbers ready
    [ClockIOT-B.Cu.gbl, ClockIOT-B.Mask.gbs, ClockIOT-B.Paste.gbp, ClockIOT-B.SilkS.gbo, ClockIOT-Edge.Cuts.gm1, ClockIOT-F.Cu.gtl, ClockIOT-F.Mask.gts, ClockIOT-F.Paste.gtp]
2018-06-07 fix data and clock pins for Clockiot
    [ClockIOT.ino]
2018-06-10 Layoadded 'rev 2' to silk legend
    [ClockIOT-B.Cu.gbl, ClockIOT-B.Mask.gbs, ClockIOT-B.Paste.gbp, ClockIOT-B.SilkS.gbo, ClockIOT-Edge.Cuts.gm1, ClockIOT-F.Cu.gtl, ClockIOT-F.Mask.gts, ClockIOT-F.Paste.gtp]
2018-06-11 minor silk legend corrections
    [ClockIOT-B.Cu.gbl, ClockIOT-B.Mask.gbs, ClockIOT-B.Paste.gbp, ClockIOT-B.SilkS.gbo, ClockIOT-Edge.Cuts.gm1, ClockIOT-F.Cu.gtl, ClockIOT-F.Mask.gts, ClockIOT-F.Paste.gtp]
2018-06-12 prettified layout
    [ClockIOT-B.Cu.gbl, ClockIOT-B.Mask.gbs, ClockIOT-B.Paste.gbp, ClockIOT-B.SilkS.gbo, ClockIOT-Edge.Cuts.gm1, ClockIOT-F.Cu.gtl, ClockIOT-F.Mask.gts, ClockIOT-F.Paste.gtp]
2018-06-26 replaced microUSB, Switches, Batt Holder, Capacitor per seeed suggestions
    [ClockIOT-B.Cu.gbl, ClockIOT-B.Mask.gbs, ClockIOT-B.Paste.gbp, ClockIOT-B.SilkS.gbo, ClockIOT-Edge.Cuts.gm1, ClockIOT-F.Cu.gtl, ClockIOT-F.Mask.gts, ClockIOT-F.Paste.gtp]
2018-09-04 updated flows
2018-10-06 BoM update, Buttons
    [ClockIOT_BoM_seeed.ods, ClockIOT_BoM_seeed.xls]
2018-10-17 adding USB-C breakout to PCB
2018-10-18 added USB-C breakout footprint to PCB
    [ClockIOT-B.Cu.gbl, ClockIOT-B.Mask.gbs, ClockIOT-B.Paste.gbp, ClockIOT-B.SilkS.gbo, ClockIOT-Edge.Cuts.gm1, ClockIOT-F.Cu.gtl, ClockIOT-F.Mask.gts, ClockIOT-F.Paste.gtp]
2018-10-19 Added USB-C breakout board addon to PCB
    [PinHeader_1x02_P2.54mm_Vertical.step, PinHeader_1x06_P2.54mm_Vertical.step, PinSocket_1x02_P254mm_Vertical.step, PinSocket_1x06_P254mm_Vertical.step, R_0805_2012Metric.step, USB-C-1054500101.step, USB-C_bout.step, USB-C_pololu.kicad_pcb]
2018-10-19 rev 4 gerbers
    [ClockIOT-B.Cu.gbl, ClockIOT-B.Mask.gbs, ClockIOT-B.Paste.gbp, ClockIOT-B.SilkS.gbo, ClockIOT-Edge.Cuts.gm1, ClockIOT-F.Cu.gtl, ClockIOT-F.Mask.gts, ClockIOT-F.Paste.gtp]
2018-10-21 added pullup for RST and pulldown for SUSPEND CP2102
    [ClockIOT-B.Cu.gbl, ClockIOT-B.Mask.gbs, ClockIOT-B.Paste.gbp, ClockIOT-B.SilkS.gbo, ClockIOT-Edge.Cuts.gm1, ClockIOT-F.Cu.gtl, ClockIOT-F.Mask.gts, ClockIOT-F.Paste.gtp]
2018-10-27 minor updates and bug fix to ClockIOT_gui
    [ClockIOT.ino, ClockIOT_gui.py]
2018-10-28 added low pwr mode to prevent brown outs when programming. hold enter while booting to go to low pwr mode
    [ClockIOT.ino, ClockIOT_gui.py]
2018-10-30 new rev 3 Gerbers, PDF, renders, BoM
    [ClockIOT-B.Cu.gbl, ClockIOT-B.Mask.gbs, ClockIOT-B.Paste.gbp, ClockIOT-B.SilkS.gbo, ClockIOT-Edge.Cuts.gm1, ClockIOT-F.Cu.gtl, ClockIOT-F.Mask.gts, ClockIOT-F.Paste.gtp]
2018-11-03 added get_displays message to web sockets
2018-11-10 added clockiot/timezone_offset//IP command to revert to using IP address for timezone offset
    [ClockIOT.ino, ClockIOT_gui.py]
2018-11-12 fixed use_ip_timezone automatic settings
    [ClockIOT.ino]
2018-11-14 rev 4, added 3 pin headers for CLK/DAT/GND for building bigger matrices
    [ClockIOT-B.Cu.gbl, ClockIOT-B.Mask.gbs, ClockIOT-B.Paste.gbp, ClockIOT-B.SilkS.gbo, ClockIOT-Edge.Cuts.gm1, ClockIOT-F.Cu.gtl, ClockIOT-F.Mask.gts, ClockIOT-F.Paste.gtp]
2018-11-19 added from __future__ import print_function to some files
2018-12-17 Fixed wrong case include preventing compile on linux
    [Faceplate.cpp]
2018-12-17 Added language selector and fixed default display choice
    - Added a basic language list and selector
    - Fixed a bug where the currently selected display would not be the
    default selection of the display list
2019-02-02 Fixed faceplate list from api
    After inthisreality stuff, the N_FACEPLATE variable was too large, which
    caused the websocket interface to return invalid JSON when asked for the
    list of faceplates. I also commented a inthisreality thing that was
    causing errors.
    [ClockIOT.ino]
2019-02-02 Fixed modal CSS and made modals easier to reuse and changed previous modals to match
    Now, you can just pass a div's CSS query to new Modal to turn that div
    into a modal.
    var modal = new Modal('#timezone-modal');
    Also, added a openButton() method to modal that returns prebuilt button
    you can attach to any node and change the text.
    ```javascript
    var button = modal.openButton();
    button.innerText = 'Super awesome panel';
    randomDiv.appendChild(button);
    ```
    I used this functionality to neaten up index.html and clockiot.js
2019-02-02 added color wheel code and image
2019-02-18 Improved Display and Language selection
    - Removed "Set Display" button, now it changes as you change the
    dropdown selection
    - Changed language list to remove all faceplates but the latest version,
    unless developerMode is true
    - Added settings object, currently only read from
    - TODO:Add settings panel
2019-03-10 Added loading wheel and improved css
    I changed the select styling to make it consistent across all browsers,
    and also modified the clock selection so that the ui only shows that
    until you select a clock, at which point it shows a loading wheel until
    the display list is populated and it shows all the controls
2019-08-28 added esp32 version of WyoBean
    [calendar_baffles.scad, calendar_baffles.stl, calendar_baffles_8x24.stl, calendar_baffles_middle.stl]
2019-08-28 working on WyoBean32 http bug
    [WyoBean32.ino]
2019-09-08 Assembly CAD and BoM
    [ClockIOT-B.Cu.gbl, ClockIOT-B.Mask.gbs, ClockIOT-B.Paste.gbp, ClockIOT-B.SilkS.gbo, ClockIOT-B_Cu.gbl, ClockIOT-B_Mask.gbs, ClockIOT-B_Paste.gbp, ClockIOT-B_SilkS.gbo]
2019-09-09 Seeed production files, Assembly CAD and BoM
    [ClockIOT-B_Cu.gbl, ClockIOT-B_Mask.gbs, ClockIOT-B_Paste.gbp, ClockIOT-B_SilkS.gbo, ClockIOT-Edge_Cuts.gm1, ClockIOT-F_Cu.gtl, ClockIOT-F_Mask.gts, ClockIOT-F_Paste.gtp]
2019-09-09 ClockIoT new back plate
    [ClockIOT_BoM_seeed_RetailClock_v4.xls, backplate_jr_std1.0.dxf, baffles_jr_std1.0_H.dxf, baffles_jr_std1.0_V.dxf, baffles_jr_std1.0_localizer.dxf]
2019-09-09 new CAD renders
2019-09-16 ClockIoT faceplate PDF added
    [ClockIOT_C3jrHW_BoM_seeed_RetailClock_v4.xls]
2019-09-25 added led test to every start
2019-11-08 Fixed set_timezone_from_ip bug that used Sunday==0 (wrong) to Sunday==1 (right).
    [ClockIOT.ino]
2019-11-09 reverted version of wifi manager to version 14
    [ClockIOT.ino]
2019-11-29 updated ClockIoT BoM
    [ClockIOT_BoM_seeed_RetailClock_v4.xls, ClockIOT_C3jrHW_BoM_seeed_RetailClock_v4.xls]
2019-11-30 added stand from Nick
    [C3Jr Stand - V4.stl]
2019-12-05 ClockIOT.ino is first production version, debugging button crashes
    [ClockIOT_MFGTest.ino]
2019-12-06 minimal changes to get to compile (strange that production code did not compilegit reset --hard HEAD WTF?)
    [ClockIOT.ino]
2019-12-06 Fixed resetting bug caused by accessing ds3231 and/or ntp before setup was complete
    [ClockIOT.ino]
2019-12-07 created small python app to control clock. fixed use_ntp bug
    [ClockIOT.ino, commander.py]
2019-12-07 disabled buttons on ClockIOT commander.py
2019-12-09 cleaned up folder structure
    [ClockIOT-B.Cu.gbl, ClockIOT-B.Mask.gbs, ClockIOT-B.Paste.gbp, ClockIOT-B.SilkS.gbo, ClockIOT-Edge.Cuts.gm1, ClockIOT-F.Cu.gtl, ClockIOT-F.Mask.gts, ClockIOT-F.Paste.gtp]
2019-12-12 Fixed get_time.cpp to fall back to realtime clock when NTP clock is not initialized
    [ClockIOT.ino, get_time.cpp, get_time.h]
2019-12-14 Work in progress rework of webui Switched from custom CSS to bootstrap Removed color picker, use html5 color input type
2019-12-16 added ClockIOT.stl stand
    [ClockIOT.stl]
2019-12-25 added backup url (direct to ipapi) in case wyolum fails
    [ClockIOT.ino]
2019-12-27 adding 2-board clock Chromogram
2019-12-27 First draft of 2-board clock 'Chromogram2'
2019-12-27 fixed Chromogram to display the right time
    [Chromogram2.ino]
2020-01-02 added Nick's chomorgram stand
    [Chromogramv1_stand.stl]
2020-01-26 KiCad v5 - new expansion headers, new qwiic headers, wider breakoff tabs
    [ClockIOT-B_Cu.gbl, ClockIOT-B_Mask.gbs, ClockIOT-B_Paste.gbp, ClockIOT-B_SilkS.gbo, ClockIOT-Edge_Cuts.gm1, ClockIOT-F_Cu.gtl, ClockIOT-F_Mask.gts, ClockIOT-F_Paste.gtp]
2020-01-27 v5 BOM and new back plate design
    [ClockIOT.sch, ClockIOT_BoM.ods, ClockIOT_BoM_seeed.ods, ClockIOT_BoM_seeed.xls, ClockIOT_BoM_seeed_RetailClock_v4.xls, ClockIOT_PCB_specification.xlsx, ClockIOT_pcb_BoM.csv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]
2020-02-05 updated backplate and BoM
